pasrom/grabtastic/Electronic_Stuff/Datasheets/Atmel_Layout/Readme.txt

Filelist:
CAD_Source\* :Altium source files for the kit
Gerber\SAMD20_Xplained_Pro_release_rev6.GTL : Gerber file for Top Layer
Gerber\SAMD20_Xplained_Pro_release_rev6.GTO : Gerber file for Top Overlay (silkscreen)
Gerber\SAMD20_Xplained_Pro_release_rev6.GTP : Gerber file for Top Paste-mask
Gerber\SAMD20_Xplained_Pro_release_rev6.GTS : Gerber file for Top Solder-mask
Gerber\SAMD20_Xplained_Pro_release_rev6.GP1 : Gerber file for Internal Plane 1 (GND)
Gerber\SAMD20_Xplained_Pro_release_rev6.GP2 : Gerber file for Internal Plane 2 (PWR)
Gerber\SAMD20_Xplained_Pro_release_rev6.GBL : Gerber file for Bottom Layer
Gerber\SAMD20_Xplained_Pro_release_rev6.GBO : Gerber file for Bottom Overlay (silkscreen)
Gerber\SAMD20_Xplained_Pro_release_rev6.GBP : Gerber file for Bottom Paste-mask
Gerber\SAMD20_Xplained_Pro_release_rev6.GBS : Gerber file for Bottom Solder-mask
Gerber\SAMD20_Xplained_Pro_release_rev6.GM1 : Gerber file for Mechanical 1 layer (board outline)
SAMD20_Xplained_Pro_design_documentation_release_rev6.PDF : Schematic, PCB Prints, PCB 3D Prints, Assembly Drawings, BOM 
ExportSTEP\SAMD20_Xplained_Pro_release_rev6.STEP : 3D model of PCBA
