pasrom/grabtastic/Documenation/group_4_grabtastic/_invalid/group_4_grabtastic.tex

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

% XML

\usepackage{color}
\definecolor{gray}{rgb}{0.4,0.4,0.4}
\definecolor{darkblue}{rgb}{0.0,0.0,0.6}
\definecolor{cyan}{rgb}{0.0,0.6,0.6}
\lstdefinelanguage{XML}
{
  morestring=[b]",
  morestring=[s]{>}{<},
  morecomment=[s]{<?}{?>},
  stringstyle=\color{black},
  identifierstyle=\color{darkblue},
  keywordstyle=\color{cyan},
  morekeywords={xmlns,version,type}% list your attributes here
}

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

\renewcommand*{\chapterheadstartvskip}{\vspace*{-2\baselineskip}}% Abstand einstellen

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

\newcommand{\uC}{$\mu C$ }

\begin{document}

\pagenumbering{gobble} % seitenzahlnummerierung unterdrücken

% evtl. Sperrvermerkseite
%Falls erforderlich (nur in begründeten Fällen): Sperrvermerk

% Titelblatt:
\newpage
\begin{titlepage}
 %   \includegraphics[width=0.4\textwidth]{pictures/grabtastic.pdf}
  \mbox{}
  \vspace{5mm}
  \begin{center}
    \huge{\textbf{\sffamily Technical Documentation}} \\
    \huge{\textbf{\sffamily Group 4: Grabtastic}}\\
  \end{center}
  \vspace{40mm}
  \begin{flushright}
%  Bachelorarbeit [1 bzw. 2 anführen]\\
%  zur Erlangung des akademischen Grades\\
%  Bachelor of Science in Engineering (BSc)

  \vspace{20mm}
  Fachhochschule Vorarlberg\\
  Mechatronics

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

  \vspace{20mm}
  Dornbirn, December, 2015
  \end{flushright}
\end{titlepage}

%% evtl. Widmung:
%\chapter*{[Evtl. Widmung]}
%
%
%% Abstract:
%\newpage
\chapter*{Abstract}

The Grabtastic is built to grab a circular disc and then moved from one position to one other target position. These positions are predefined and can be two targets: home or \acs{Repository} position. Also the machine has to go to the reference position, but this cannot be done with the disc attached. Controlling the Grabtastic will be done with the \acs{PLC} and with the \acs{uC}. The \acs{PLC} will control the X and Y axis while the \acs{uC} will handle the movement of the Z axis. 

\pagenumbering{Roman} 

% Kurzreferat:
%\newpage
%\chapter*{Kurzreferat}
%[Deutschen Titel anführen]
%
%Formatvorlage für den Fließtext.

% evtl. Vorwort:
%\newpage
%\chapter*{[Evtl. Vorwort]}
%
\tableofcontents

\clearpage
\phantomsection
\addcontentsline{toc}{chapter}{List of Figures}
\listoffigures

\clearpage
\phantomsection
\addcontentsline{toc}{chapter}{List of Tables}
\listoftables
\addcontentsline{toc}{chapter}{Listings}
\lstlistoflistings

% evtl. Abkürzungsverzeichnis:
\newpage
\chapter*{List of Abbreviations}

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

\chapter{Introduction}
\pagenumbering{arabic} % seitenzahlnummerierung ab hier beginnen

This project started on the seventh of September 2015 and will end on the fifteenth of December. In this fifth semester of our studies, there is an exchange semester. This allows us to have a multi-cultural experience with different students from different backgrounds. It was our goal to combine our background experience to finish this project and also to learn how to work in an international project group.\\
The project was arranged by the FH Vorarlberg and lead by R. Amann. It consisted of building a manipulator that can pick up and drop a disc, it had to be controlled with a PLC. During the project the project group also participated in courses that supported the build of the project, for example: how to write a requirements document or how to program a PLC. Within this project there were certain boundaries for example the components that had to be used, but this also gave us more time to come up with creative solution for the remaining components. The system had to be built according to the system design that was given in the beginning of the project (\autoref{fig:system overview}).\\
To maintain the progress in this project we used a schedule that was given to us by the professors. This schedule contained deadlines for different results and general guidelines. Our first assignment in September was the requirements document, which consisted of the customer needs, requirements and our vision about the end result. In October we started designing all the components, this with the help of the courses there were earlier mentioned. After this we began manufacturing the parts that were designed until the end of November. Finally in December the testing of the build components and the assembly of these started. In the end of the project we are presenting our creation to the professors, students and other stakeholders. Therefore the manipulator had to be fully functional on the fifteenth of December. 

\section{Purpose}

This documentation is written for customers of project group \enquote{Grabtastic} to get  information of the manipulator we developed. The manipulator is used to pick up and place an aluminium disc, also move it in third dimention - X, Y, and Z axis. Every steps are made automatically.

\section{Scope}

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

\section{Overview}

The project group is named \enquote{Grabtastic}. The manipulator does one cycle at one time. Those are actions that the manipulator does for one cycle.

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

\section{References}

All drawings, charts, code listings and datasheets are indicated in the appendix.

\section{Division of the Tasks}

There are responsible people for each part (\autoref{tab:system overview with develop}).

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

\chapter{System Description}

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

\section{Product Overview}

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

For this product the project group decided that the Grabtastic should be able to function autonomously while the user only gives the command to move. Therefore it has to sense if the disc is grabbed or he has to get the disc from the \acs{Repository}, this is done with the strain gauge. The signal from the strain gauge will be amplified by the amplifier circuit and the send to the \acs{ADC} in the \acs{uC}. Then the \acs{RS232} communication will send this via a telegram to the \acs{PLC}, this is done via the \acs{SPI} protocol. The disc will be placed in the \acs{Repository} that is designed so the disc can be easily removed by the snap connection. When the Grabtastic moved to its target position the Z axis has to be moved in order to grab or release the disc, this is done via the designed Z axis and via the motor controller. The user is able to control and monitor the machine with the user interface that is made in the \acs{PLC}. All the components are installed on the brackets, which are placed on the base of the system above the Z-axis and the snap connection.

\section{System Overview}

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

\chapter{Mechanical Components}

\section{\acs{Repository}}\label{sec:repository}

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

\section{Z-Axis}

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

\subsection{Motorholder}
This part has several tasks to fulfil. The main function is to fix the stepper motor. In addition to this the holding elements for the \acs{uC} are attached to this part. \autoref{fig:motor frame side view} shows the holes which are used to fix the motor. 

  \begin{figure} [H]
        \centering
        \begin{subfigure}[b]{0.45\textwidth}
                \centering
                
                \caption{side view}\label{fig:motor frame side view}
        \end{subfigure}%
        ~ % An dieser Stelle kann ein zusätzlicher Zwischenraum eingebunden werden: ~, \quad, \qquad, \hfill usw.
          % Eine leere Zeile erzwingt, dass die zweite Grafik darunter erscheint.
        \begin{subfigure}[b]{0.45\textwidth}
                \centering
                
                \caption{front view}\label{fig:motor frame front view}
        \end{subfigure}
        \caption[Motor holder]{Motor holder\\
        Source: Group 4}\label{fig:motor frame}
  \end{figure}

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

\subsubsection{Calculation of the Force for Grab Cycle}

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

Now all values which are necessary for the calculation of the shear force are known. 

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

\subsubsection{Calculation for the Drop Cycle}

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

The calculation for the section modulus is exactly the same than in the point above.

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

\begin{eqnarray}
F_{ges} &=& 4 * F\\
F_{ges} &=& 4 * 2.097N = 8.389 N
\end{eqnarray}

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

\subsection{\acs{FEA}}

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

\chapter{Electronic Components}

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

\section{Schematic}

In the left top corner in \autoref{fig:scematic_power_rs232_strain.pdf} the linear voltage regulator can be found. There are two capacitors (C13, C14) are for bypassing\footnote{the values are chosen from the \enquote{LM1086} data sheet page 18}

\section{Calculation}

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

With  \autoref{eq: gain generally}  the necessary gain is calculated.

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

The \autoref{eq: gain calculation} is from the IN128UA1 Datasheet.

\begin{eqnarray}
G=1+ \frac{50k \Omega}{R_{g}}\label{eq: gain calculation}
\end{eqnarray}

With \autoref{eq: gain calculation} the $R_{g}$ is calculated.

\begin{eqnarray}
R_{g} =  \frac{50k \Omega}{G-1}\label{eq: Rg calculation}
\end{eqnarray}

With \autoref{eq: Rg calculation} the necessary $R_{g}$ is calculated as $75,8 \Omega$

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

As we can see, the telegram is transmitted correctly.

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

\subsection{Calculation}\label{sec:calculation_drv8711}

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

AS can be seen, the values are like we expected it.

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

As can bee seen, the \acs{SPI} works good.

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

\subsection{Measurement}

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

\subsection{Schematic}
In \autoref{fig:emergency and limit switch} is the schematic shown from the emergency relay and the limit switch. There was no need to do a PCB layout, because we soldered it just together.
\begin{figure}[H]
  \centering
   
   \caption[Emergency and limit switch schematic]{Emergency and limit switch schematic\\
	Source: Group 4  
  }
   \label{fig:emergency and limit switch}
\end{figure}

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

\chapter{\acs{PLC}-Program}

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

\begin{figure}[H]
  \centering
   
   \caption[Welcome screen]{Welcome screen\\
	Source: Group 4}
   \label{fig:start view}
\end{figure} 

\begin{figure}[H]
  \centering
   
   \caption[Automatic mode]{Automatic mode\\
	Source: Group 4}
   \label{fig:automatic mode}
\end{figure} 

\chapter{Communication \acs{PLC} - \acs{uC}}

\section{Configuration of \acs{RS232}}\label{sec: config of rs232}

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

\section{Telegram from \ac{uC} to \ac{PLC}}
The telegram looks like the following:\\
<respond>/<$\#$ force value>/<z-axis position>/<error>\textbackslash r \textbackslash n
\begin{itemize}
\item The delimiter / is used to separate each value.
\item \textbackslash r \textbackslash n are used as suffix.
\item $\#$ to mark the value as force
\end{itemize}

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

\section{Heartbeat}

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

\chapter{\acs{uC} Program}

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

Used parts of the \acs{ASF}:

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

\begin{table}[H]
\centering
\begin{tabular}{|p{2.5cm}|p{2.8cm}|p{5.8cm}|p{3.5cm}|}
\hline
Pin on EXT2 & SAM D20 pin & Function                & Used for                 \\ \hline
5           & PA20        & GPIO                    & DRV8711 Sleep            \\ \hline
6           & PA21        & GPIO                    & DRV8711 reset            \\ \hline
7           & PA22        & TC4/WO[0]               & DRV8711 \acs{TC}         \\ \hline
9           & PB14        & EXTINT[14]              & DRV8711 change direction \\ \hline
15          & PA17        & SERCOM1 PAD[1] SPI SS   & DRV8711 SPI              \\ \hline
16          & PA18        & SERCOM1 PAD[2] SPI MOSI & DRV8711 SPI              \\ \hline
17          & PA16        & SERCOM1 PAD[0] SPI MISO & DRV8711 SPI              \\ \hline
18          & PA19        & SERCOM1 PAD[3] SPI SCK  & DRV8711 SPI              \\ \hline
19          & -           & GND                     &                          \\ \hline
20          & -           & VCC                     &                         \\ \hline
\end{tabular}
\caption{EXT2 used pins}
\label{fig:EXT2 used pins}
\end{table}

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

\section{Calculations}

\subsection{Sampling Rate of the \acs{ADC}}

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

With the reciprocal value the sampling rate is calculated.

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

$0,125ms$ are fast enough to measure the force.

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

\section{Main Loop}

In \autoref{fig:Mainprogramm.pdf} the loop of the main program is shown according to the \acs{UML} standards.
\begin{figure}[H]
  \centering
   
   \caption[UML Diagram \acs{uC}]{UML Diagram \acs{uC}\\
	Source: Group 4  
   }
   \label{fig:Mainprogramm.pdf}
\end{figure} 
\section{Programmed Functions}

\autoref{fig:h dateien} shows the included header files.

\begin{figure}[H]
  \centering
   
   \caption[included header files]{Included header files\\
	Source: Group 4  
   }
   \label{fig:h dateien}
\end{figure} 
The config$\_$focus$\_$fhv.t is developed by us. The callgraph of the main loop is shown in \autoref{fig:main call graph program}.\\
\begin{enumerate}
\item all configuration is loaded
\item main loop starts
\item start a request to read the receive buffer of \acs{RS232}
\item execute the received order
\item repositioning if we are in the limit switch in case of referencing
\item finish the order
\item start repositioning when down
\item send the telegram
\begin{enumerate}
\item error handling
\item prepare the telegram for sending
\item start a request to send the write buffer of \acs{RS232}
\end{enumerate}
\end{enumerate}

\begin{figure}[H]
  \centering
   
   \caption[Called functions \acs{uC}]{Called functions \acs{uC}\\
	Source: Group 4  
   }
   \label{fig:main call graph program}
\end{figure} 

\section{DRV8711 Register Settings}\label{DRV8711 register settings}

In \autoref{fig:DRV8711 registers} the adjusted values for the DRV8711 are shown.

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

\subsection{Speed Calculation}

\begin{eqnarray}
f_{steps} \, \mu steps /s &=& \frac{v*360^{\circ}*n_{m}}{60s/min*\phi \, ^{\circ}/step}\\
\rightarrow v &=& \frac{60 s / min*\phi \, ^{\circ}/step * f_{steps} \, \mu steps /s}{360^{\circ}*n_{m}}
\end{eqnarray}
$v ... rotations/min$\\
With following values the speed is calculated\footnote{found in the motor data sheet and \autoref{eq:frequency1}, \autoref{eq:frequency2}}\\
$\phi =1,8^{\circ}/step$\\
$n_{m}=1$\\
$f_{steps \, 1} = 421Hz$\\
$f_{steps \, 2} = 526Hz$
\begin{eqnarray}
v_{1} &=& \frac{60 s / min * 1,8 \, ^{\circ}/step * 421 \, \mu steps /s}{360^{\circ}*1}=126,3 \, rot/min\\
v_{2} &=& \frac{60 s / min * 1,8 \, ^{\circ}/step * 421 \, \mu steps /s}{360^{\circ}*1}=157,9 \, rot/min
\end{eqnarray}
\subsection{Conclusion DRV8711}
The discerning reader will also have noticed that the register settings did not match the calculations. The reason therefore is, that the motor is not turning smooth with the calculated values. We had to change them to our needs.

\chapter{Results}

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

%\section{Problems with mechanical construction}

%\section{Problems with \acs{PLC}}

%\section{Problems with \acs{uC}}

\section{Test runs}
The system runs as described in the requirements document.

\section{Mechanic}
In \autoref{fig:mechanic assembly} the finished Z-axis is shown.
  \begin{figure} [H]
        \centering
        \begin{subfigure}[b]{0.45\textwidth}
                \centering
                
              %  \caption{mechanic assembly}\label{fig:Seitl_1}
        \end{subfigure}%
        ~ % An dieser Stelle kann ein zusätzlicher Zwischenraum eingebunden werden: ~, \quad, \qquad, \hfill usw.
          % Eine leere Zeile erzwingt, dass die zweite Grafik darunter erscheint.
        \begin{subfigure}[b]{0.45\textwidth}
                \centering
                
               % \caption{register 4-7}\label{fig:Seitl_2}
        \end{subfigure}
        \caption[Mechanic assembly]{Mechanic assembly\\
         Source: Group 4}\label{fig:mechanic assembly}
  \end{figure}
  \newpage
   In \autoref{fig:rep_side_view} and \autoref{fig:rep_top_view} is the finished \acs{Repository} shown.
  \begin{figure}[H]
  \centering
   
   \caption[Finished \acs{Repository} top view]{Finished \acs{Repository} top view\\
	Source: Group 4  
   }
   \label{fig:rep_top_view}
\end{figure} 

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

\newpage

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

\chapter{Discussion}

In this chapter there will be given some problems that were faced during this project and how they were approached and solved.\\
For the mechanical part of this projects two problems occurred that affected the progress of the project. The first problem that was faced was the purchase of the linear axis which had to be bought with a shipment time of two weeks. This halted the progress for about two weeks and gave some time to focus more on the different aspects of the project like the \acs{Repository} and the manufacturing of the parts. And next there was a problem with the snap connection which was designed for the correct forces that were applied on it. The arms of the snapper are bended a little bit to the middle. Therefore the outer diameter of the snapper was just a little bit bigger than the hole in the disc. So the snapper was not able to hold the disc. The solution for this problem was a little aluminium rod with a diameter of $12mm$ which we set into the snap connector. This small rod bends the arms of the snapper to his original position and so the snapper was able to hold the disc.\\
Despite the problems that were faced for the mechanical part, the electronical part also suffered from some problems. The Atmel board and a DRV8711 broke shortly after the PCB was designed and a new board had to be used, this was caused by an overvoltage on the board. Also multiple parts were fried during the testing of the board, this was caused by a faulty connection or a short circuit. This never broke the board down completely and did not give major setbacks. The biggest problem was, that a view “vias” on the PCB did not conduct correctly. Therefore the charge pump of the DRV8711 did not work at the beginning when the board was recently manufactured. Moreover the pick and place machine did not solder two capacitors and the \enquote{MAX232}, therefore the board did not work correctly. This was caused by the charge pump because that did not work properly at the time.\\
As for the programming of the \acs{uC} and the \acs{PLC}the biggest problem was that we did not know how to use the \acs{ASF} library. But this was solved by using and studying the example programs that were provided by the Atmel studio.
Finally, we had some problems with the requirement document. It was not completely clear to us what we had to put in the document. This followed in editing the document several times which took some time. In the end the document was finished and we were all pleased with the result. In the end we changed some aspect of this document mostly because some names were changed during the project or that an extra safety principle was added in the use cases. Also we added some requirements about tolerances, this was done so this is also clear to the customer.

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

%\chapter*{[Evtl. Anhang]}
%\addcontentsline{toc}{chapter}{[Evtl. Anhang]}
%Formatvorlage für den Fließtext.

%\chapter*{Eidesstattliche Erklärung}
%\addcontentsline{toc}{chapter}{Eidesstattliche Erklärung}
%Ich erkläre hiermit an Eides statt, dass ich die vorliegende Bachelorarbeit selbstständig und ohne Benutzung anderer als der angegebenen Hilfsmittel angefertigt habe. Die aus fremden Quellen direkt oder indirekt übernommenen Stellen sind als solche kenntlich gemacht. Die Arbeit wurde bisher weder in gleicher noch in ähnlicher Form einer anderen Prüfungsbehörde vorgelegt und auch noch nicht veröffentlicht.
%
%\vspace{30mm}
%\noindent
%Verfasser/in\hfill                                       Unterschrift Verfasser/in
%
%\vspace{3mm}
%\noindent
%Dornbirn, am [Tag. Monat Jahr anführen]\hfill            Vor- und Nachname Verfasser/in
\appendix
\chapter{mechanics}
\section{drawings}
\begin{landscape}
\includepdf[pages={1-}]{datasheets/mechanical/psi5321_asseblyAxisGes.pdf}
\includepdf[pages={1-}]{datasheets/mechanical/psi5321_disk.pdf}
\includepdf[pages={1-}]{datasheets/mechanical/psi5321_frame1.pdf}

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

\section{\acs{ASF} library}

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

\section{Register settings Atmel}

\href{http://www.atmel.com/images/atmel-42129-sam-d20_datasheet.pdf}{Atmel SAM D20 Register Settings}

\chapter{\acs{PLC}}

\section{Program}
\include{listings/PLC_listings}

\section{Datasheets}

\includepdf[pages={1-}]{datasheets/PLC/Product_Overview_NOE2-2.pdf}
\includepdf[pages={1-}]{datasheets/PLC/ST5918M3008-A.pdf}

\end{document}
