pasrom/grabtastic/Documenation/UML/Electronic_overview.pdf

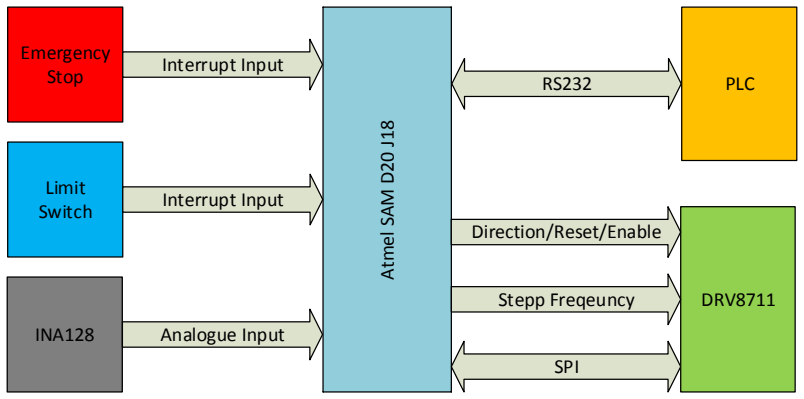
[picture p39: figure]
Atmel SAM D20 J18; SPI; DRV8711; PLC; Emergency; Stop; Interrupt Input; Direction; /Reset; /Enable; Stepp Freqeuncy; Limit; Switch; INA128; Analogue Input
