pasrom/grabtastic/Documenation/UML/Interrupt.pdf

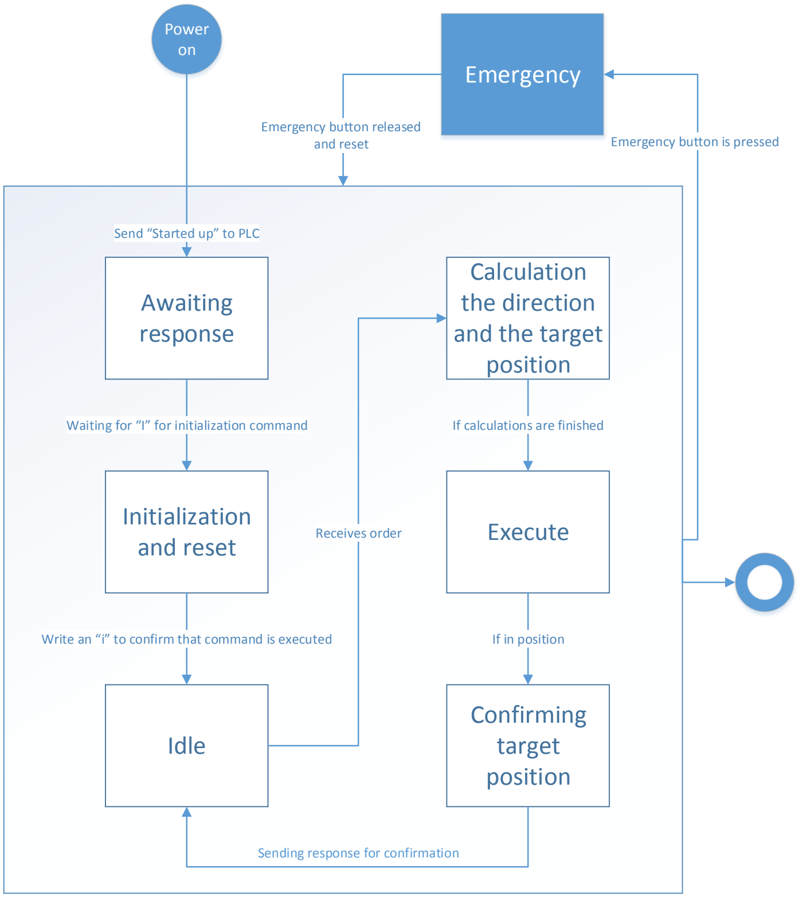
[picture p40: figure]
Execute; Power on; Calculation the direction and the target position; Initialization and reset; Idle; Awaiting response; Send “Started up” to PLC; Receives order; If calculations are finished; Confirming target position; If in position; Sending response for confirmation; Emergency; Emergency button released and reset Emergency button is pressed

Waiting for “I” for initialization command

Write an “i” to confirm that command is executed
