pasrom/grabtastic/Electronic_Stuff/calc_strain_gauge.xlsx

 | Grün (V) | Weiß (V) | Differenz (V) | Differenz (mV) | Eingang mV | Ausgang V
Normal | 2.088 | 2.063 | 0.025 | 25 | 25.4873 | 3.919 | 153.7628544
Zug | 2.084 | 2.066 | 0.018 | 18 | 22 | 3.891 | 176.8636364
Druck | 2.094 | 2.055 | 0.039 | 39 | 29 | 3.941 | 135.8965517
 |  |  |  |  |  |  | mV | Auflösung pro digit | Mittelpunkt V | min | max
 |  |  |  |  |  |  | 5 | 0.5 | 2.5 | 2.4975 | 2.5025
 |  |  |  |  |  |  |  | Gain |  | 0.0025 | 0.0025 | Range | Rang from uC
 |  |  |  |  |  |  |  | 660 |  | 1.65 | 1.65 | 0V-3,3V | 0V-3,3V
 |  |  |  |  |  |  |  | Rg
 |  |  |  |  |  |  |  | 75.87253414 | 20000 | N | 9990.224829
 |  |  |  |  |  |  | Scalingfactor | 0 | 1023 | digits | 511
 |  |  |  |  |  |  |  |  |  | 1024
 |  |  |  |  |  |  |  |  | 19.55034213
