pasrom/grabtastic/Documenation/group_4_grabtastic/pictures/grabtastic.pdf

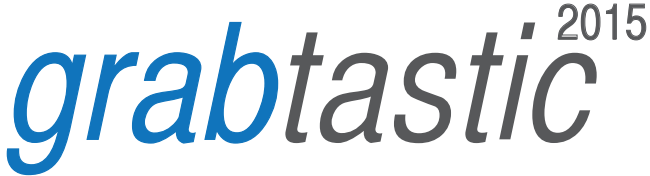
[picture p41: figure]
grabtastic²⁰¹⁵
