pasrom/grabtastic/Documenation/group_4_grabtastic/pictures/hDateien.pdf

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

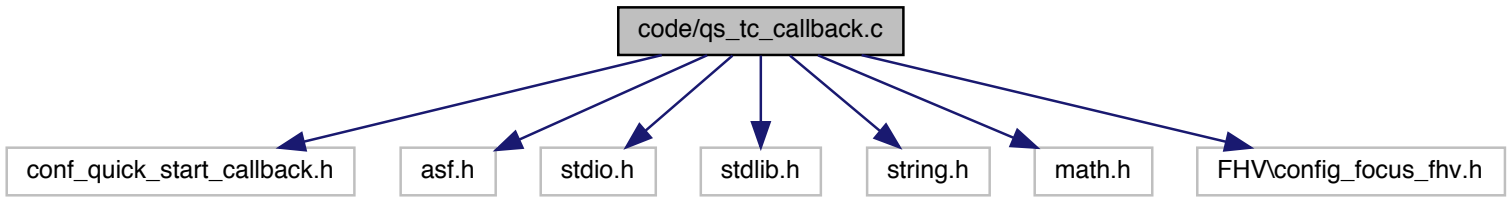
[picture p42: figure]
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
