pasrom/grabtastic/Documenation/group_4_grabtastic/pictures/Mainprogramm.png

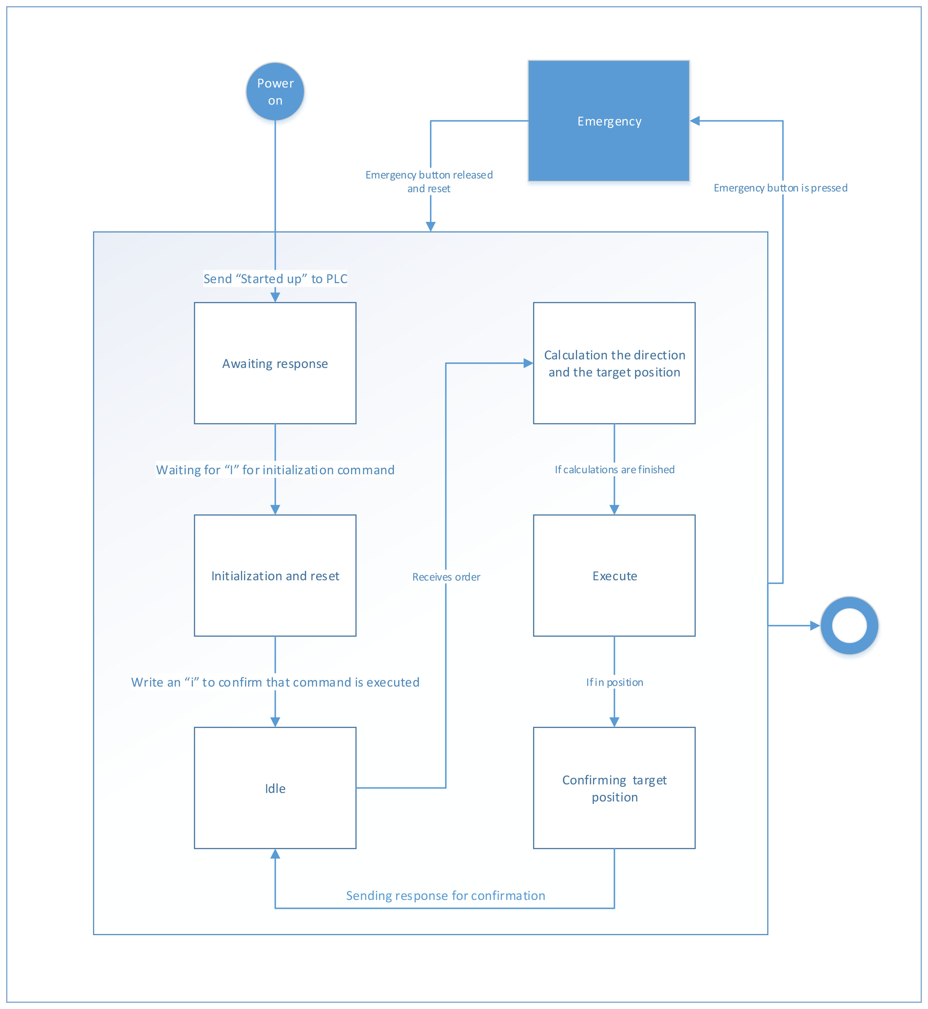
Documenation/group_4_grabtastic/pictures/Mainprogramm.png
