pasrom/grabtastic/Documenation/group_4_grabtastic/pictures/pcb_mounting_2.png

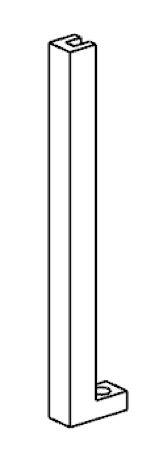
Documenation/group_4_grabtastic/pictures/pcb_mounting_2.png
