pasrom/grabtastic/Documenation/group_4_grabtastic/pictures/scematic_drv8711.png

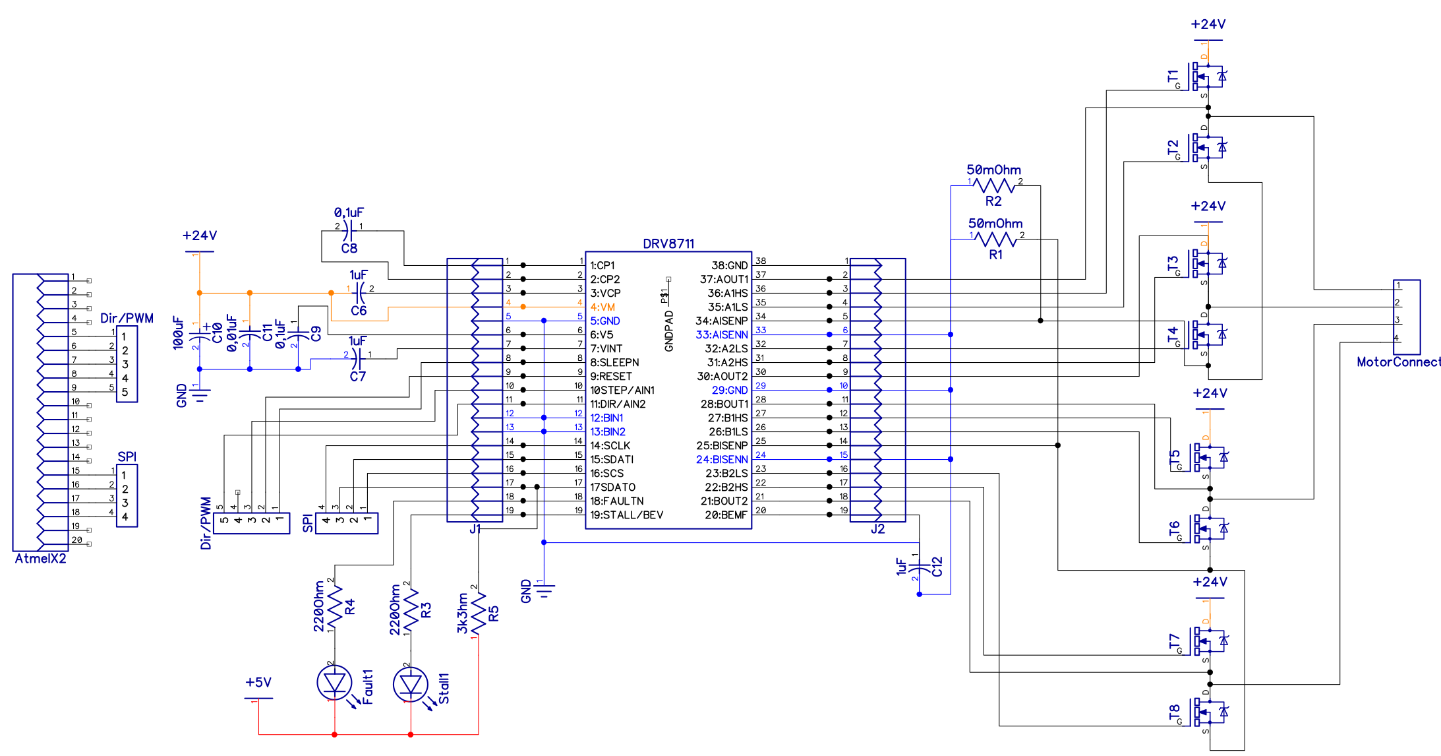
Documenation/group_4_grabtastic/pictures/scematic_drv8711.png
