pasrom/grabtastic/Documenation/group_4_grabtastic/pictures/spi_v0_0_1.png

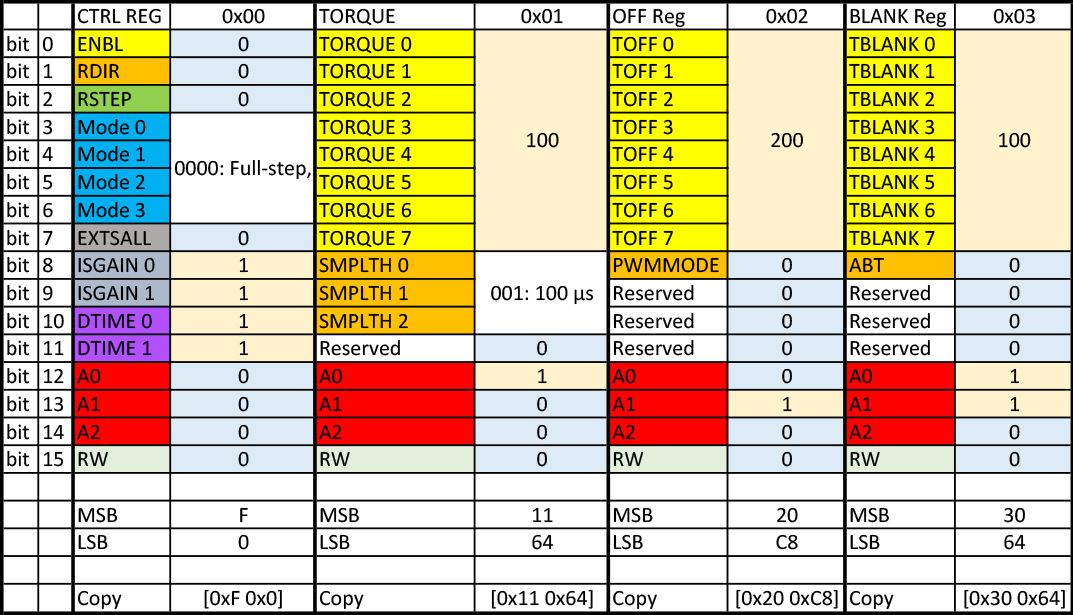
Documenation/group_4_grabtastic/pictures/spi_v0_0_1.png
