pasrom/grabtastic/Electronic_Stuff/PCB_Layout/Screenshot 2015-10-02 13.58.50.png

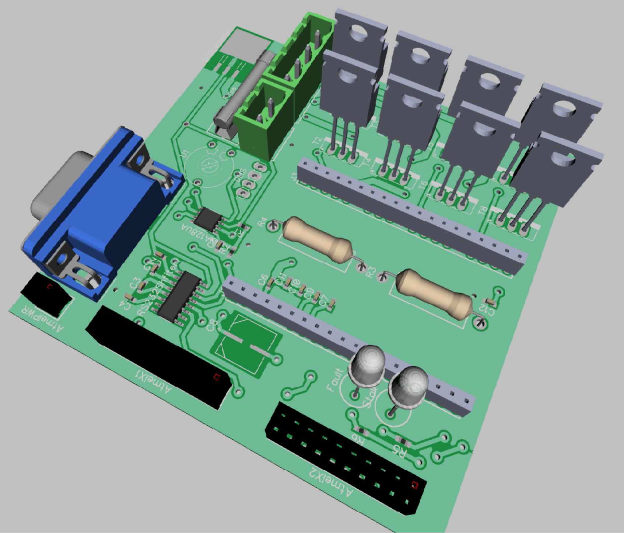
Electronic_Stuff/PCB_Layout/Screenshot 2015-10-02 13.58.50.png
