pasrom/grabtastic/Mechanical_Stuff/repositoryDesign/Drafting_Modified/BoltandNut/Bolt in lower part.jpg

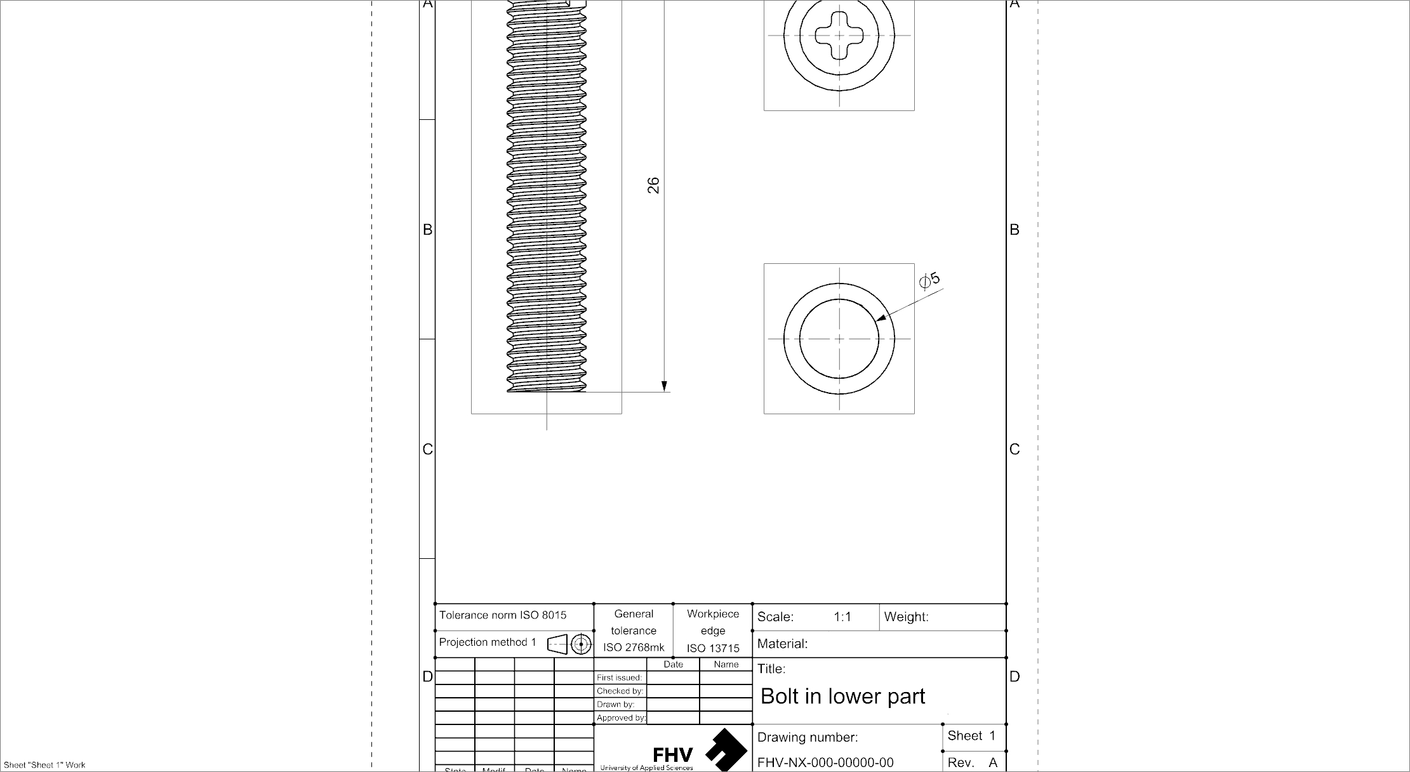
Mechanical_Stuff/repositoryDesign/Drafting_Modified/BoltandNut/Bolt in lower part.jpg
