pasrom/grabtastic/Mechanical_Stuff/repositoryDesign/Drafting_Modified/BoltandNut/Bolt in upper part.jpg

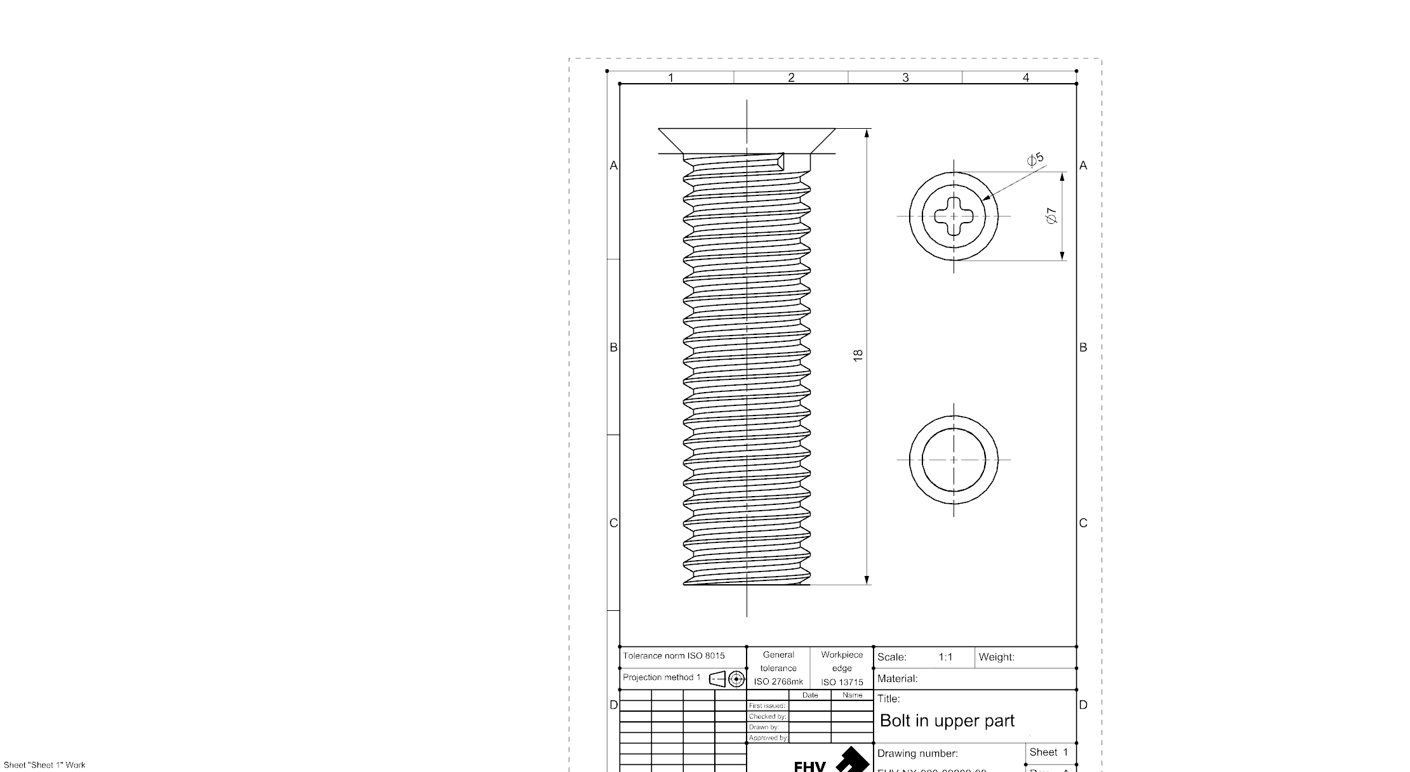
Mechanical_Stuff/repositoryDesign/Drafting_Modified/BoltandNut/Bolt in upper part.jpg
