pasrom/grabtastic/Mechanical_Stuff/repositoryDesign/Drafting_Modified/BoltandNut/Nut_between_plates.jpg

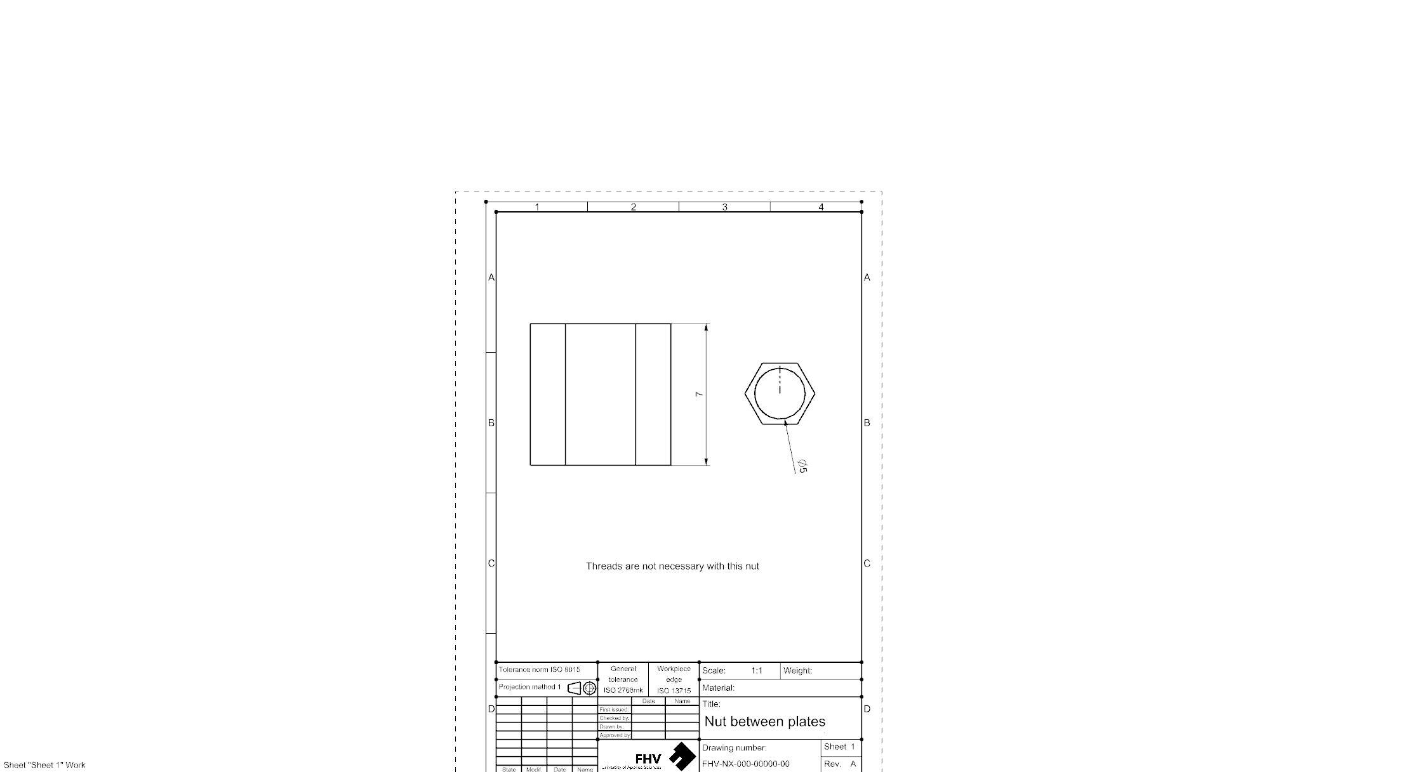
Mechanical_Stuff/repositoryDesign/Drafting_Modified/BoltandNut/Nut_between_plates.jpg
