pasrom/grabtastic/Mechanical_Stuff/repositoryDesign/Drafting_Modified/BoltandNut/Nut_in_lower_part.jpg

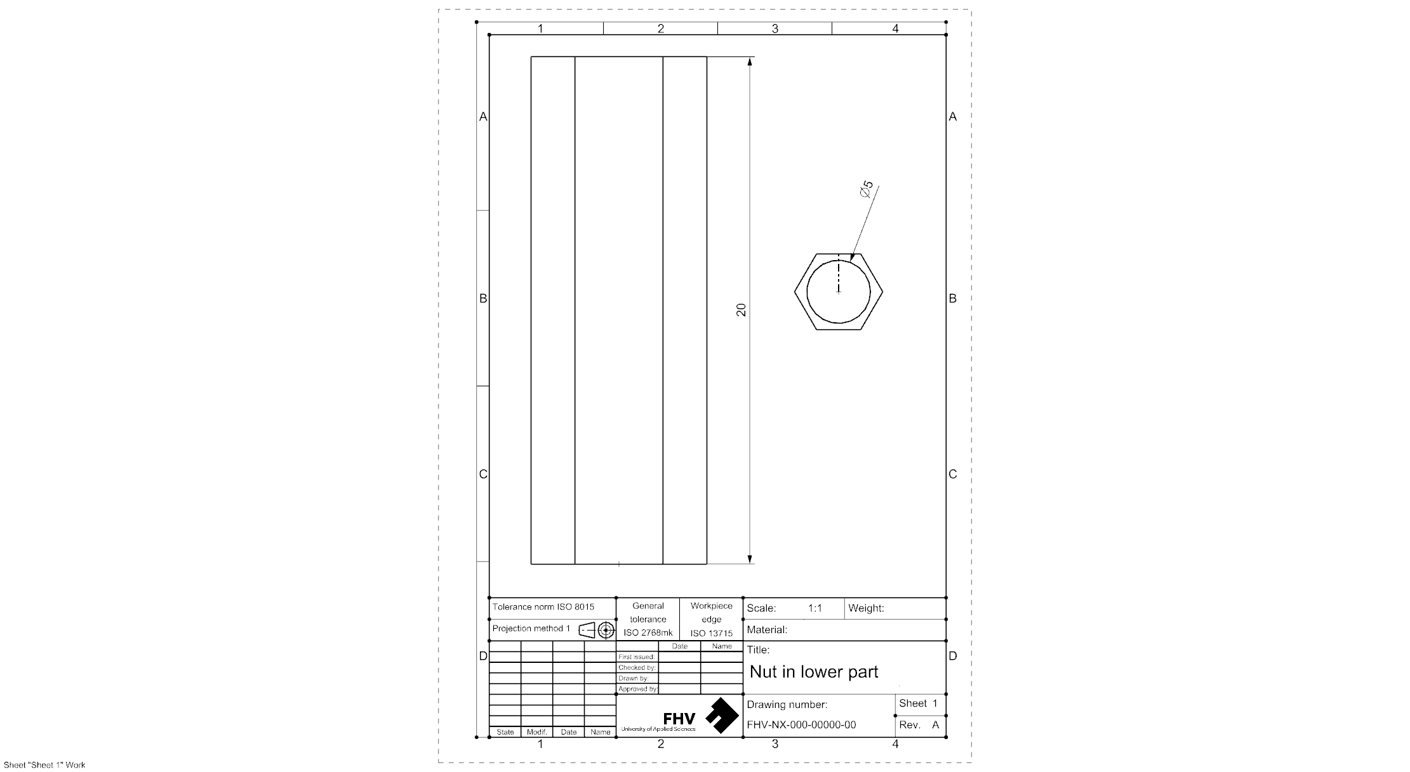
Mechanical_Stuff/repositoryDesign/Drafting_Modified/BoltandNut/Nut_in_lower_part.jpg
