pasrom/grabtastic/Mechanical_Stuff/repositoryDesign/Drafting_Modified/BoltandNut/shortnut.jpg

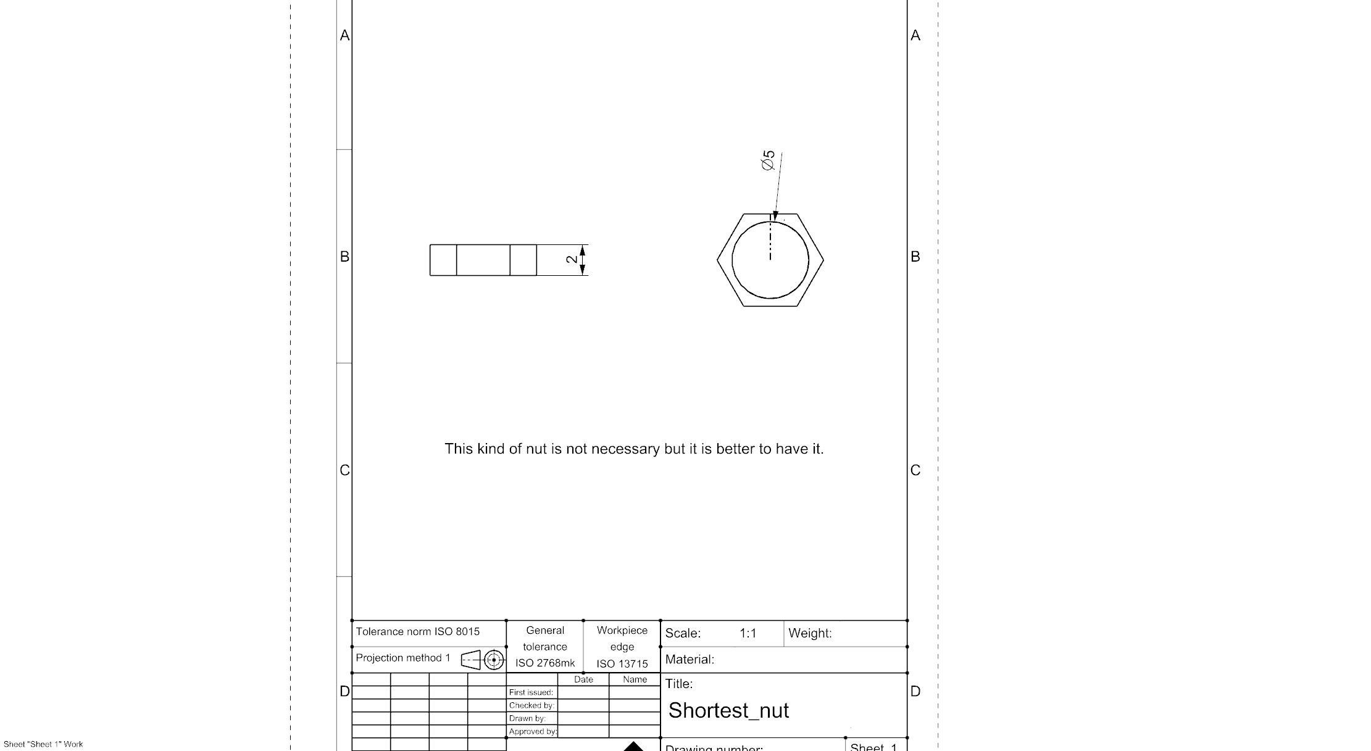
Mechanical_Stuff/repositoryDesign/Drafting_Modified/BoltandNut/shortnut.jpg
