pasrom/grabtastic/PLC/Motr_Drivers/Welcome1080.png

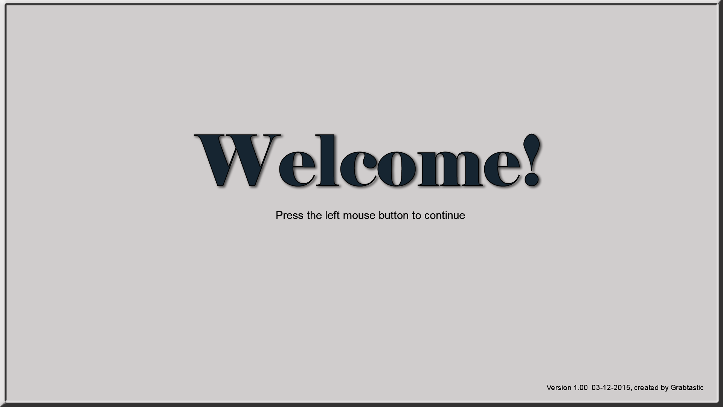
PLC/Motr_Drivers/Welcome1080.png
