pasrom/grabtastic/Microcontroller/spi_v0_0.xlsx

Sheet: Telegram
 |  |  |  |  |  |  |  | 48 |  | 128 |  | 16 |  | 64
 |  |  | CTRL REG | 0x00 | TORQUE | 0x01 | OFF Reg | 0x02 | BLANK Reg | 0x03 | DECAY Reg | 0x04 | Stall Reg | 0x05 | Drive | 0x06 | Status | 0x07
 | bit | 0 | ENBL | 0 | TORQUE 0 | 100 | TOFF 0 | 200 | TBLANK 0 | 100 | TDECAY 0 | 50 | SDTHR 0 | 64 | OCPTH 0 | 0 | OTS | 0
 | bit | 1 | RDIR | 0 | TORQUE 1 |  | TOFF 1 |  | TBLANK 1 |  | TDECAY 1 |  | SDTHR 1 |  | OCPTH 1 | 0 | AOCP | 0
 | bit | 2 | RSTEP | 0 | TORQUE 2 |  | TOFF 2 |  | TBLANK 2 |  | TDECAY 2 |  | SDTHR 2 |  | OCPDEG 0 | 1 | BOCP | 0
TOFF | bit | 3 | Mode 0 | 0000: Full-step, 71% current | TORQUE 3 |  | TOFF 3 |  | TBLANK 3 |  | TDECAY 3 |  | SDTHR 3 |  | OCPDEG 1 | 0 | APDF | 0 | Decmode
100.5us | bit | 4 | Mode 1 |  | TORQUE 4 |  | TOFF 4 |  | TBLANK 4 |  | TDECAY 4 |  | SDTHR 4 |  | TDRIVEN 0 | 0 | BPDF | 0 | 000: Force slow decay at all times
TBLANK | bit | 5 | Mode 2 |  | TORQUE 5 |  | TOFF 5 |  | TBLANK 5 |  | TDECAY 5 |  | SDTHR 5 |  | TDRIVEN 1 | 1 | UVLO | 0 | 001: Slow decay for increasing current, mixed decay for decreasing current (indexer mode only)
2.02us | bit | 6 | Mode 3 |  | TORQUE 6 |  | TOFF 6 |  | TBLANK 6 |  | TDECAY 6 |  | SDTHR 6 |  | TDRIVEP 0 | 0 | STD | 0 | 010: Force fast decay at all times
TDECAY | bit | 7 | EXTSALL | 0 | TORQUE 7 |  | TOFF 7 |  | TBLANK 7 |  | TDECAY 7 |  | SDTHR 7 |  | TDRIVEP 1 | 1 | STDLAT | 0 | 011: Use mixed decay at all times
25.5us | bit | 8 | ISGAIN 0 | 1 | SMPLTH 0 | 001: 100 μs | PWMMODE | 0 | ABT | 0 | DECMOD 0 | 000: Force slow decay at all times | SDCNT 0 | 0 | IDRIVEN 0 | 1 | Reserved | 0 | 100: Slow decay for increasing current, auto mixed decay for decreasing current (indexer mode only)
 | bit | 9 | ISGAIN 1 | 1 | SMPLTH 1 |  | Reserved | 0 | Reserved | 0 | DECMOD 1 |  | SDCNT 1 | 0 | IDRIVEN 1 | 0 | Reserved | 0 | 101: Use auto mixed decay at all times
 | bit | 10 | DTIME 0 | 1 | SMPLTH 2 |  | Reserved | 0 | Reserved | 0 | DECMOD 2 |  | VDIV 0 | 0 | IDRIVEP 0 | 1 | Reserved | 0
 | bit | 11 | DTIME 1 | 1 | Reserved | 0 | Reserved | 0 | Reserved | 0 | Reserved | 0 | VDIV 1 | 0 | IDRIVEP 1 | 0 | Reserved | 0
 | bit | 12 | A0 | 0 | A0 | 1 | A0 | 0 | A0 | 1 | A0 | 0 | A0 | 1 | A0 | 0 | A0 | 1 | Back EMF sample threshold
 | bit | 13 | A1 | 0 | A1 | 0 | A1 | 1 | A1 | 1 | A1 | 0 | A1 | 0 | A1 | 1 | A1 | 1 | 000: 50 μs
 | bit | 14 | A2 | 0 | A2 | 0 | A2 | 0 | A2 | 0 | A2 | 1 | A2 | 1 | A2 | 1 | A2 | 1 | 001: 100 μs
 | bit | 15 | RW | 0 | RW | 0 | RW | 0 | RW | 0 | RW | 0 | RW | 0 | RW | 0 | RW | 0 | 010: 200 μs
 |  |  |  |  |  |  |  |  |  |  |  |  |  |  |  |  |  |  | 011: 300 μs
 |  |  | MSB | F | MSB | 11 | MSB | 20 | MSB | 30 | MSB | 40 | MSB | 50 | MSB | 65 | MSB | 70 | 100: 400 μs
 |  |  | LSB | 0 | LSB | 64 | LSB | C8 | LSB | 64 | LSB | 32 | LSB | 40 | LSB | A4 | LSB | 0 | 101: 600 μs
 |  |  |  |  |  |  |  |  |  |  |  |  |  |  |  |  |  |  | 110: 800 μs
 |  |  | Copy | [0xF 0x0] | Copy | [0x11 0x64] | Copy | [0x20 0xC8] | Copy | [0x30 0x64] | Copy | [0x40 0x32] | Copy | [0x50 0x40] | Copy | [0x65 0xA4] | Copy | [0x70 0x0] | 111: 1000 μs
 |  |  | Mit ENBL | [0xF 0x1]
 |  |  | MSB | 10000000 | MSB | 10010000 | MSB | 10100000 | MSB | 10110000 | MSB | 11000000 | MSB | 11010000 | MSB | 11100000 | MSB | 11110000 | MODE
 |  |  | Copy | {0x80 0x00] | Copy | {0x90 0x00] | Copy | {0xA0 0x00] | Copy | {0xB0 0x00] | Copy | {0xC0 0x00] | Copy | {0xD0 0x00] | Copy | {0xE0 0x00] | Copy | {0xF0 0x00] | 0000: Full-step, 71% current
 |  |  |  | , |  |  |  |  |  |  |  |  |  |  |  |  |  |  | 0001: Half step
 |  |  | uC write | 0xF, 0x0 |  | 0x11, 0x64 |  | 0x20, 0xC8 |  | 0x30, 0x64 |  | 0x40, 0x32 |  | 0x50, 0x40 |  | 0x65, 0xA4 |  | 0x70, 0x0 | 0010: 1/4 step
 |  |  | uC read | 0x80, 0x00 |  | 0x90, 0x00 |  | 0xA0, 0x00 |  | 0xB0, 0x00 |  | 0xC0, 0x00 |  | 0xD0, 0x00 |  | 0xE0, 0x00 |  | 0xF0, 0x00 | 0011: 1/8 step
 |  |  |  |  |  |  |  |  |  |  |  |  |  |  |  |  |  |  | 0101: 1/32 step
 |  |  |  |  | SEND REG: | [0xF 0x0][0x11 0x64][0x20 0xC8][0x30 0x64][0x40 0x32][0x50 0x40][0x65 0xA4][0x70 0x0][0xF 0x1] |  |  |  |  |  |  |  |  |  |  |  |  | 0110: 1/64 step
 |  |  |  |  | RECEIVE STATUS: | {0x80 0x00]{0x90 0x00]{0xA0 0x00]{0xB0 0x00]{0xC0 0x00]{0xD0 0x00]{0xE0 0x00]{0xF0 0x00] |  |  |  |  |  |  |  |  |  |  |  |  | 0111: 1/128 step
 |  |  |  |  |  |  |  |  |  |  |  |  |  |  |  |  |  |  | 1000: 1/256 step
 |  |  |  |  |  |  |  |  |  |  |  |  | für uC |  |  | [0x65 0xA4][0x70 0x0]
 |  |  |  |  |  | [0xF 0x0][0x11 0x64][0x70 0x0][0xF 0x1] |  |  |  |  |  |  | volatile static uint8_t wr_drv8711Defaults[] = {0xF, 0x0, 0x11, 0x64, 0x20, 0xC8, 0x30, 0x64, 0x40, 0x32, 0x50, 0x40, 0x65, 0xA4, 0x70, 0x0};
 |  |  |  |  |  |  |  |  |  | C0 | 11000000 |  | uint8_t wr_drv8711Read[] = {0x80, 0x00, 0x90, 0x00, 0xA0, 0x00, 0xB0, 0x00, 0xC0, 0x00, 0xD0, 0x00, 0xE0, 0x00, 0x70, 0x0};
 |  |  |  |  | Funktioniert: | [0xC 0x10][0x10 0x3][0x70 0x0][0xC 0x11] |  |  |  |  |  |  |  |  |  |  |  |  | Dead time set
 |  |  |  |  | PWM 2 kHz |  |  |  |  |  |  |  |  |  |  |  |  |  | 00: 400 ns dead time
 |  |  |  |  |  |  |  |  |  |  |  |  |  |  |  |  |  |  | 01: 450 ns dead time
 |  |  |  |  |  |  |  |  |  |  | 255 | 1500 |  |  |  |  |  |  | 10: 650 ns dead time
 |  |  |  |  |  |  |  |  |  |  | 17 | 100 |  |  |  |  |  |  | 11: 850 ns dead time
 |  |  |  |  | max Frequenz | 2,5kHz
 |  |  |  |  | Bei | #define treshholdAccelerateUp 8300
 |  |  |  |  | Bei | #define treshholdAccelerateDown 7580
 |  |  |  |  |  | volatile static uint8_t wr_drv8711Defaults[] = {0xF, 0x0, 0x11, 0x1E, 0x20, 0x30, 0x30, 0x80, 0x45, 0x4, 0x50, 0x40, 0x65, 0xA4, 0x70, 0x0};
 |  |  |  |  | es läuft stabil...
 |  |  |  |  | eventuell strom noch anpassen

Sheet: Ifs
Torque | 100 |  |  | Torque
ISGAIN | 40 |  |  | 0 | 5
Rsense | 50 | mOhm |  | 1 | 10
Ifs(A) | 0.537109375 | A | 2.1484375 | 2 | 20
 |  |  |  | 3 | 40
Torque | 2
ISGAIN | 5
Rsense | 50 | mOhm
Ifs(A) | 0.0859375 | A
L_L | 5.2 | mH
R_L | 1.4 | Ohm
VM(V) | 24 | V
R_DS_ON | 0.27 | mOhm | 0.00027
R_SENSE | 50 | mOhm | 0.05
 |  |  | 1.45027
I_FS(A) | 16.54556234

Sheet: Drive Reg
rs | 63 | ns
Qg | 30 | nC
Idrive > | 476.1904762 | mA |  | 50 | mA
TDRIVE > | 126 | ns |  | 1000 | ns
 |  |  | Bin | from table
DTIME | 850 | ns
TBLANK | 100 | us
TOFF | 200 | us | 11001000
 | 1508.5 | nC |  |  |  | v | 120 | rot/min | 2 | rot/s
 | 1510 | nC |  |  |  | n_m | 8 | usteps/step
 |  |  |  |  |  | steps | 1.8 | °/step
 |  |  |  |  |  | f_step | 3200 | usteps/s

Sheet: Sheet1
Distanz | 80 | mm
Steigung | 1.5 | mm |  |  |  | 150 | °C
 |  |  |  |  |  | 25 | °C
oneSpin | 400 |  | 80 | x |  | 0.27 | Ohm
 | 21333.33333 |  | 1.5 | 400 |  | 80 | °C/W | 353.15 | K/W
 |  |  |  |  |  | 5.787037037
 |  |  |  |  |  | 2.405626122
 | 400 |  | x | 21000
 | 78.75 |  | 1.5 | 400
 |  |  |  |  |  | 125 | °C
 |  |  |  |  |  | 25 | °C
 |  | 1000 |  | 2150.537634 | IL | 50 | mA
 |  | 465 | 1000 |  | Rtherm | 40.8 | °C/W |  | PD=(Vin-Vout)*IL
 |  |  |  |  | Vin | 24 | V
 |  |  |  |  | Vout | 5 | V
 |  |  |  |  | Ilmax | 0.128998968 | A |  | Rtherm=(Tj-Ta)/PD=(Tj-Ta)/((Vin-Vout)*IL)
 |  |  |  |  |  |  |  |  | >IL=(Tj-Ta)/((Vin-Vout)*Rtherm)

Sheet: bill of materials
definition in circuit | Value | Name | Quantity
AtmelPWR |  | PPTC022LFBN-RC | 1
AtmelX1, AtmelX2, AtmelX3 |  | PPTC102LFBN-RC | 3
C1, C2, C3, C4, C5, C6, C7, C12, C15 | 1uF | CAP_0603 | 9
C8, C9 | 0,1uF | CAP_0603 | 2
C10 | 100uF | EEE--CASE-E | 1
C11 | 0,01uF | CAP_0603 | 1
C13, C14 | 10uF | CAP_1206 | 2
C16, C17 | 100nF | CAP100 | 2
DMSConnector |  | PINHD-1X4 | 1
DRV8711 |  | DRV8711 | 1
EmergencyStop24V, EmergencyStoptouC, LimitSwitch |  | HDR-1x2 | 3
Fault1, Stall1 |  | LED | 2
Fuse1 |  | Fuse | 1
INA128UA1 |  | INA128UA | 1
J1, J2 |  | HDR-1x19 | 2
linearVoltageRegulator |  | LM1086IS-5.0 | 1
MotorConnector |  | MSTB 2-5-5,08x4 | 1
Power24V |  | MSTB 2-5-5,08x2 | 1
R1, R2 | 50mOhm | PowerResistor | 2
R3, R4 | 220Ohm | RES_0603 | 2
R5 | 3k3Ohm | RES_0603 | 1
R6, U1 | 500Ohm | POT | 2
Relais |  | Schrack | 1
RS232Shfiter |  | MAX232 | 1
T1, T2, T3, T4, T5, T6, T7, T8 |  | IRF520 | 8

Sheet: atmel used pins
Pin on EXT1 | SAM D20 pin | Function | Used for
1 | - |  |  | -
2 | - |  |  | -
3 | PB00 | AIN[8] | amplifier \acs{ADC} | AIN[8]
4 | PB01 | AIN[9] |  | AIN[9]
5 | PB06 | GPIO |  | GPIO
6 | PB07 | GPIO |  | GPIO
7 | PB02 | TC6/WO[0] |  | TC6/WO[0]
8 | PB03 | TC6/WO[1] |  | TC6/WO[1]
9 | PB04 | EXTINT[4] | Emergency Stop | EXTINT[4]
10 | PB05 | GPIO |  | GPIO
11 | PA08 | SERCOM2 PAD[0] I²C SDA EXT2, EXT3 and EDBG |  | SERCOM2 | PAD[0] | I²C | SDA | EXT2, | EXT3 | and | EDBG
12 | PA09 | SERCOM2 PAD[1] I²C SCL EXT2, EXT3 and EDBG |  | SERCOM2 | PAD[1] | I²C | SCL | EXT2, | EXT3 | and | EDBG
13 | PB09 | SERCOM4 PAD[1] UART RX1 | \acs{RS232} | SERCOM4 | PAD[1] | UART | RX1
14 | PB08 | SERCOM4 PAD[0] UART TX1 | \acs{RS232} | SERCOM4 | PAD[0] | UART | TX1
15 | PA05 | SERCOM0 PAD[1] SPI SS |  | SERCOM0 | PAD[1] | SPI | SS
16 | PA06 | SERCOM0 PAD[2] SPI MOSI |  | SERCOM0 | PAD[2] | SPI | MOSI
17 | PA04 | SERCOM0 PAD[0] SPI MISO | Referenc for \acs{ADC} | SERCOM0 | PAD[0] | SPI | MISO
18 | PA07 | SERCOM0 PAD[3] SPI SCK |  | SERCOM0 | PAD[3] | SPI | SCK
19 | - | GND |  | GND
20 | - | VCC |  | VCC
Pin on EXT2 | SAM D20 pin | Function | Used for
1 | -
2 | - | GND |  |  | GND
3 | PA10 | AIN[18] |  | AIN[18]
4 | PA11 | AIN[19] |  | AIN[19]
5 | PA20 | GPIO | DRV8711 Sleep | GPIO
6 | PA21 | GPIO | DRV8711 reset | GPIO
7 | PA22 | TC4/WO[0] | DRV8711 \acs{TC} | TC4/WO[0]
8 | PA23 | TC4/WO[1] |  | TC4/WO[1]
9 | PB14 | EXTINT[14] | DRV8711 change direction | EXTINT[14]
10 | PB15 | GPIO |  | GPIO
11 | PA08 | SERCOM2 PAD[0] I²C SDA EXT1, EXT3 and EDBG |  | SERCOM2 | PAD[0] | I²C | SDA | EXT1, | EXT3 | and | EDBG
12 | PA09 | SERCOM2 PAD[1] I²C SCL EXT1, EXT3 and EDBG |  | SERCOM2 | PAD[1] | I²C | SCL | EXT1, | EXT3 | and | EDBG
13 | PB13 | SERCOM4 PAD[1] UART RX1 |  | SERCOM4 | PAD[1] | UART | RX1
14 | PB12 | SERCOM4 PAD[0] UART TX1 |  | SERCOM4 | PAD[0] | UART | TX1
15 | PA17 | SERCOM1 PAD[1] SPI SS | DRV8711 SPI | SERCOM1 | PAD[1] | SPI | SS
16 | PA18 | SERCOM1 PAD[2] SPI MOSI | DRV8711 SPI | SERCOM1 | PAD[2] | SPI | MOSI
17 | PA16 | SERCOM1 PAD[0] SPI MISO | DRV8711 SPI | SERCOM1 | PAD[0] | SPI | MISO
18 | PA19 | SERCOM1 PAD[3] SPI SCK | DRV8711 SPI | SERCOM1 | PAD[3] | SPI | SCK
19 | - | GND |  |  | GND
20 | - | VCC |  |  | VCC
Pin on EXT2 | SAM D20 pin | Function | Used for
1 | - | - |  | -
2 | - | - GND |  | - | GND
3 | PA02 | AIN[0] |  | AIN[0]
4 | PA03 | AIN[1] |  | AIN[1]
5 | PB30 | GPIO |  | GPIO
6 | PA15 | GPIO Onboard SW0 |  | GPIO | Onboard | SW0
7 | PA12 | TC2/WO[0] |  | TC2/WO[0]
8 | PA13 | TC2/WO[1] |  | TC2/WO[1]
9 | PA28 | EXTINT[8] | Limit switch | EXTINT[8]
10 | PA27 | GPIO |  | GPIO
11 | PA08 | SERCOM2 PAD[0] I²C SDA EXT1, EXT2 and EDBG |  | SERCOM2 | PAD[0] | I²C | SDA | EXT1, | EXT2 | and | EDBG
12 | PA09 | SERCOM2 PAD[1] I²C SCL EXT1, EXT2 and EDBG |  | SERCOM2 | PAD[1] | I²C | SCL | EXT1, | EXT2 | and | EDBG
13 | PB11 | SERCOM4 PAD[3] UART RX1 |  | SERCOM4 | PAD[3] | UART | RX1
14 | PB10 | SERCOM4 PAD[2] UART TX1 |  | SERCOM4 | PAD[2] | UART | TX1
15 | PB17 | SERCOM5 PAD[1] SPI SS |  | SERCOM5 | PAD[1] | SPI | SS
16 | PB22 | SERCOM5 PAD[2] SPI MOSI EDBG |  | SERCOM5 | PAD[2] | SPI | MOSI | EDBG
17 | PB16 | SERCOM5 PAD[0] SPI MISO EDBG |  | SERCOM5 | PAD[0] | SPI | MISO | EDBG
18 | PB23 | SERCOM5 PAD[3] SPI SCK EDBG |  | SERCOM5 | PAD[3] | SPI | SCK | EDBG
19 | - | GND |  |  | GND
20 | - | VCC |  |  | VCC
Pin on EXT2 | SAM D20 pin | Function | Used for
5 | PA20 | GPIO | DRV8711 Sleep
6 | PA21 | GPIO | DRV8711 reset
7 | PA22 | TC4/WO[0] | DRV8711 \acs{TC}
9 | PB14 | EXTINT[14] | DRV8711 change direction
15 | PA17 | SERCOM1 PAD[1] SPI SS | DRV8711 SPI
16 | PA18 | SERCOM1 PAD[2] SPI MOSI | DRV8711 SPI
17 | PA16 | SERCOM1 PAD[0] SPI MISO | DRV8711 SPI
18 | PA19 | SERCOM1 PAD[3] SPI SCK | DRV8711 SPI
19 | - | GND
20 | - | VCC
Pin on EXT2 | SAM D20 pin | Function | Used for
9 | PA28 | EXTINT[8] | Limit switch
19 | - | GND
20 | - | VCC

Sheet: Blatt2
 |  |  |  | v | 120 | rot/min | 2 | rot/s
 |  |  |  | n_m | 1 | usteps/step
 |  |  |  | steps | 1.8 | °/step
 | 8 | Mhz | 65536 | f_step | 400 | usteps/s
421.0526316 | 842.1052632 | Hz |  | v | 126.3157895 | rot/min |  | 189.4736842 | mm/min
526.3157895 | 1052.631579 | Hz | 9500 |  | 157.8947368 |  |  | 236.8421053 | mm/min | 80mm/x | mm/min
 |  |  | 7600 | steigung | 1.5
 | 1.159667969 |  |  | weg | 80 | mm |  | 0.4222222222 | min | 25.33333333
 |  |  |  |  | 53.33333333 | rot |  | 0.3377777778 | min | 20.26666667
 |  |  |  |  | 0.4222222222 | min | 25.33333333
 | Baudrate | 115200
 | Bits Übertragen | 10
 |  | 11520 | Bytes/s
 | zu Übertragende Bytes | 25
 |  | 460.8 | Telegrame/s
