pasrom/grabtastic/Mechanical_Stuff/linearAxis80mm/SLT_BB_0412_ER_S0015RG_80_1.stp

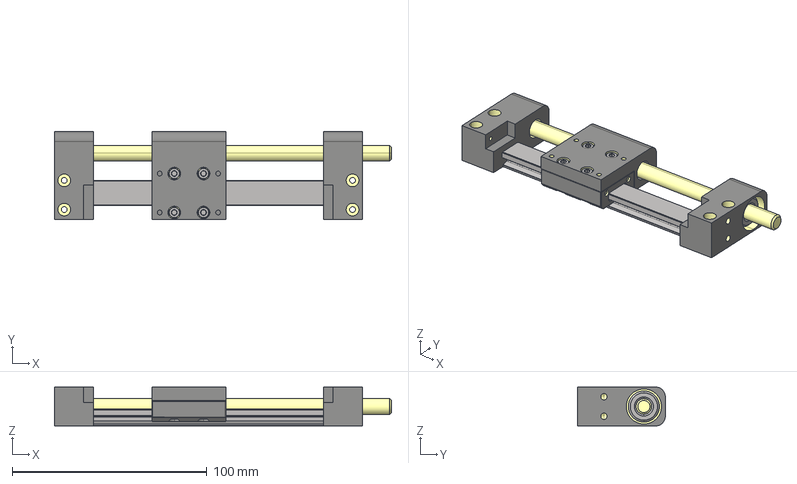
[picture p54: CAD file, 2017-12-31]
Mechanical_Stuff/linearAxis80mm/SLT_BB_0412_ER_S0015RG_80_1.stp
173.0 x 45.0 x 20.0 mm
