pasrom/grabtastic/Mechanical_Stuff/Z-Axis_v1/KD24s_2N-20N_000_K(a).stp

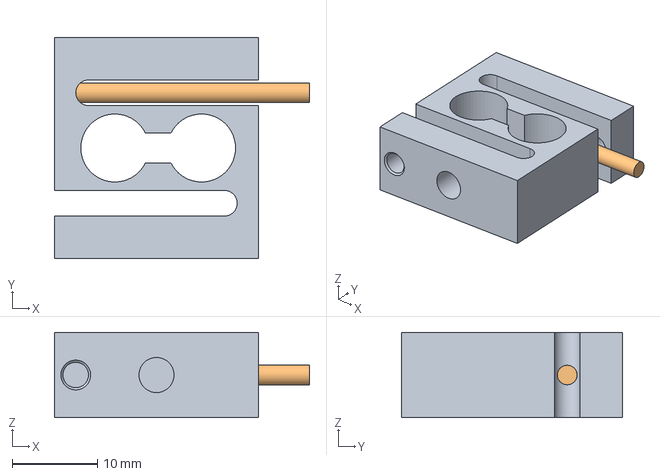
[picture p55: CAD file, 2017-12-31]
Mechanical_Stuff/Z-Axis_v1/KD24s_2N-20N_000_K(a).stp
30.0 x 26.0 x 10.0 mm
