pasrom/grabtastic/Mechanical_Stuff/Z-Axis_v1/ST5918M1008.stp

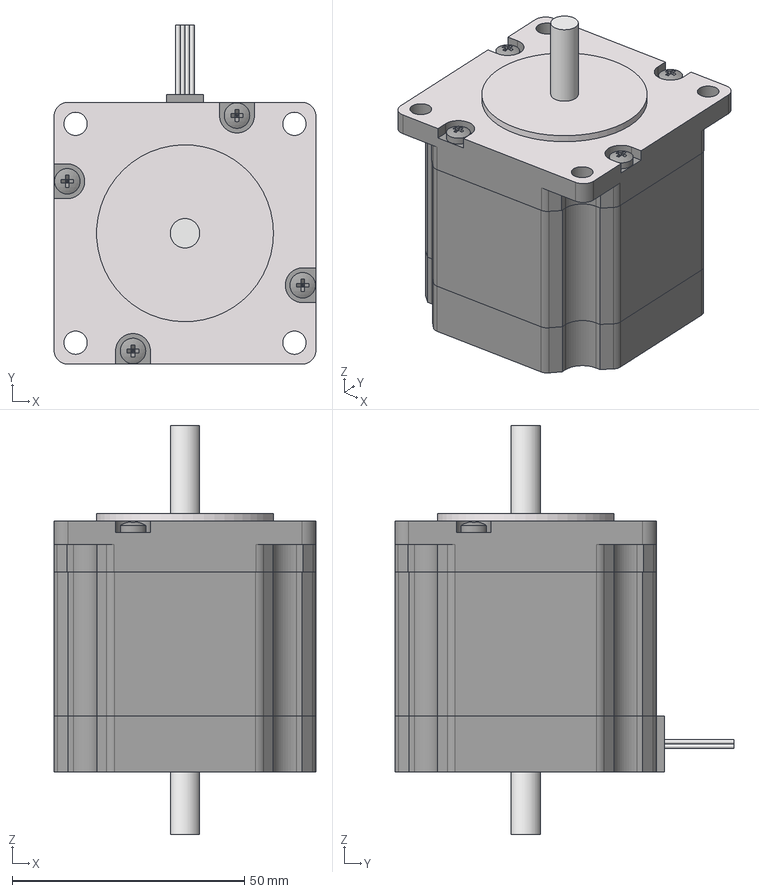
[picture p56: CAD file, 2017-12-31]
Mechanical_Stuff/Z-Axis_v1/ST5918M1008.stp
56.4 x 73.1 x 88.1 mm
Frontcap_ST5918
shaft_forward_5709
Schrauben_ISO_7045_M3 x 4
Stator_5918_M
Endcap_5918
leads_4_ST5918
shaft_rear_6.35x13.5
