pasrom/grabtastic/(list of files, cad)

Other CAD files:
Mechanical_Stuff/Z-Axis_v1/13420.prt
Mechanical_Stuff/Z-Axis_v1/23425.prt
Mechanical_Stuff/Z-Axis_v1/Endcap ST5918_kompl.prt
Mechanical_Stuff/Z-Axis_v1/Endcap_5918.prt
Mechanical_Stuff/Z-Axis_v1/Frontcap_ST5918.prt
Mechanical_Stuff/Z-Axis_v1/ID_1.prt
Mechanical_Stuff/Z-Axis_v1/ID_1398.prt
Mechanical_Stuff/Z-Axis_v1/ID_1399.prt
Mechanical_Stuff/Z-Axis_v1/KD24s_2N-20N_000_K_a__stp.prt
Mechanical_Stuff/Z-Axis_v1/LinearAxis Fitting.prt
Mechanical_Stuff/Z-Axis_v1/Rackbar.prt
Mechanical_Stuff/Z-Axis_v1/SLT_BB_0412_ER_S0015RG_80_1_stp.prt
Mechanical_Stuff/Z-Axis_v1/ST5918M1008_stp.prt
Mechanical_Stuff/Z-Axis_v1/Schrauben_ISO_7045_M3.prt
Mechanical_Stuff/Z-Axis_v1/Stator_5918_M.prt
Mechanical_Stuff/Z-Axis_v1/asseblyAxisGes.prt
Mechanical_Stuff/Z-Axis_v1/frame1.prt
Mechanical_Stuff/Z-Axis_v1/frame2.prt
Mechanical_Stuff/Z-Axis_v1/frame2withdrafting.prt
Mechanical_Stuff/Z-Axis_v1/holokki.prt
Mechanical_Stuff/Z-Axis_v1/leads_4_ST5918.prt
Mechanical_Stuff/Z-Axis_v1/microfix.prt
Mechanical_Stuff/Z-Axis_v1/shaft_forward_5709.prt
Mechanical_Stuff/Z-Axis_v1/shaft_rear_6.35x13.5.prt
Mechanical_Stuff/Z-Axis_v1/snapConnV5.prt
Mechanical_Stuff/disk.prt
Mechanical_Stuff/grabber.prt
Mechanical_Stuff/grabber_version_2.prt
Mechanical_Stuff/grabber_version_3.prt
Mechanical_Stuff/holecube.prt
Mechanical_Stuff/linearAxis80mm/1.prt
Mechanical_Stuff/linearAxis80mm/2.prt
Mechanical_Stuff/linearAxis80mm/SLT_BB_0412_ER_S0015RG_80_1_stp.prt
Mechanical_Stuff/repository.prt
Mechanical_Stuff/repositoryDesign/Drafting_Modified/NXPart/assembly1_targetlowerparts.prt
Mechanical_Stuff/repositoryDesign/Drafting_Modified/NXPart/assembly2_upperparts.prt
Mechanical_Stuff/repositoryDesign/Drafting_Modified/NXPart/assembly_Targetrepository.prt
Mechanical_Stuff/repositoryDesign/Drafting_Modified/NXPart/longnut.prt
Mechanical_Stuff/repositoryDesign/Drafting_Modified/NXPart/middlenut.prt
Mechanical_Stuff/repositoryDesign/Drafting_Modified/NXPart/shortbolt.prt
Mechanical_Stuff/repositoryDesign/Drafting_Modified/NXPart/shortnut.prt
Mechanical_Stuff/repositoryDesign/Drafting_Modified/NXPart/upperplate.prt
Mechanical_Stuff/repositoryDesign/Drafting_Modified/assembly_Targetrepository.prt
Mechanical_Stuff/repositoryDesign/Drafting_Modified/lowerplate_target.prt
Mechanical_Stuff/repositoryDesign/Drafting_Modified/upperplate.prt
Mechanical_Stuff/repositoryDesign/assembly1_targetlowerparts.prt
Mechanical_Stuff/repositoryDesign/assembly2_upperparts.prt
Mechanical_Stuff/repositoryDesign/assembly3_homelowerparts.prt
Mechanical_Stuff/repositoryDesign/assembly_Targetrepository.prt
Mechanical_Stuff/repositoryDesign/assembly_homerepository.prt
Mechanical_Stuff/repositoryDesign/longbolt.prt
Mechanical_Stuff/repositoryDesign/longnut.prt
Mechanical_Stuff/repositoryDesign/lowerplate_Home.prt
Mechanical_Stuff/repositoryDesign/lowerplate_target.prt
Mechanical_Stuff/repositoryDesign/middlenut.prt
Mechanical_Stuff/repositoryDesign/shortbolt.prt
Mechanical_Stuff/repositoryDesign/shortnut.prt
Mechanical_Stuff/repositoryDesign/upperplate.prt
Mechanical_Stuff/zAxis_v2/Rackbar.prt
Mechanical_Stuff/zAxis_v2/disk.prt
Mechanical_Stuff/zAxis_v2/frame1.prt
Mechanical_Stuff/zAxis_v2/frame2.prt
Mechanical_Stuff/zAxis_v2/lowerplate_target.prt
Mechanical_Stuff/zAxis_v2/microfix.prt
Mechanical_Stuff/zAxis_v2/part1.prt
Mechanical_Stuff/zAxis_v2/snapConnV5.prt
Mechanical_Stuff/zAxis_v2/upperplate.prt
