pasrom/grabtastic/Documenation/group_4_grabtastic/pictures/measurements/limitSwitch_without_capacitor_2.png

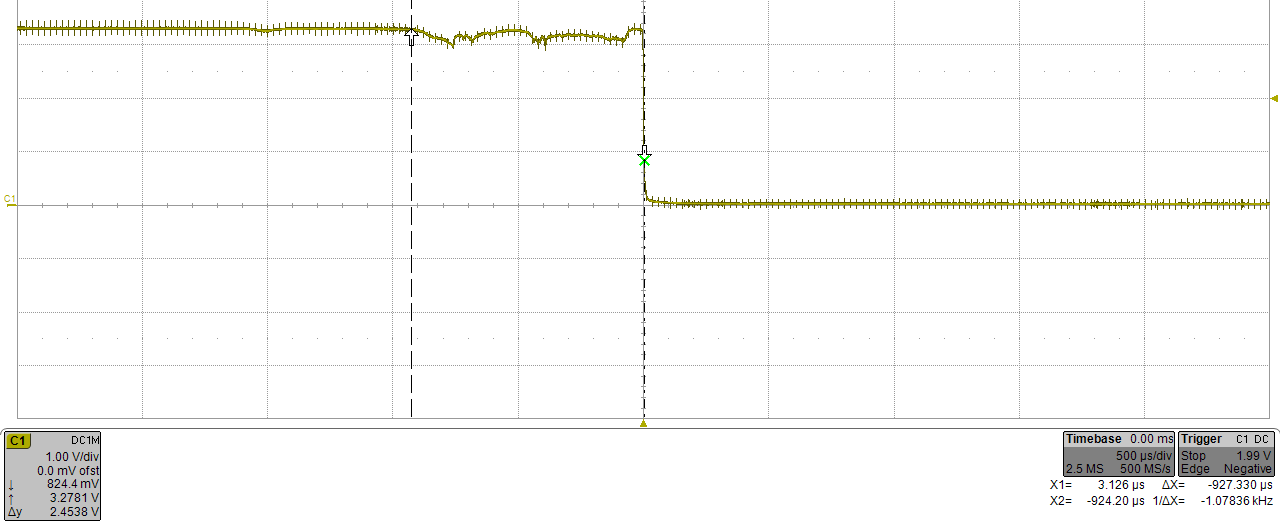
Documenation/group_4_grabtastic/pictures/measurements/limitSwitch_without_capacitor_2.png
