pasrom/grabtastic/Documenation/UML/Visio Dropcycle.pdf

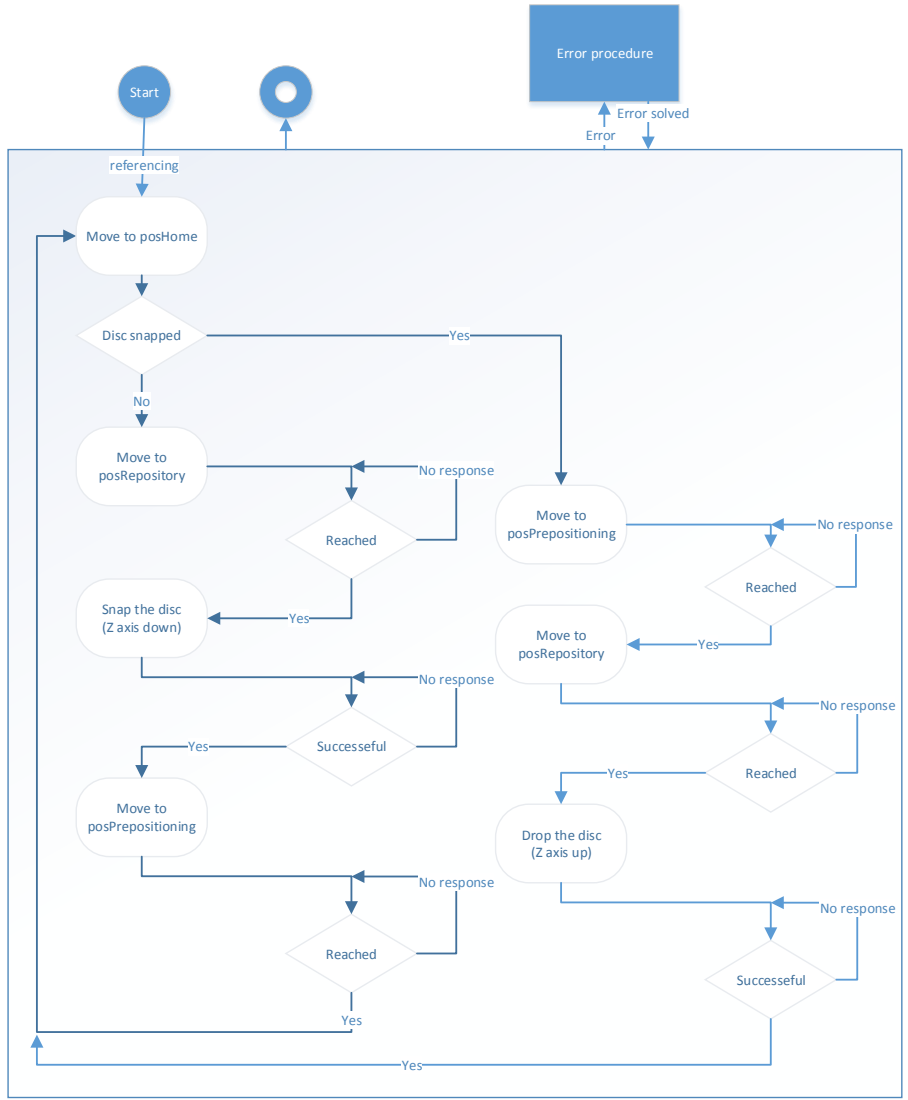
[picture p59: page 1]
Start; Move to posPrepositioning; Reached; Move to posRepository; Yes; No response; Successeful; Disc snapped; Error procedure; referencing

Error solved
Error

Move to posHome

Snap the disc
(Z axis down)

Drop the disc
(Z axis up)
