pasrom/grabtastic/Mechanical_Stuff/Final Draftings/psi5321_asseblyAxisGes.pdf

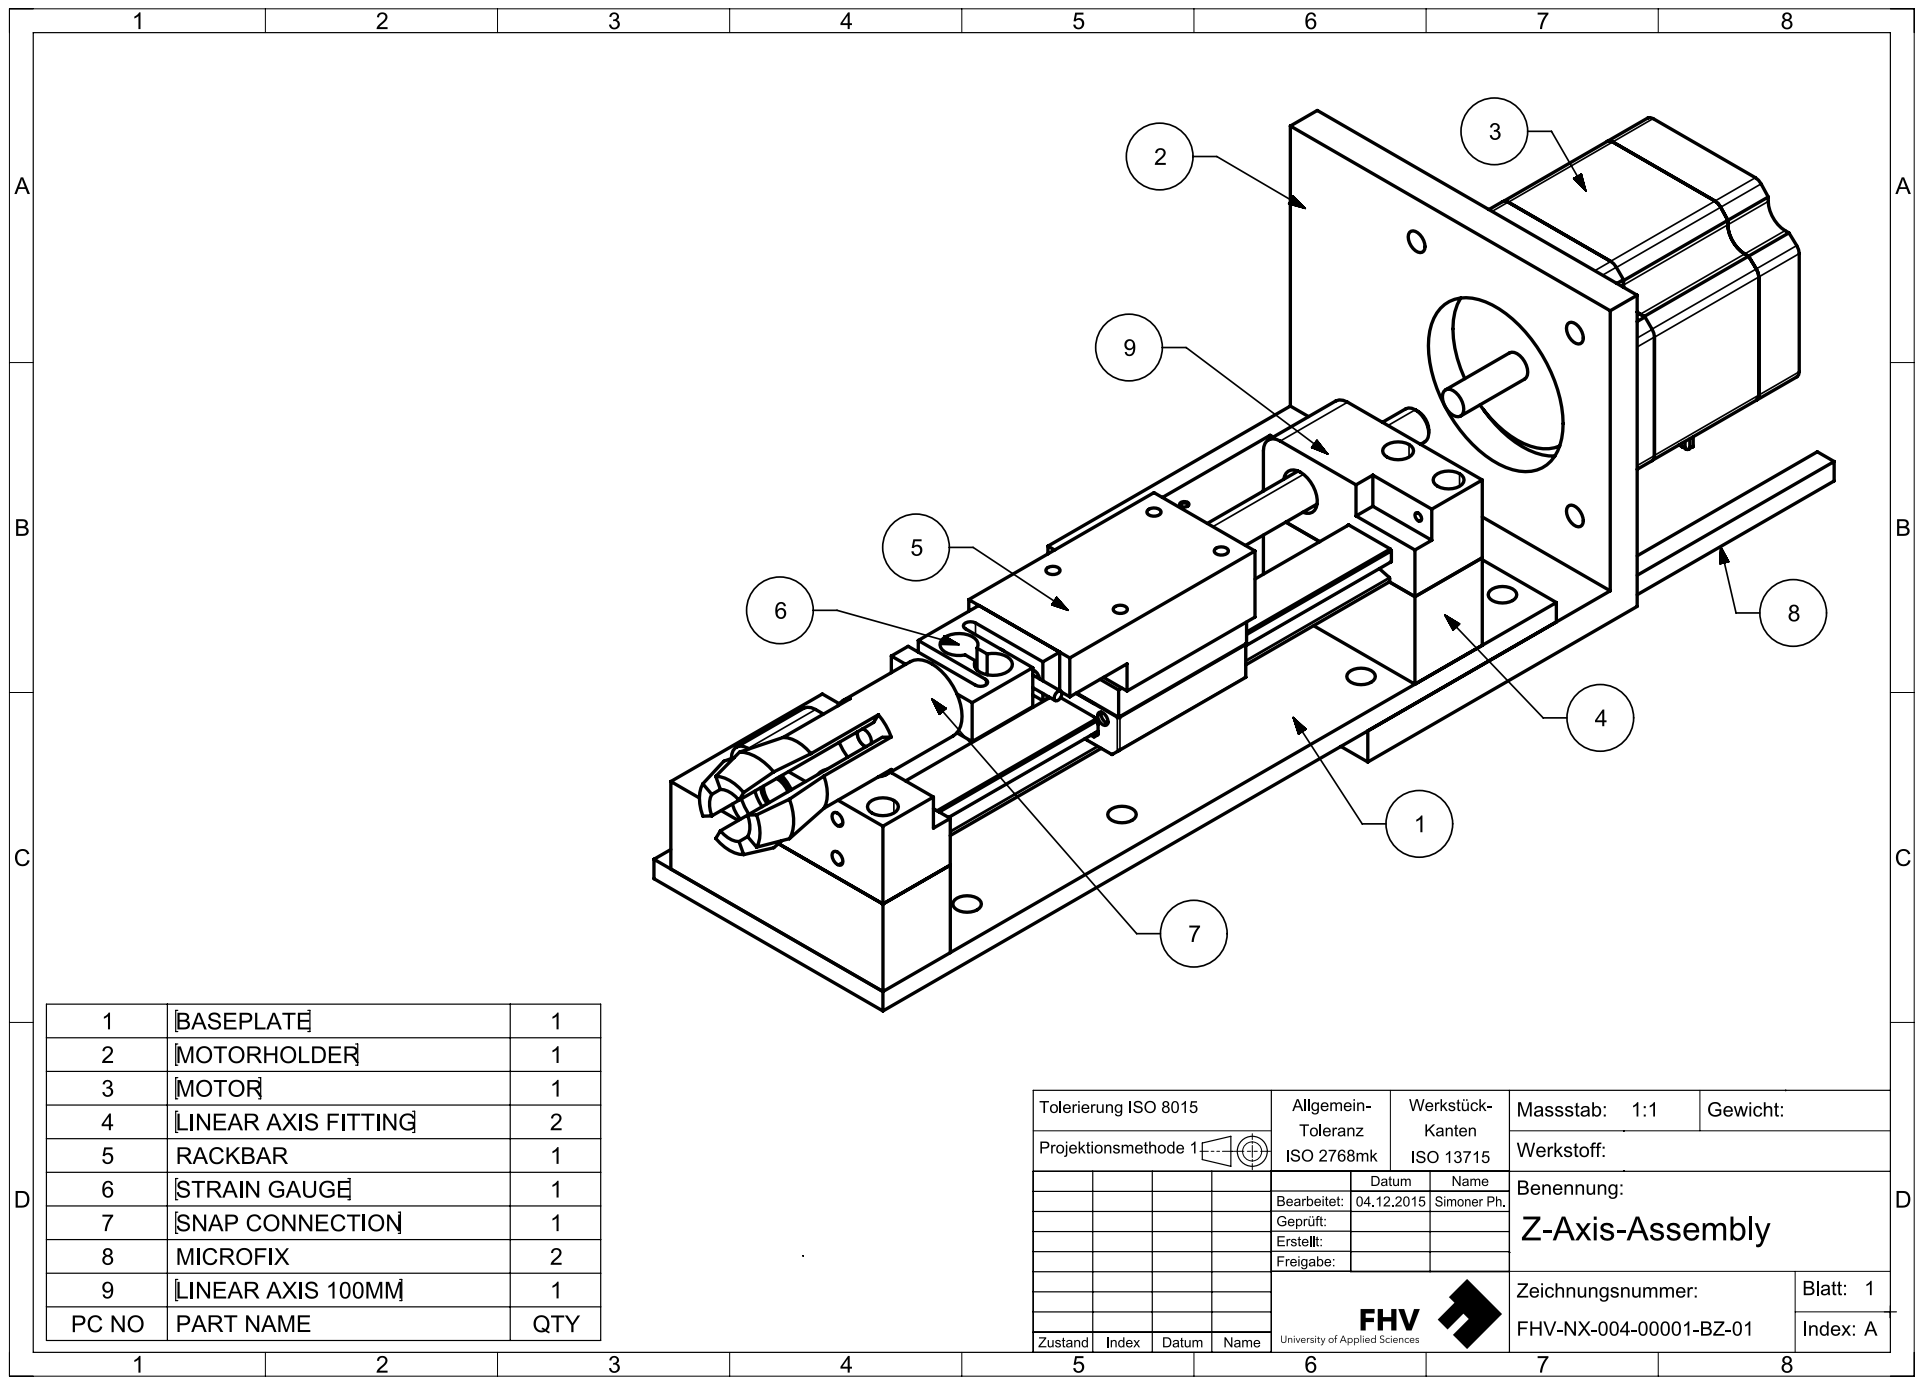
[picture p60: page 1]
