pasrom/grabtastic/Mechanical_Stuff/Final Draftings/psi5321_disk.pdf

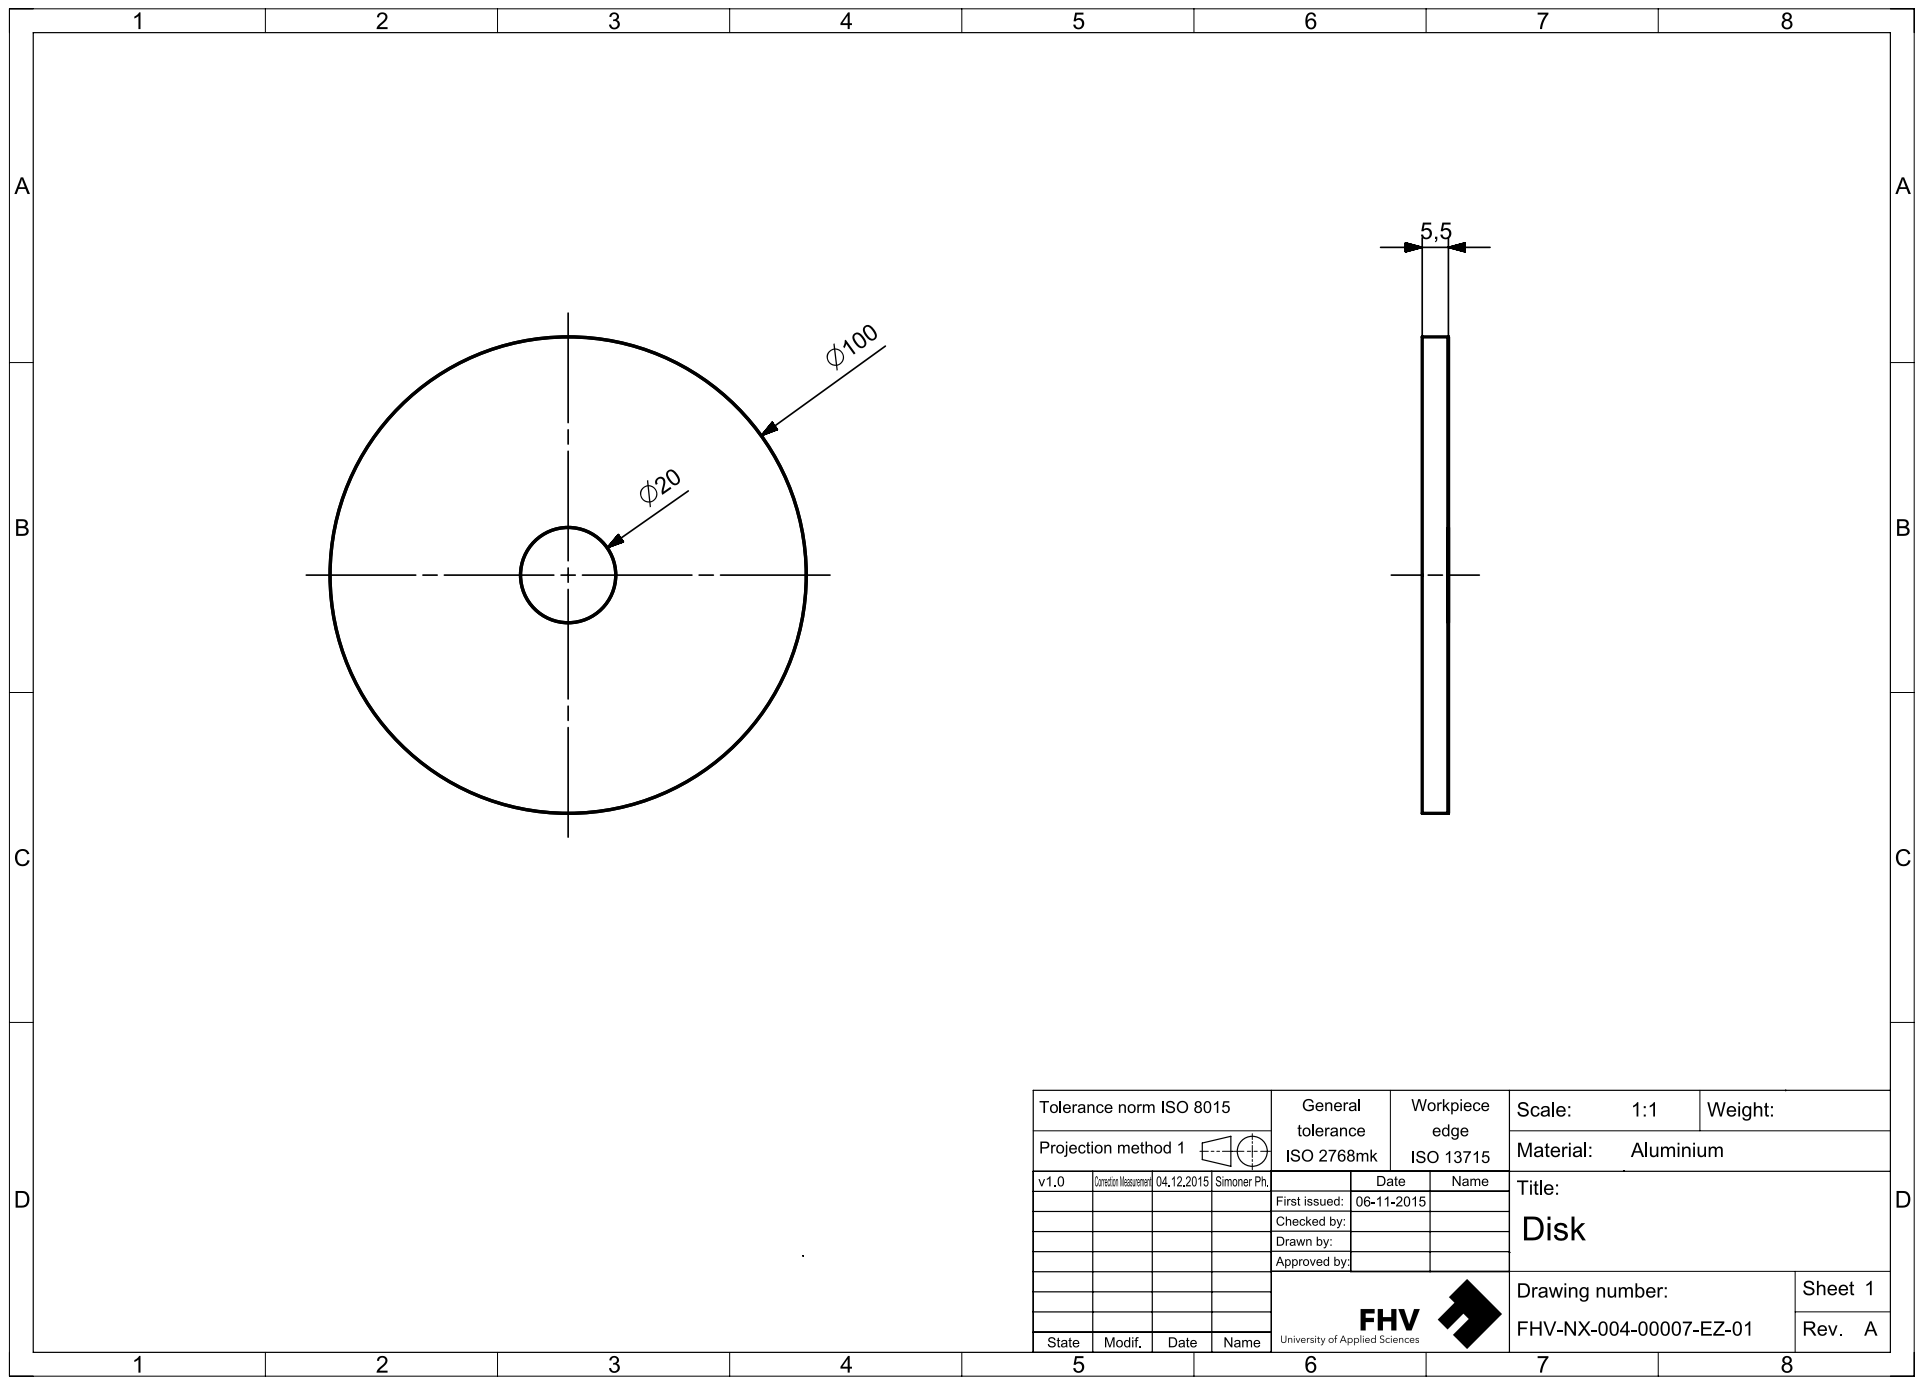
[picture p61: page 1]
