pasrom/grabtastic/Mechanical_Stuff/Final Draftings/psi5321_frame1.pdf

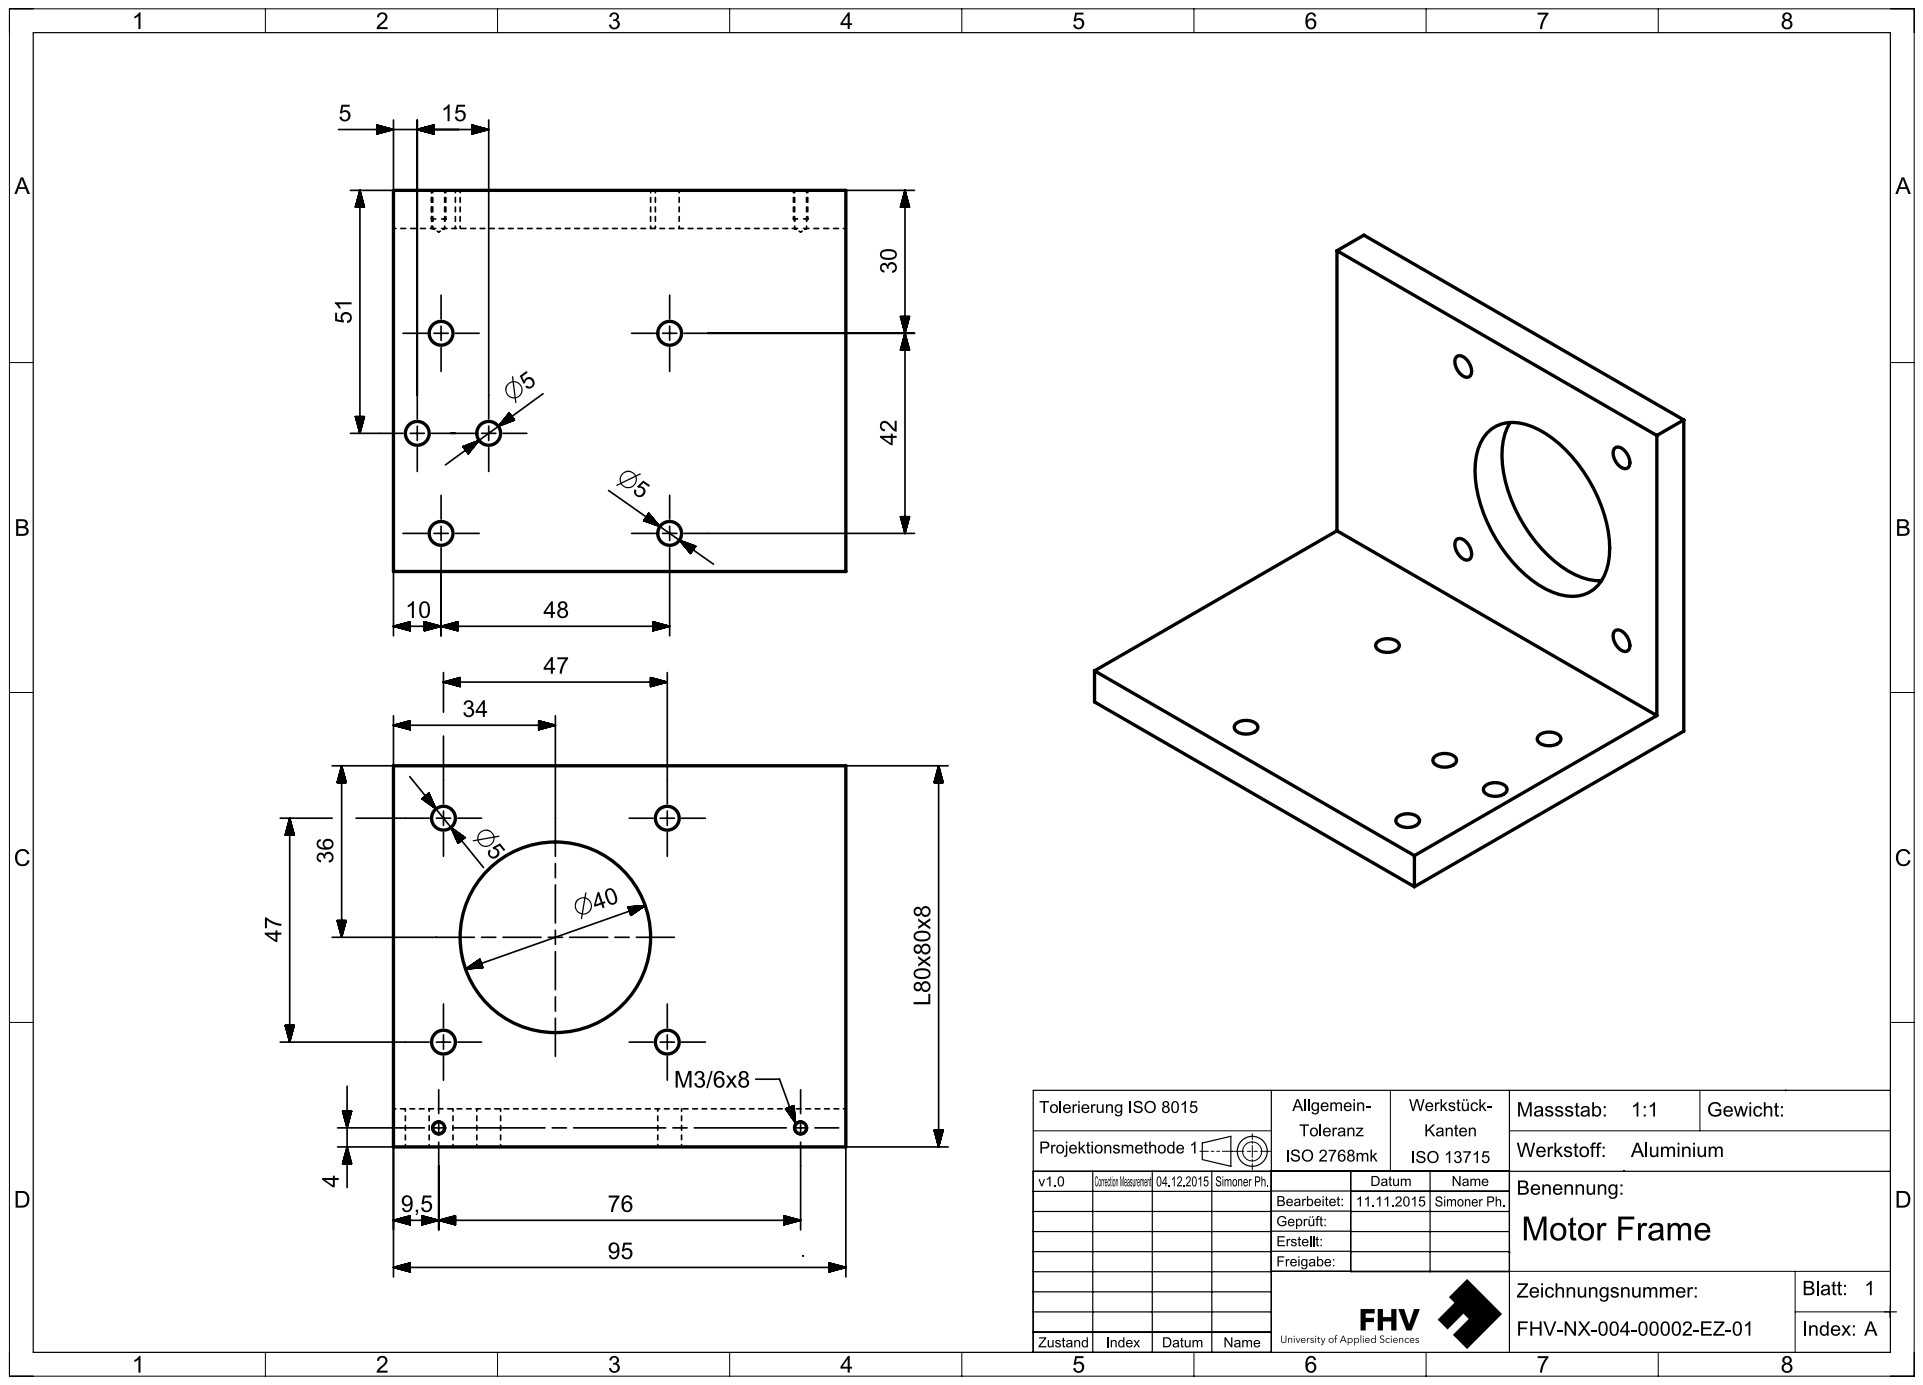
[picture p62: page 1]
