pasrom/grabtastic/Mechanical_Stuff/Final Draftings/psi5321_frame2.pdf

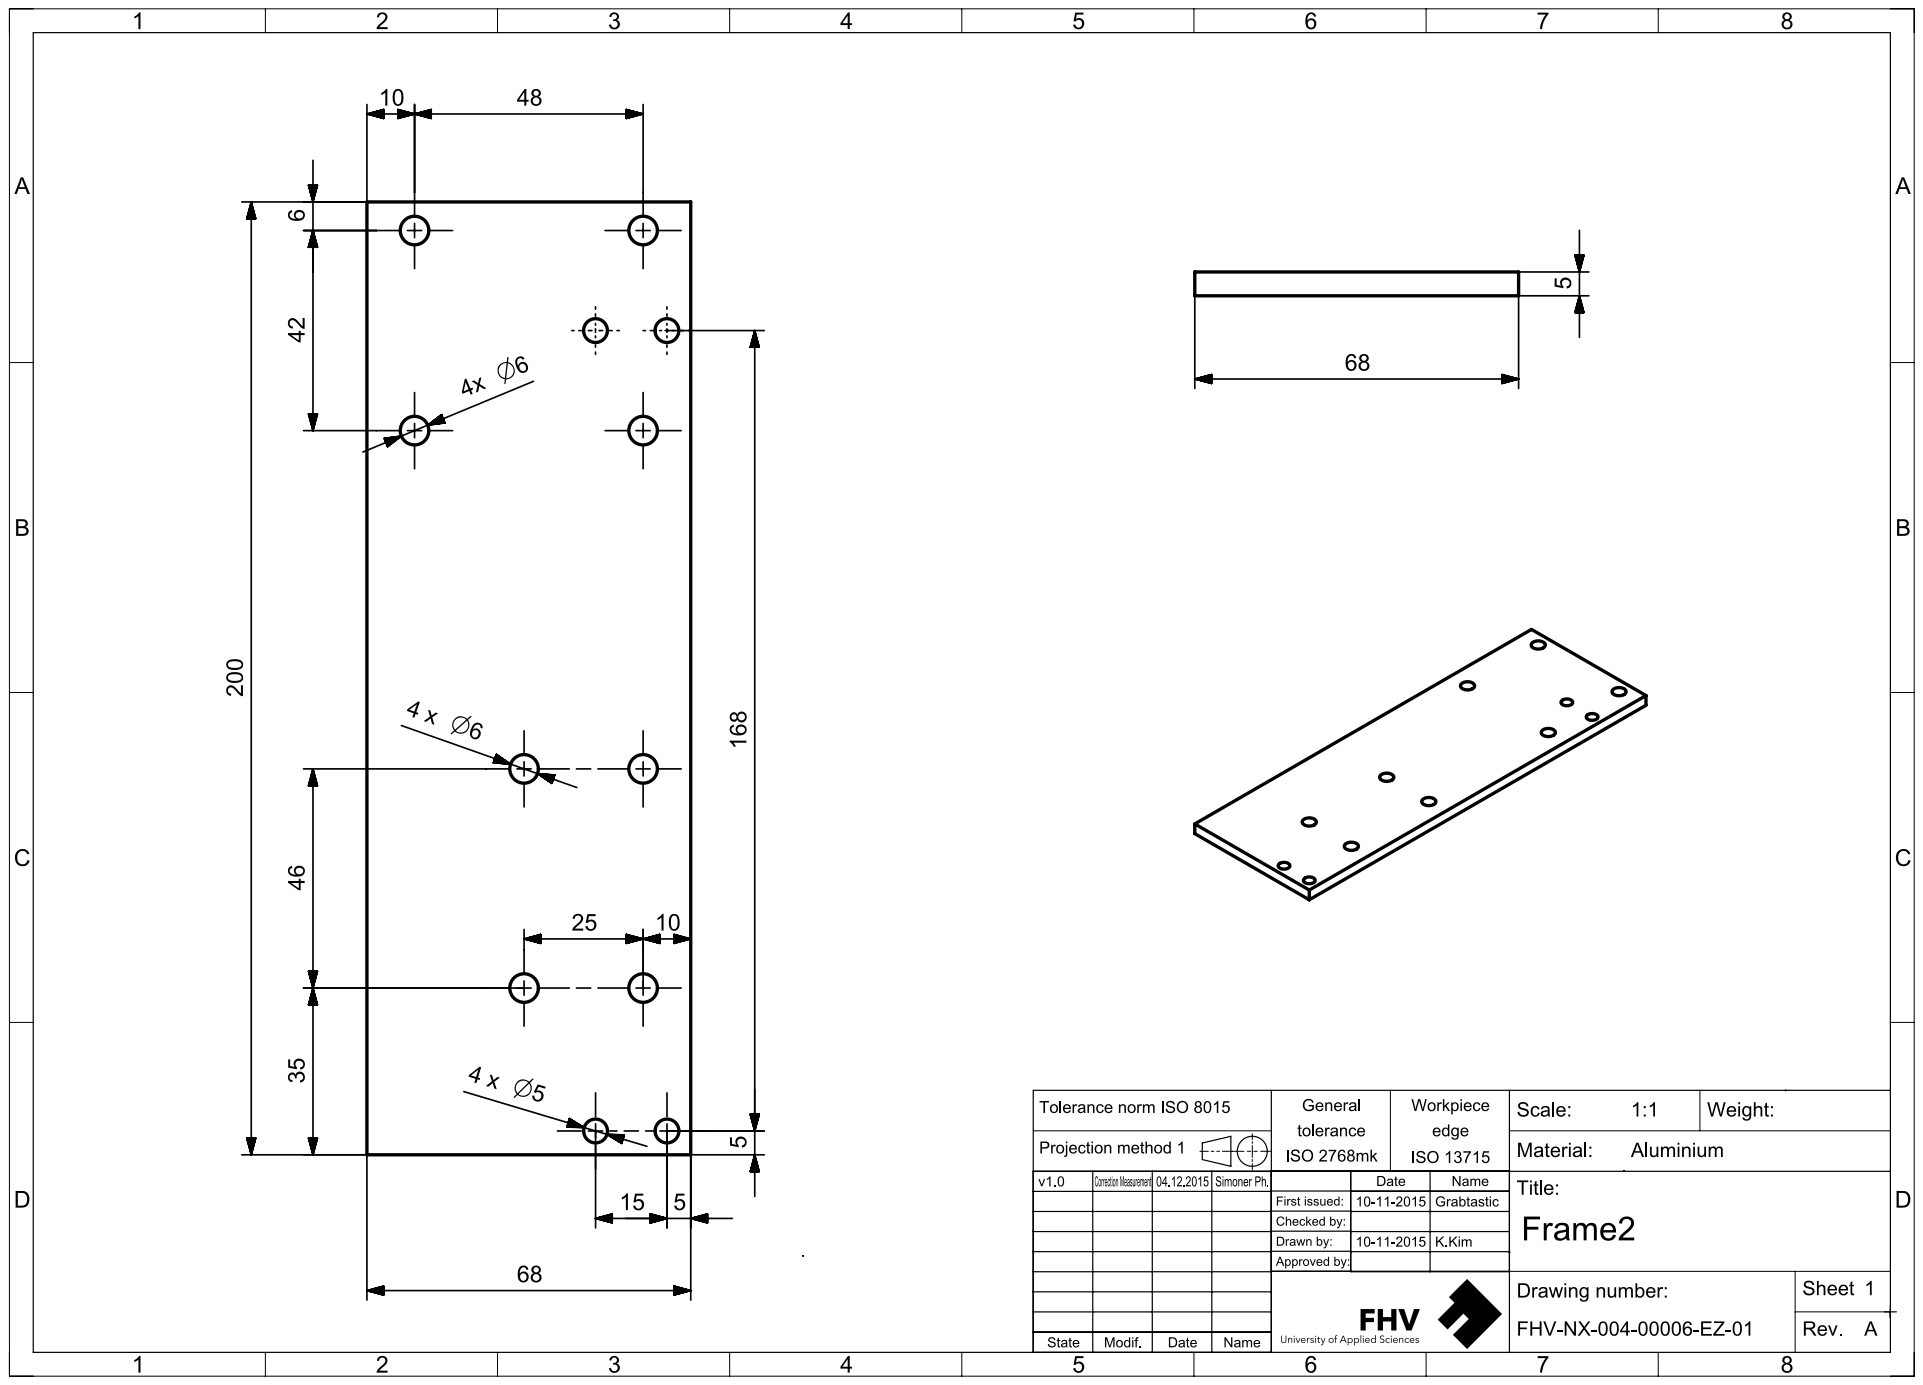
[picture p63: page 1]
