pasrom/grabtastic/Mechanical_Stuff/Final Draftings/psi5321_lowerplate_target.pdf

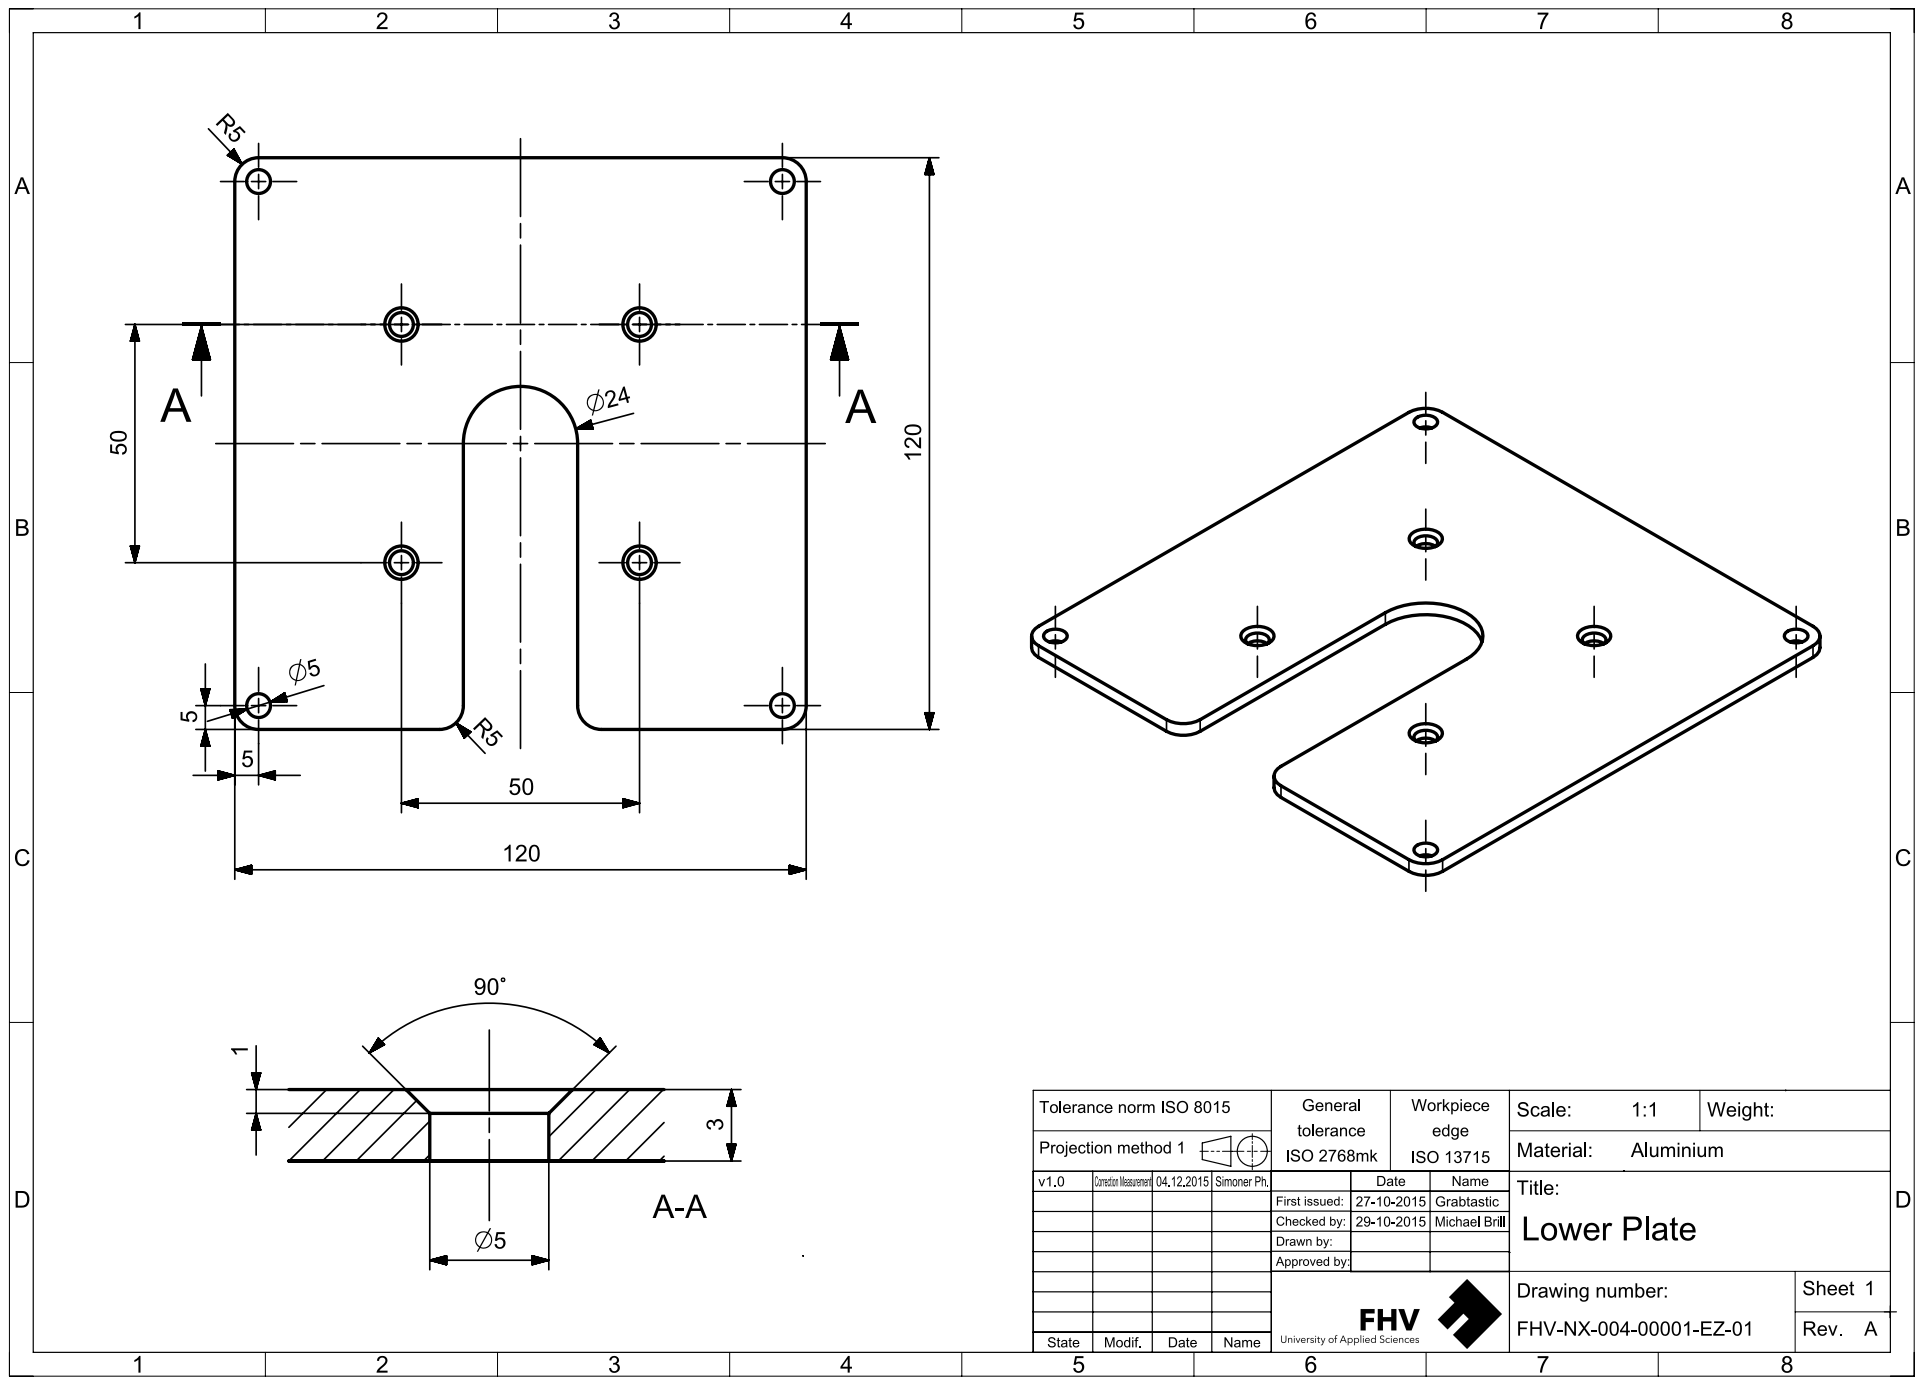
[picture p64: page 1]
