pasrom/grabtastic/Mechanical_Stuff/Final Draftings/psi5321_microfix.pdf

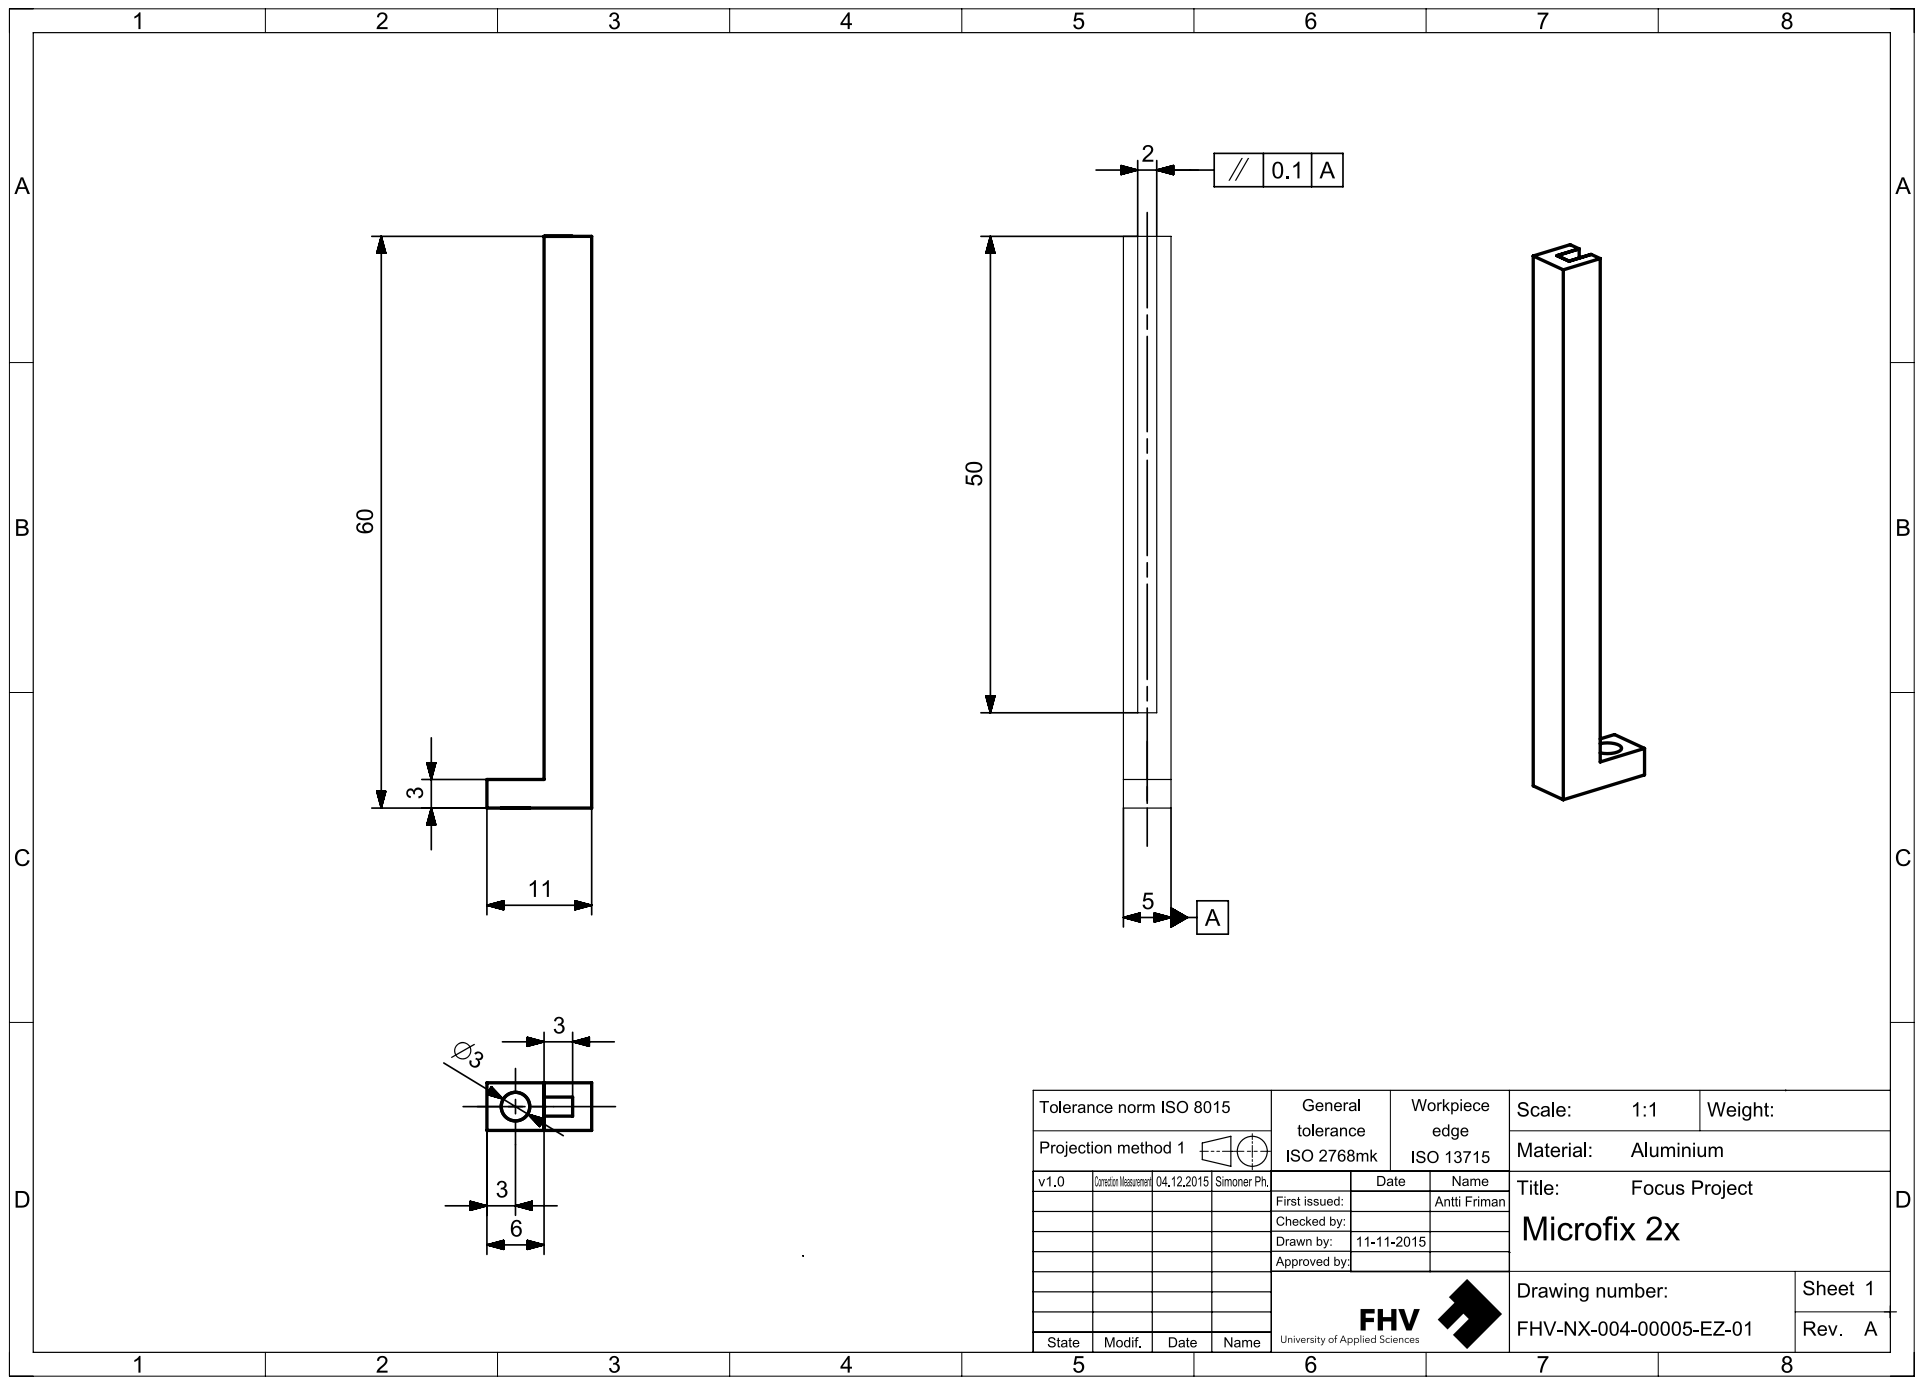
[picture p65: page 1]
