pasrom/grabtastic/Mechanical_Stuff/Final Draftings/psi5321_part1.pdf

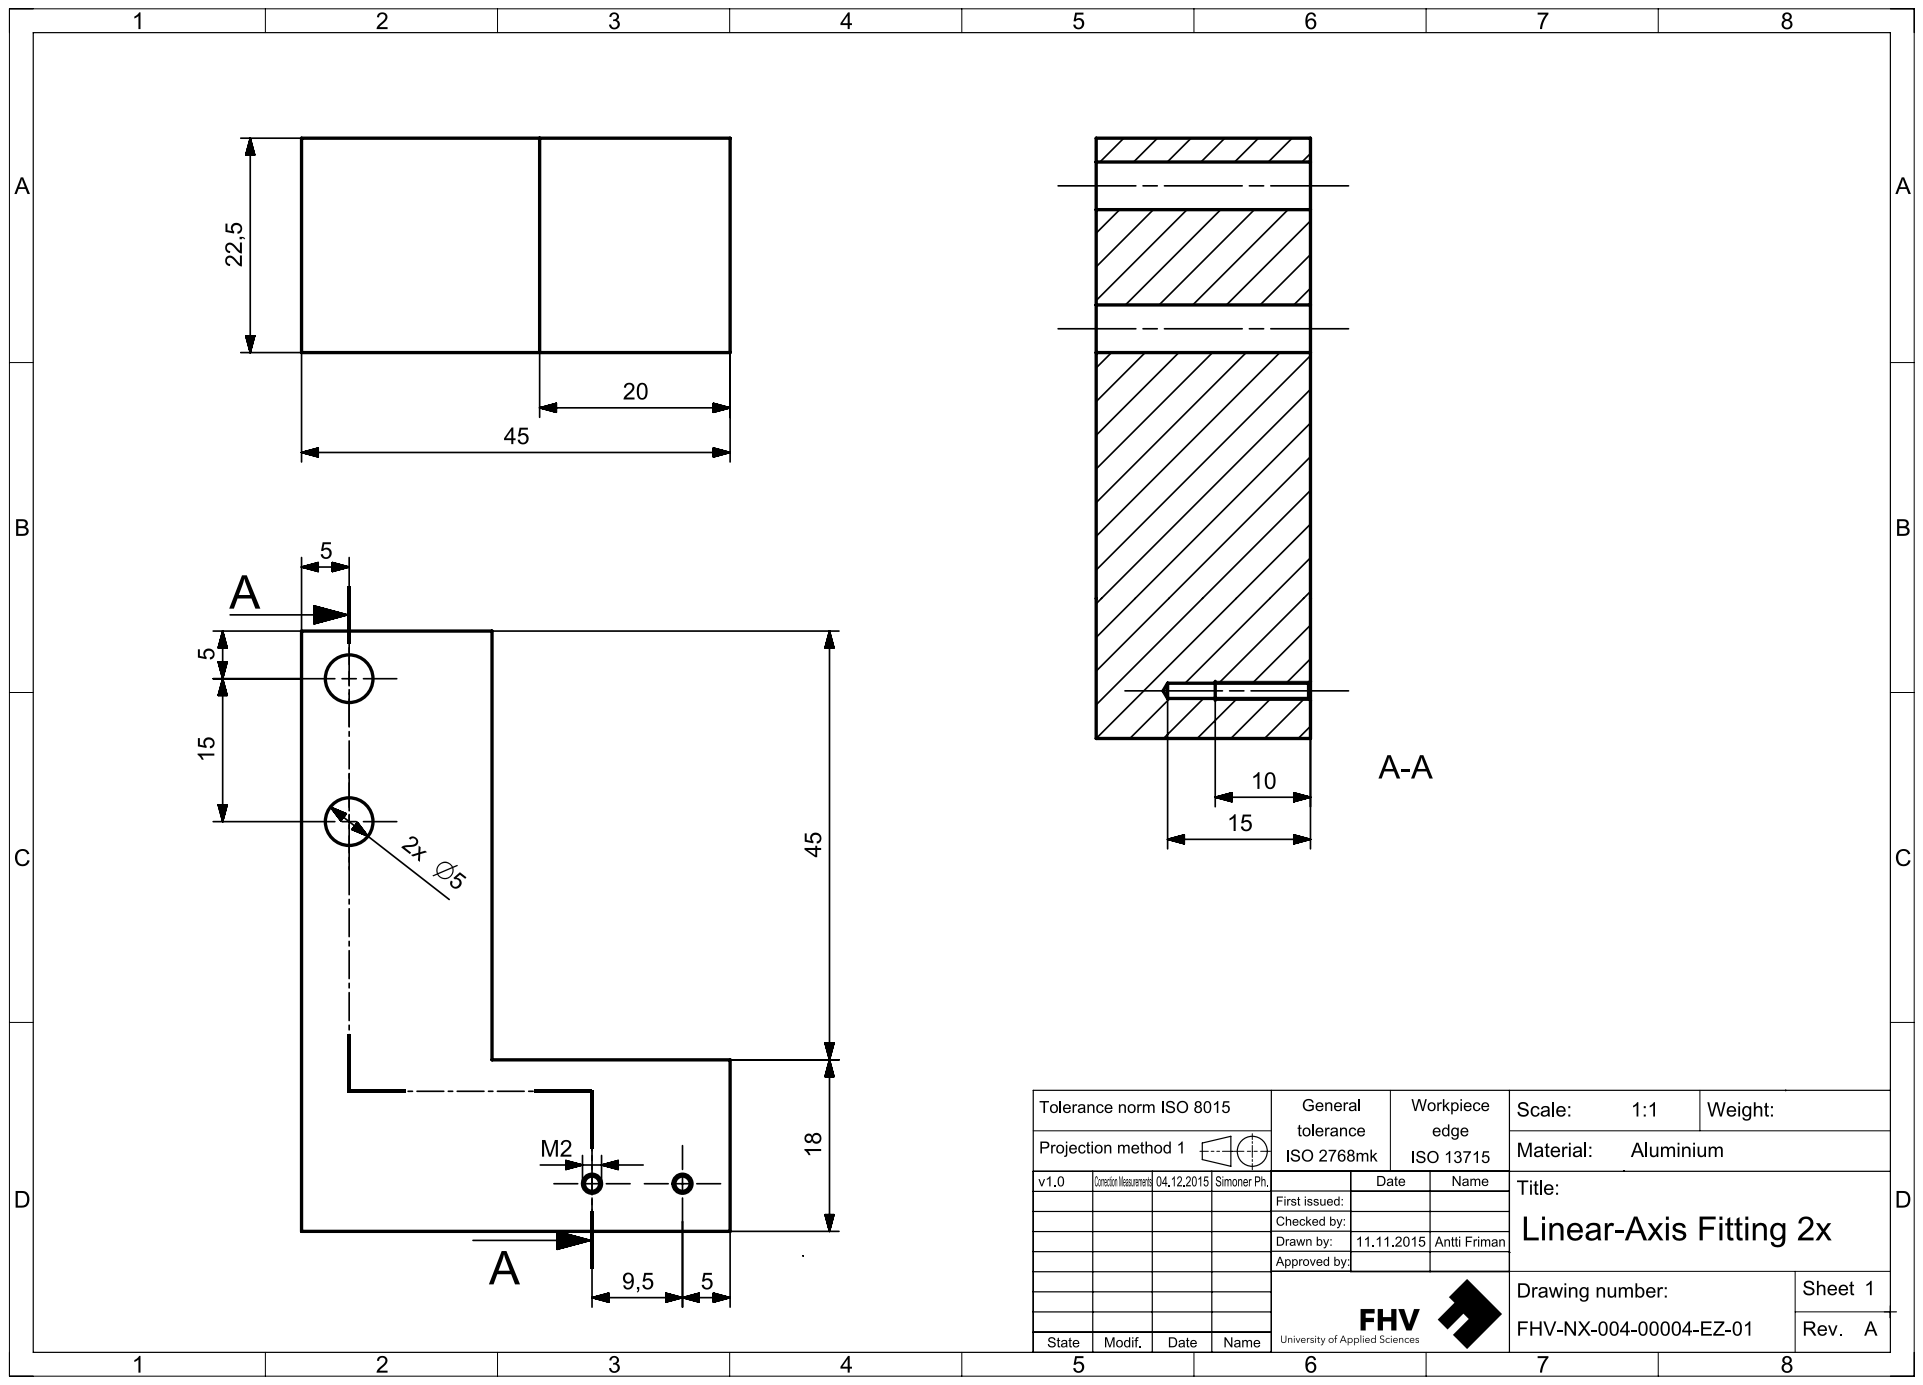
[picture p66: page 1]
