pasrom/grabtastic/Mechanical_Stuff/Final Draftings/psi5321_Rackbar.pdf

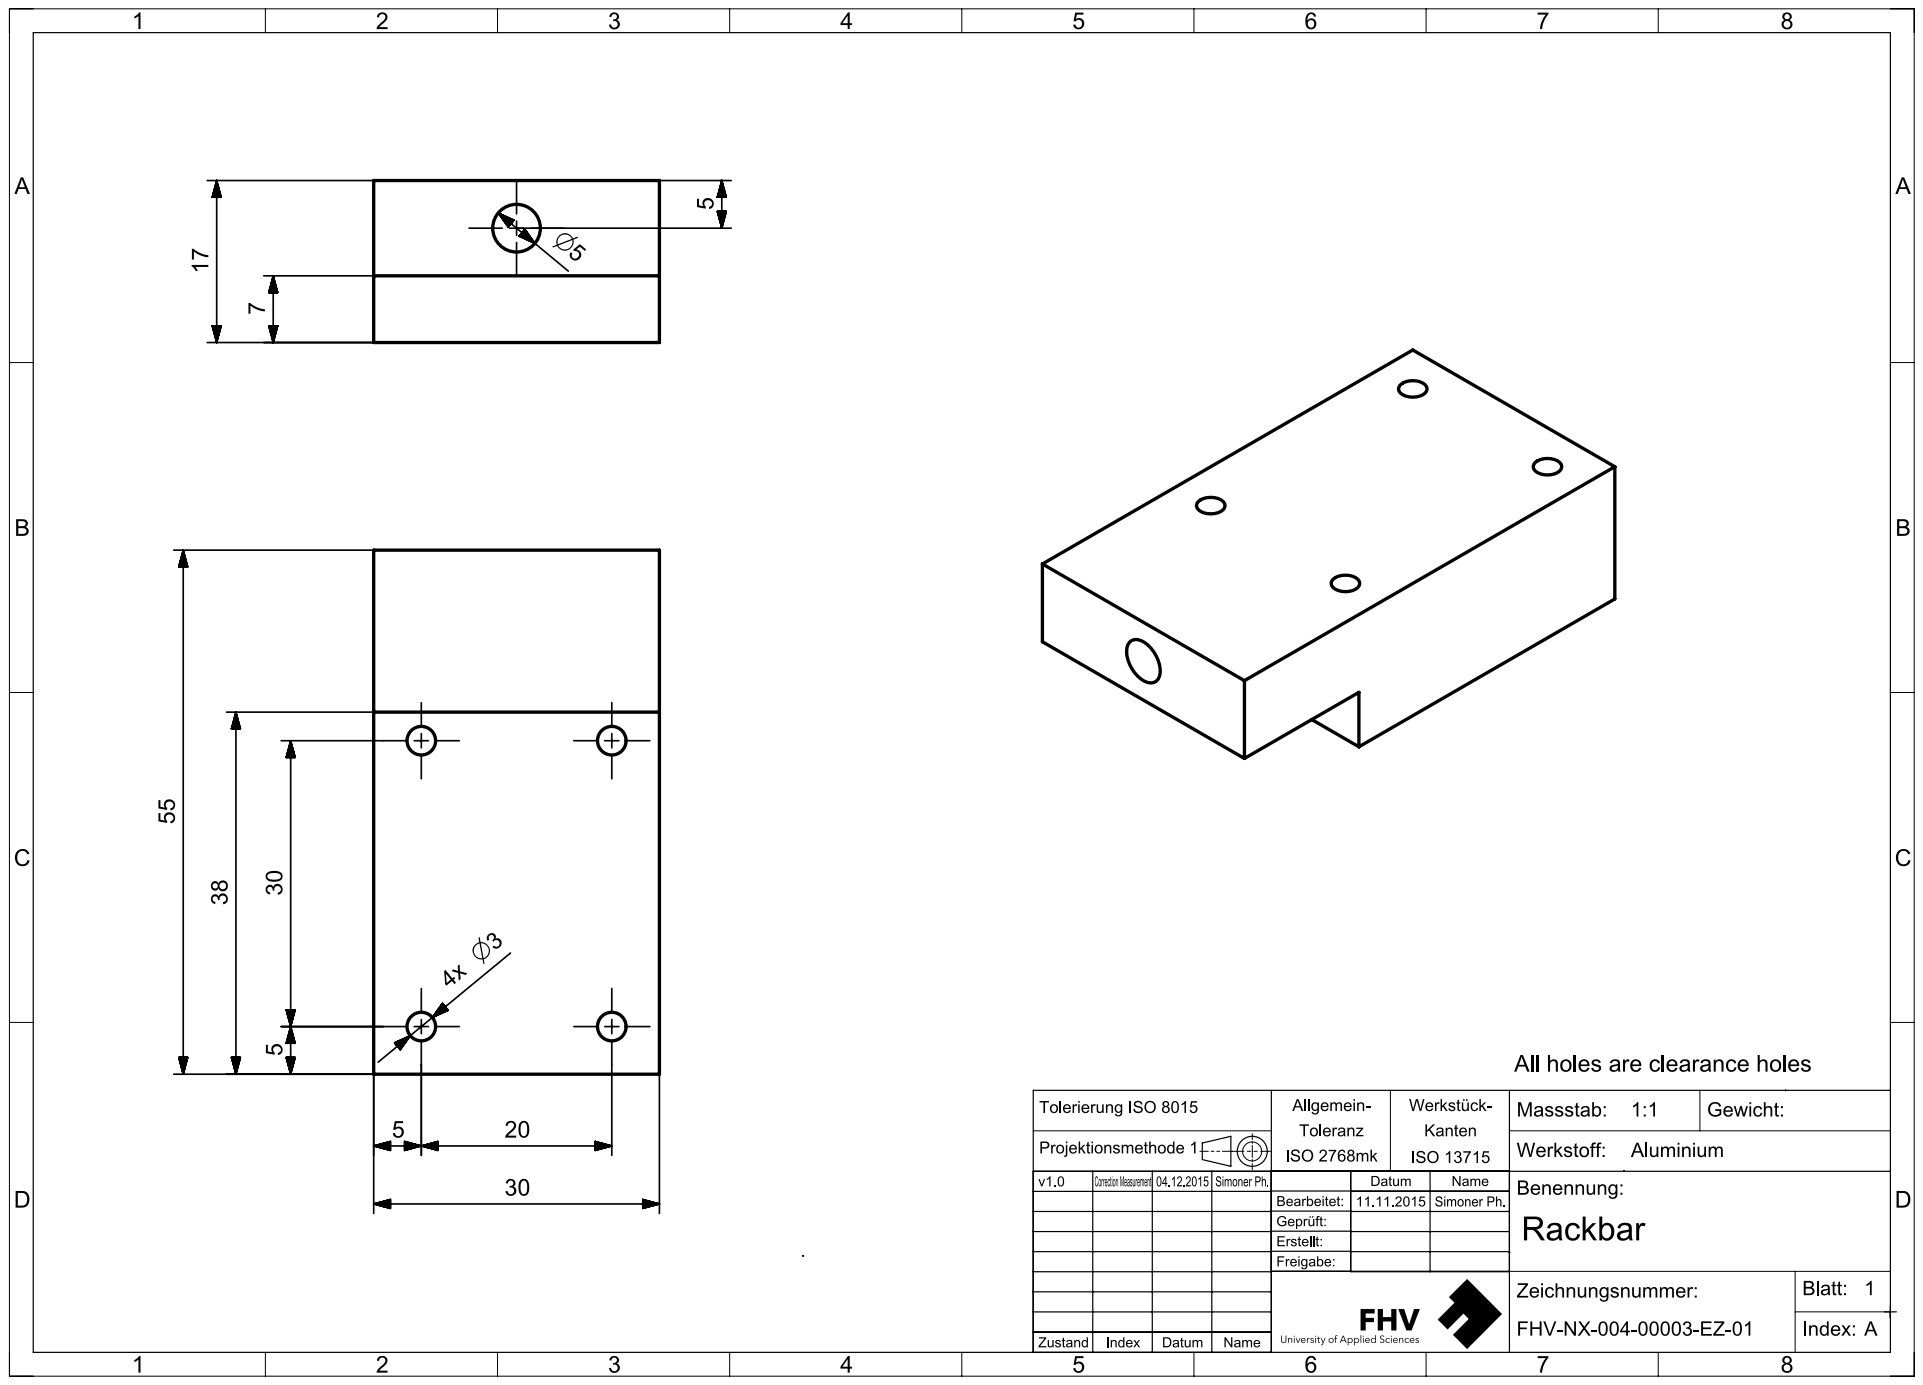
[picture p67: page 1]
