pasrom/grabtastic/Mechanical_Stuff/Final Draftings/psi5321_snapConnV5.pdf

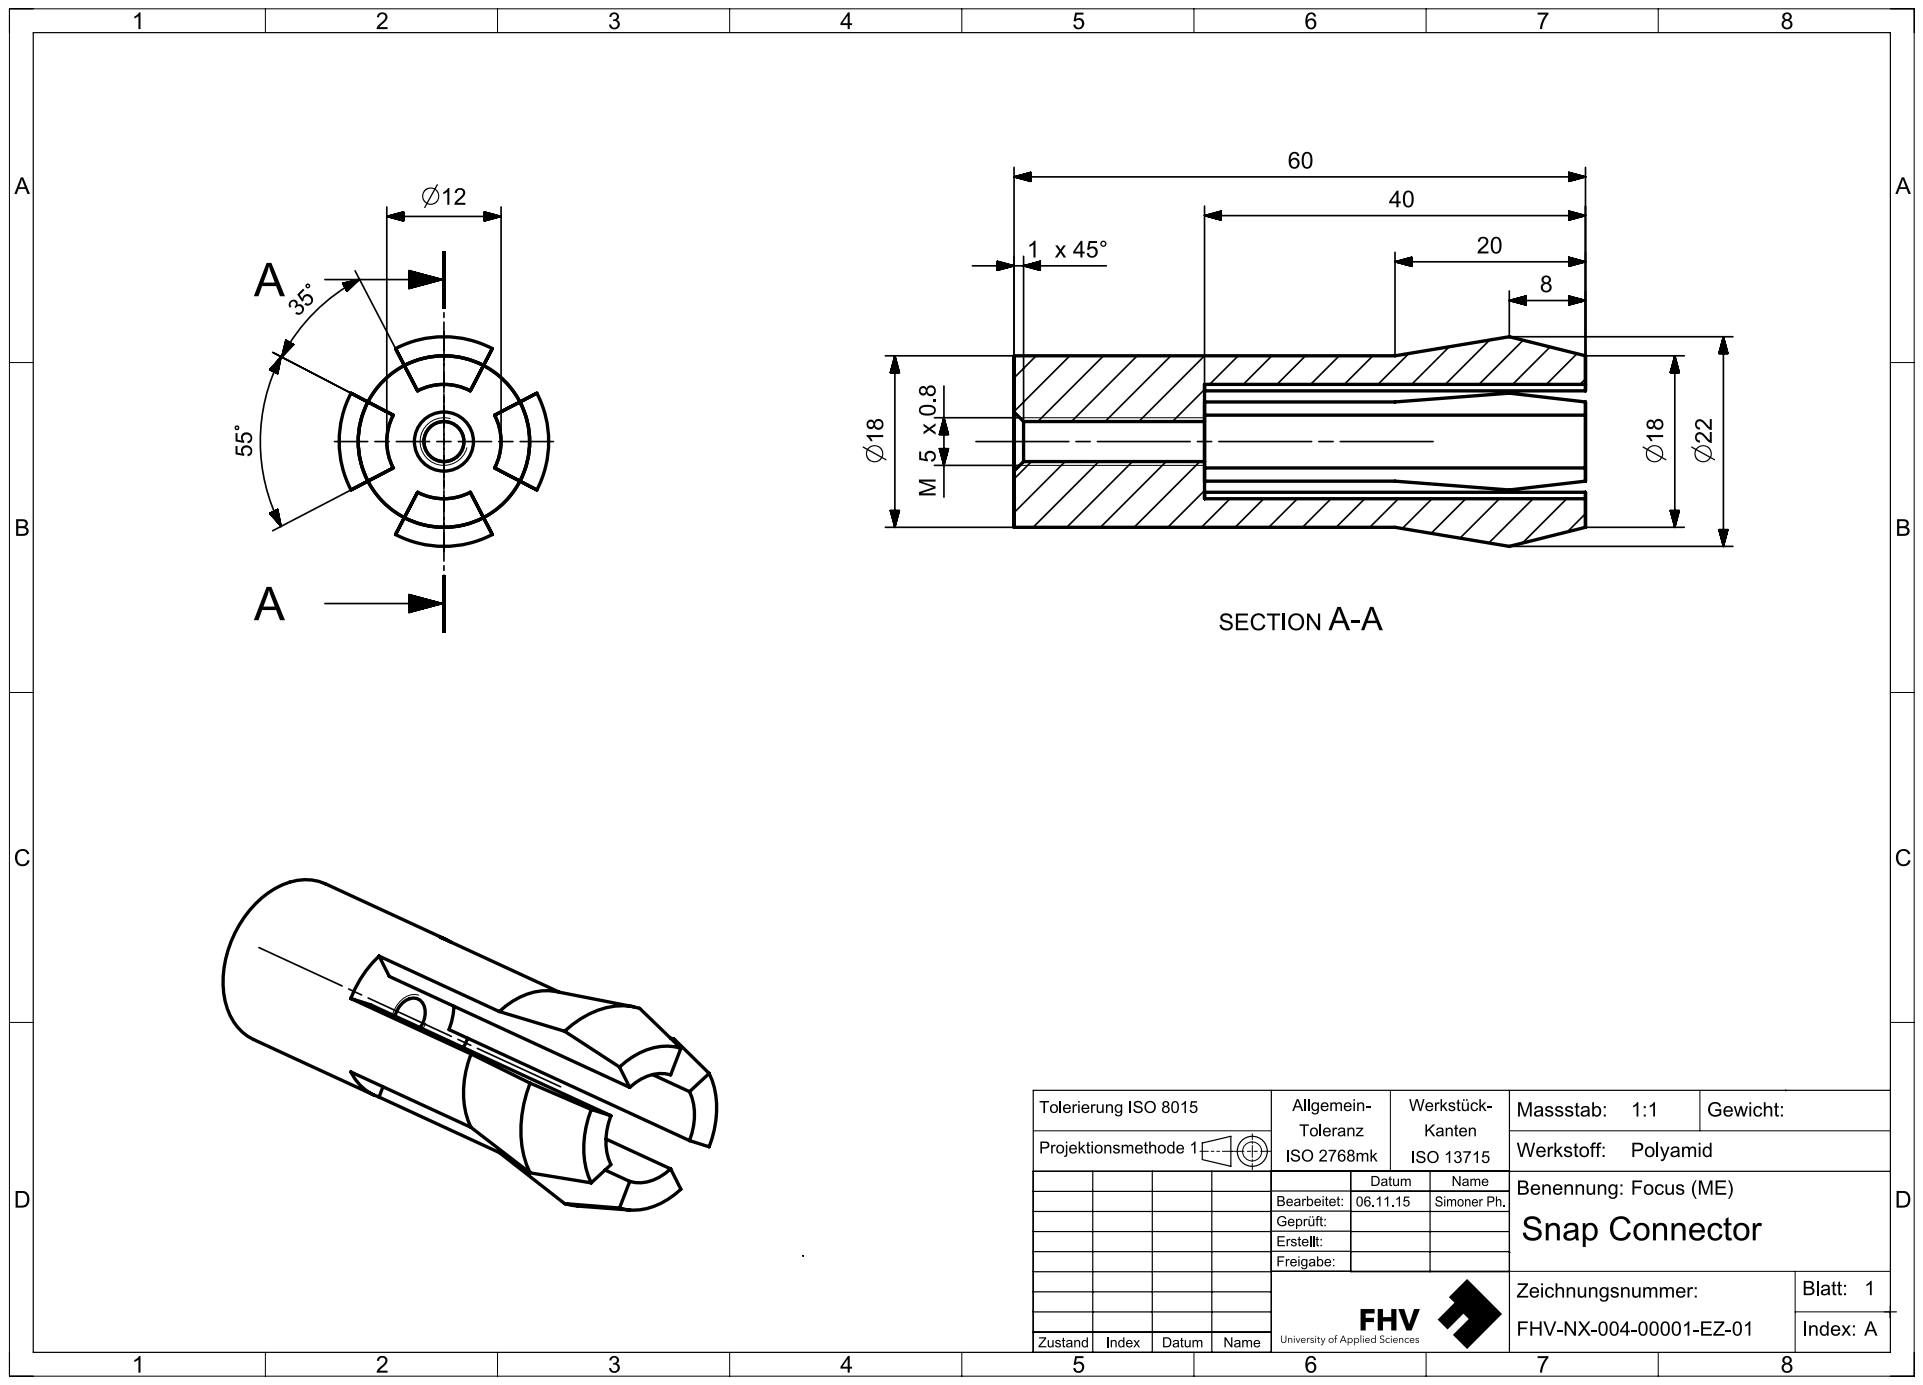
[picture p68: page 1]
