pasrom/grabtastic/Mechanical_Stuff/Final Draftings/psi5321_upperplate.pdf

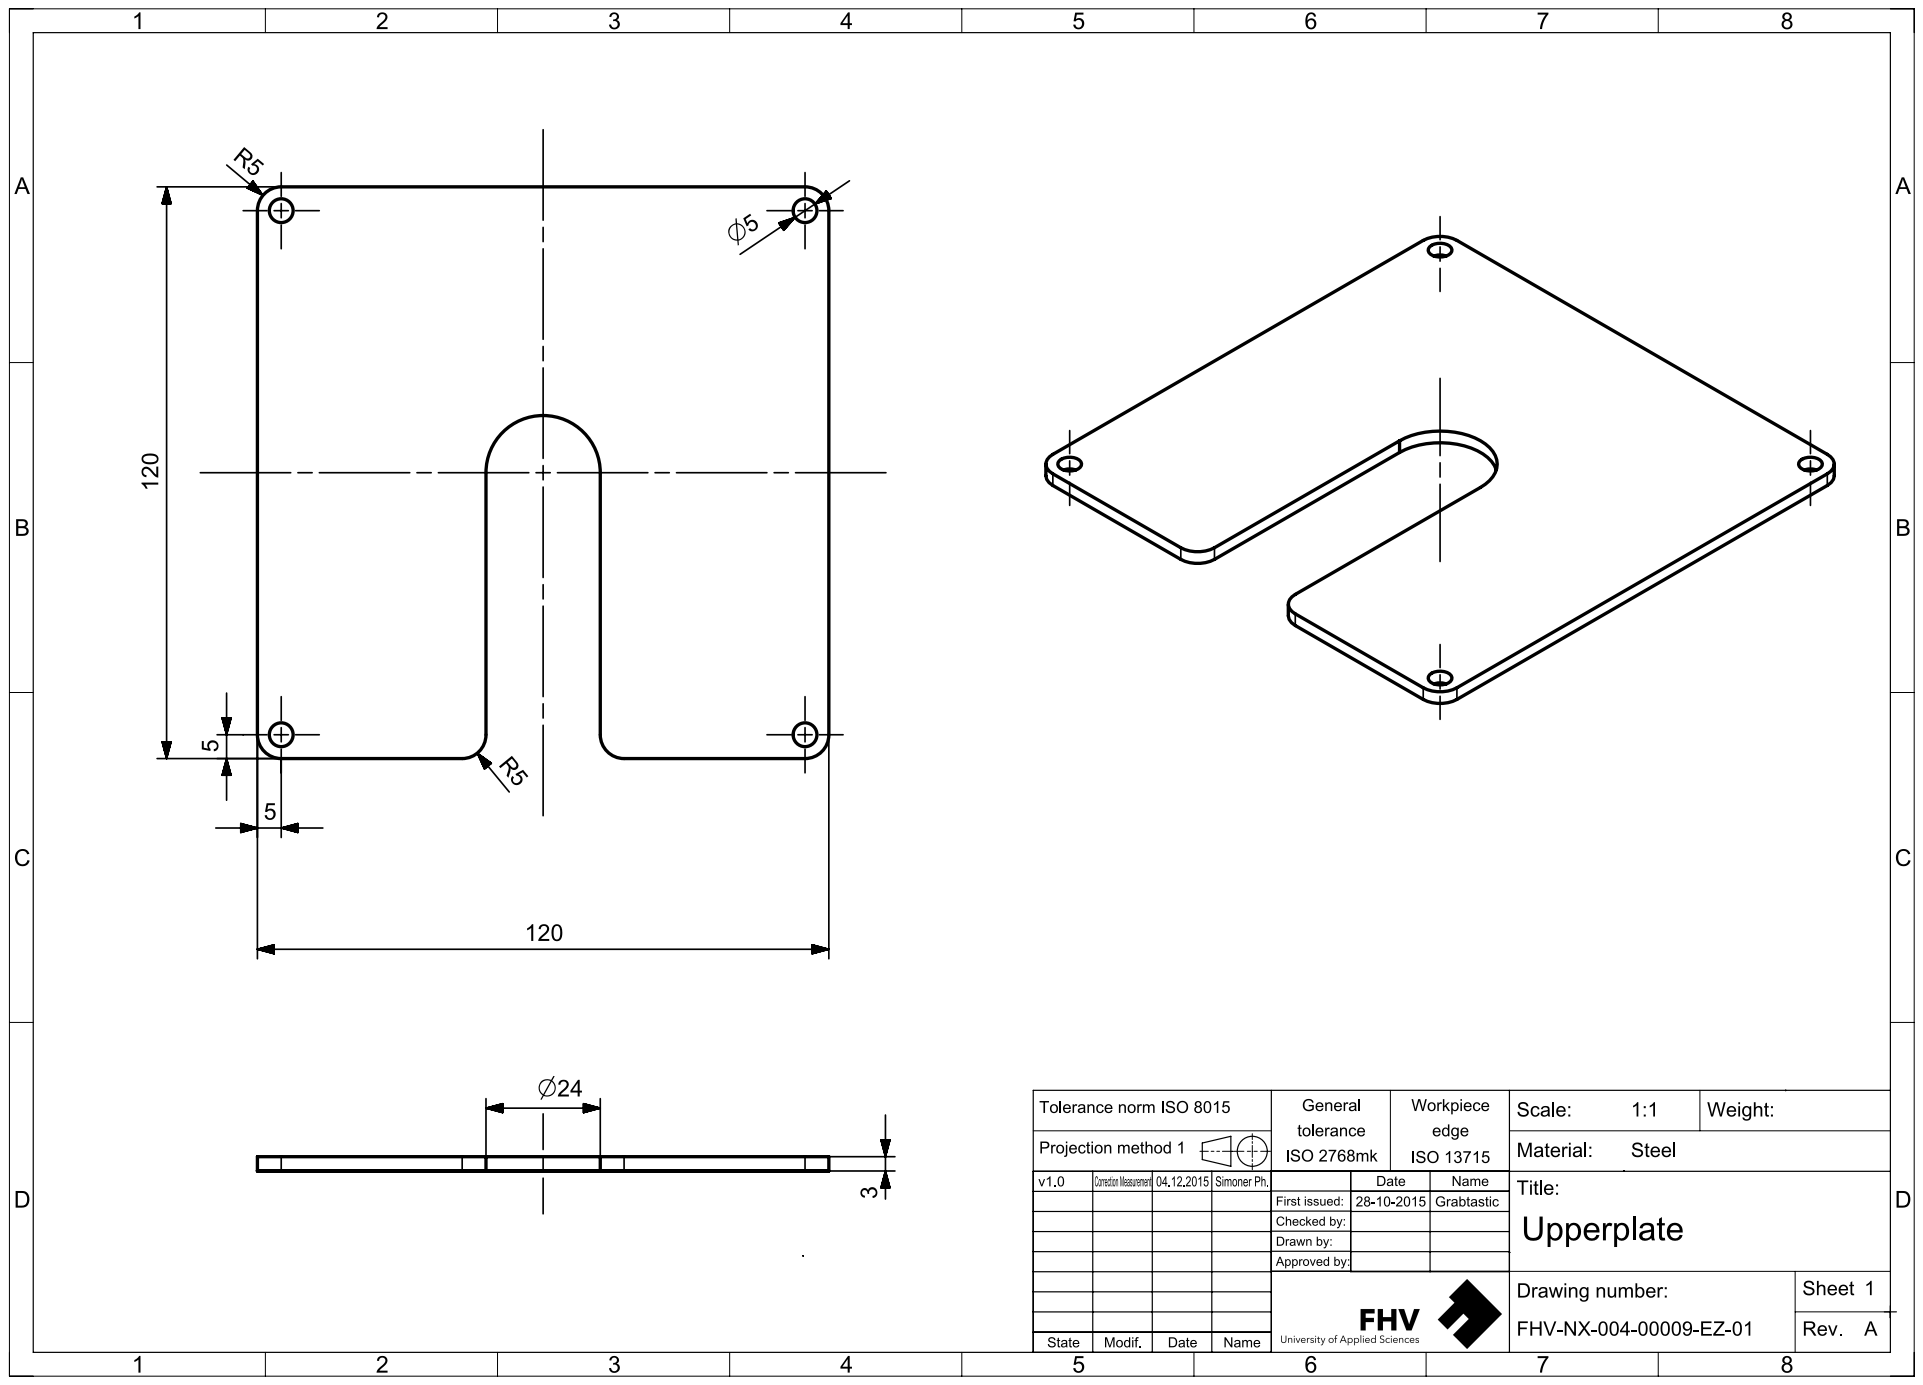
[picture p69: page 1]
