pasrom/grabtastic/Mechanical_Stuff/Z-Axis_v1/kki8361_frame2.pdf

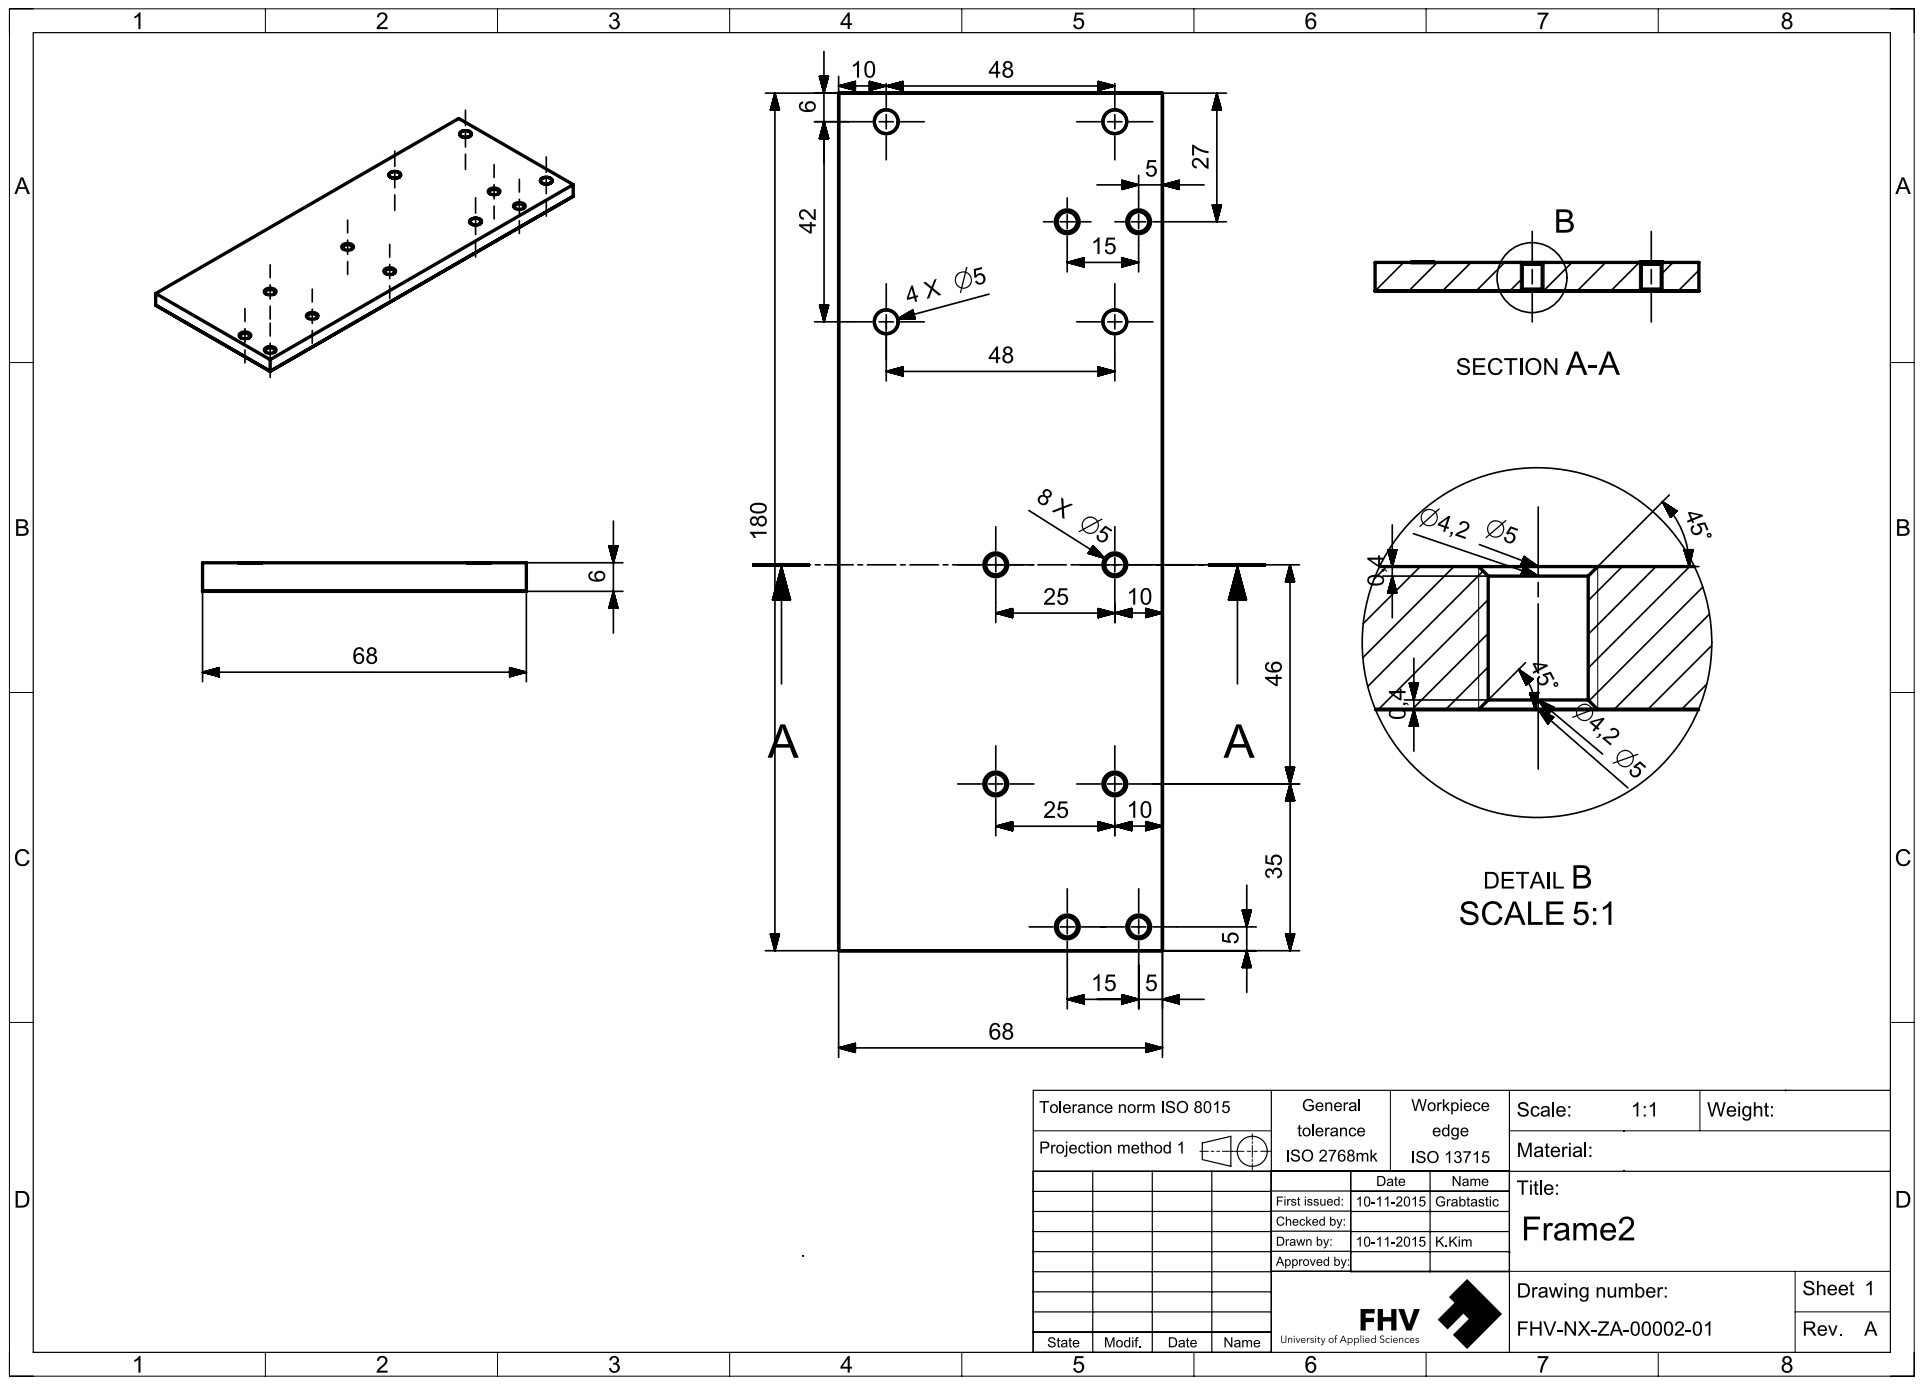
[picture p70: page 1]
