pasrom/grabtastic/Electronic_Stuff/PCB_Layout/Straingauge documentation/PCB_BOTTOM_v_2_0.pdf

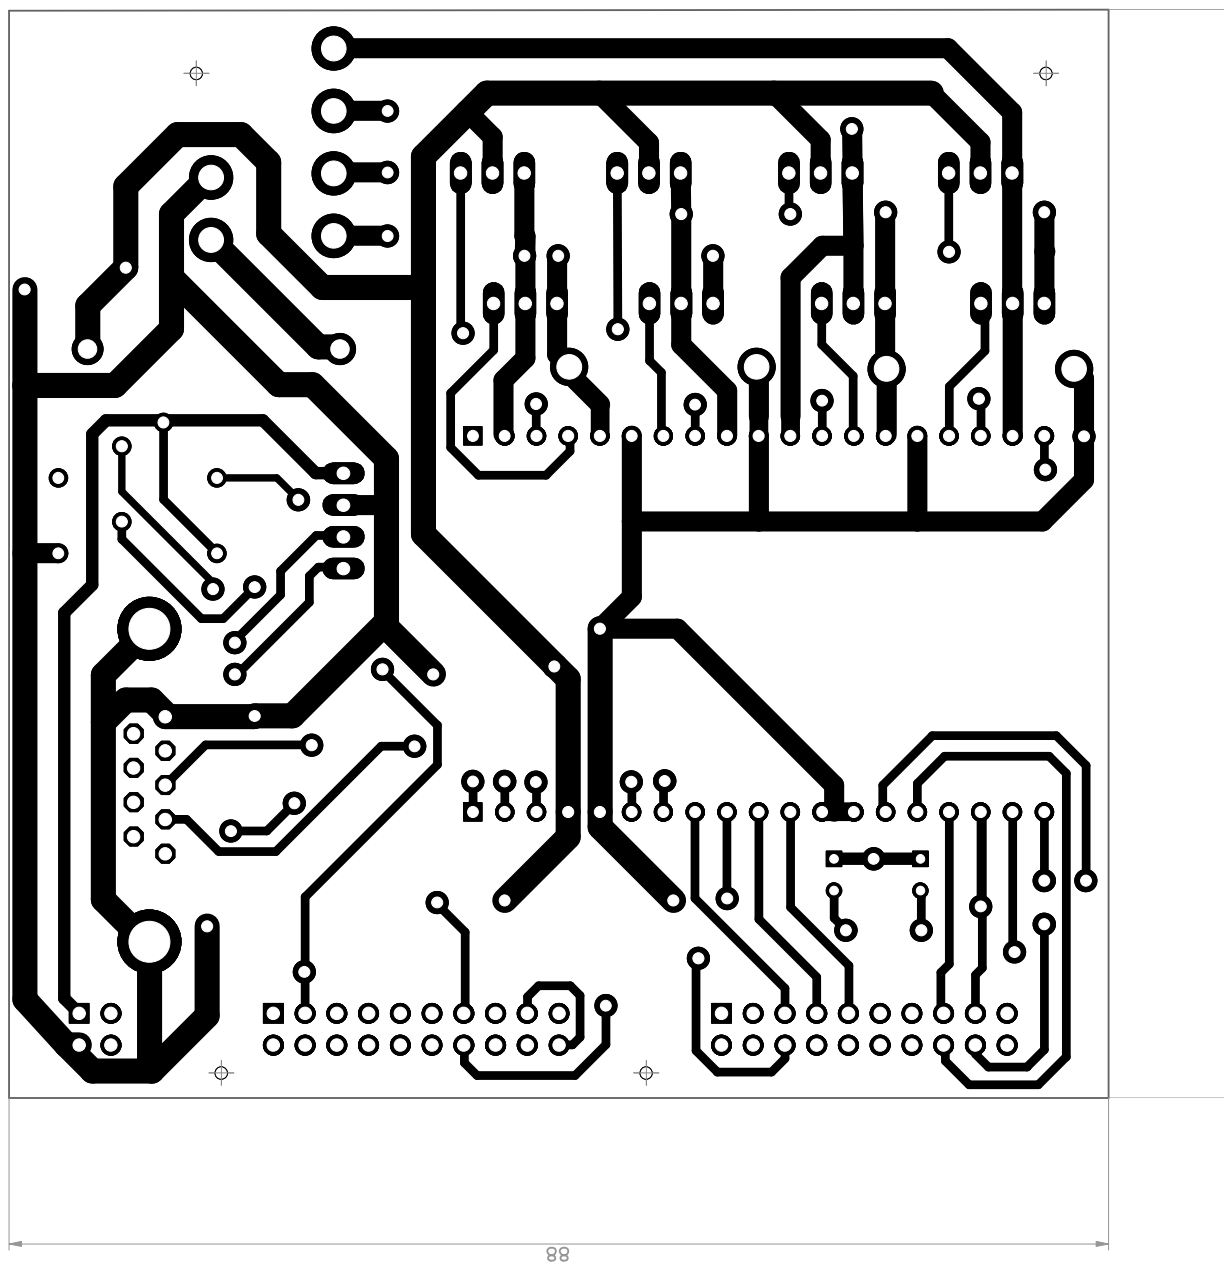
[picture p71: page 1]
