pasrom/grabtastic/Electronic_Stuff/PCB_Layout/Straingauge documentation/PCB_TOP_v_2_0.pdf

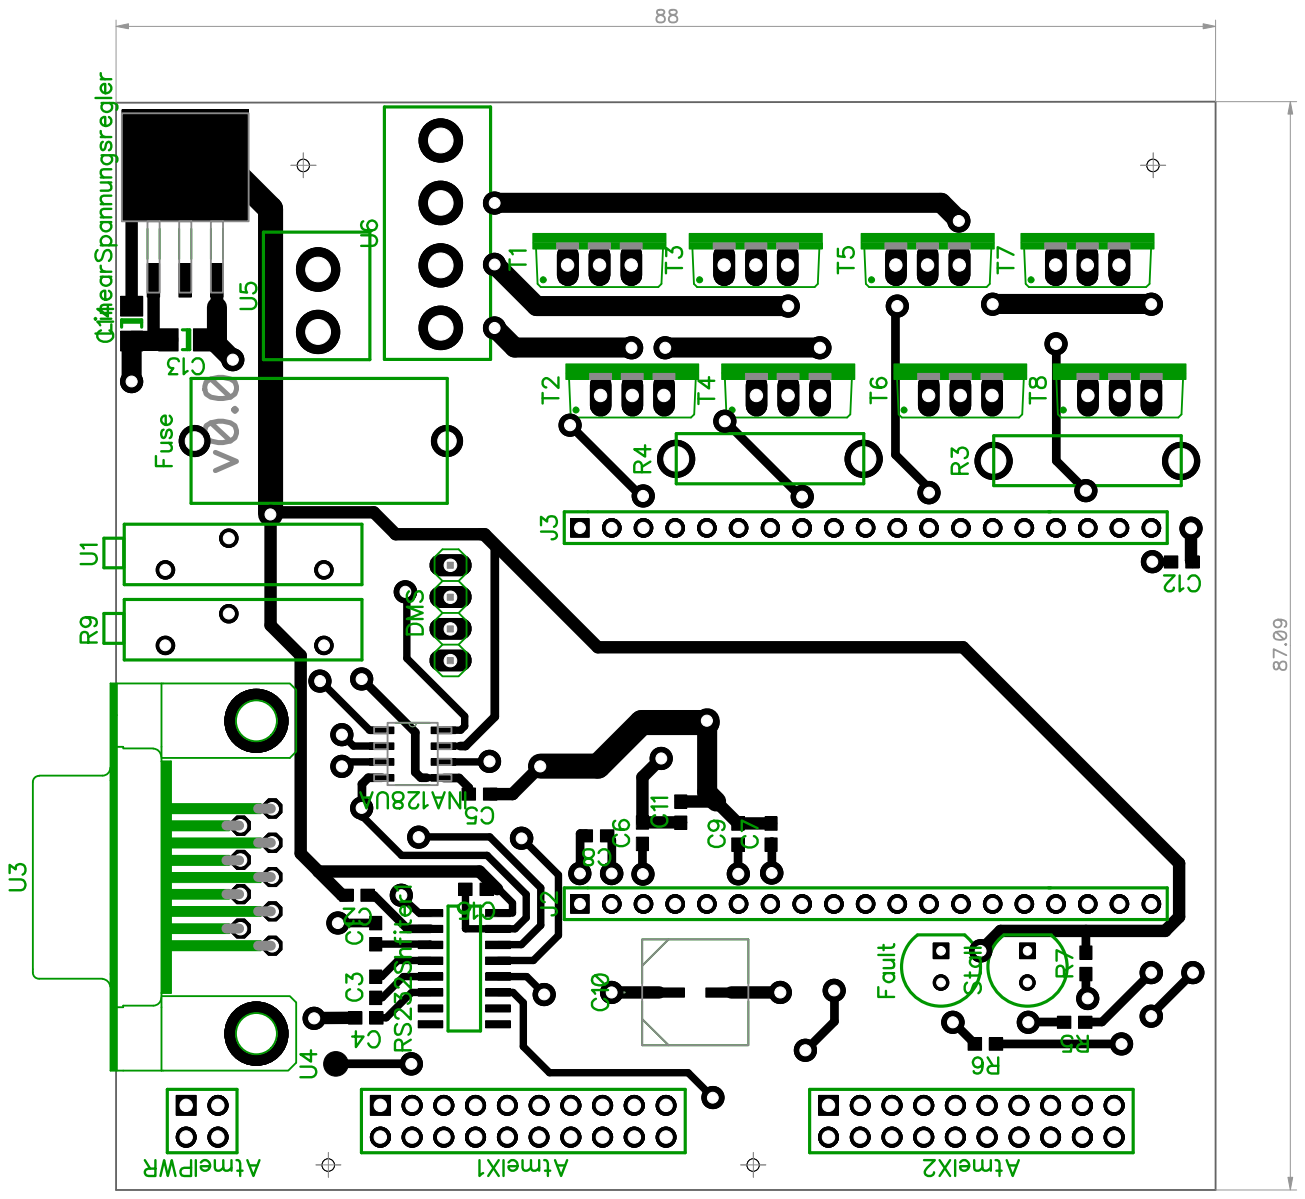
[picture p72: page 1]
