pasrom/grabtastic/Electronic_Stuff/PCB_Layout/Straingauge documentation/scematic_drv8711.pdf

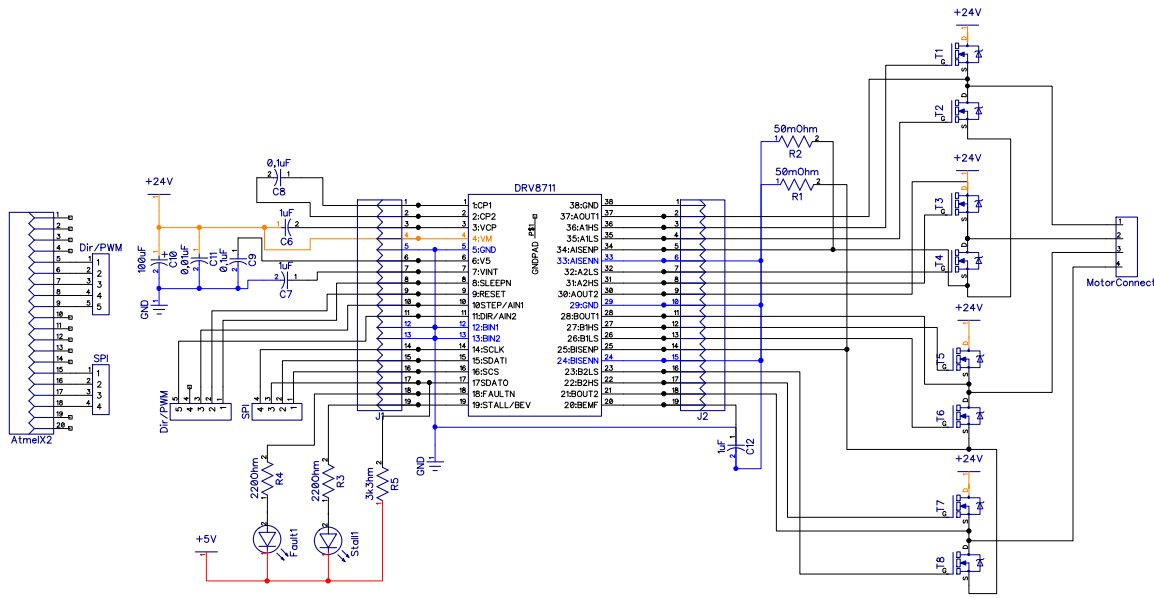
[picture p73: page 1]
