pasrom/grabtastic/Electronic_Stuff/PCB_Layout/Straingauge documentation/scematic_power_rs232_strain.pdf

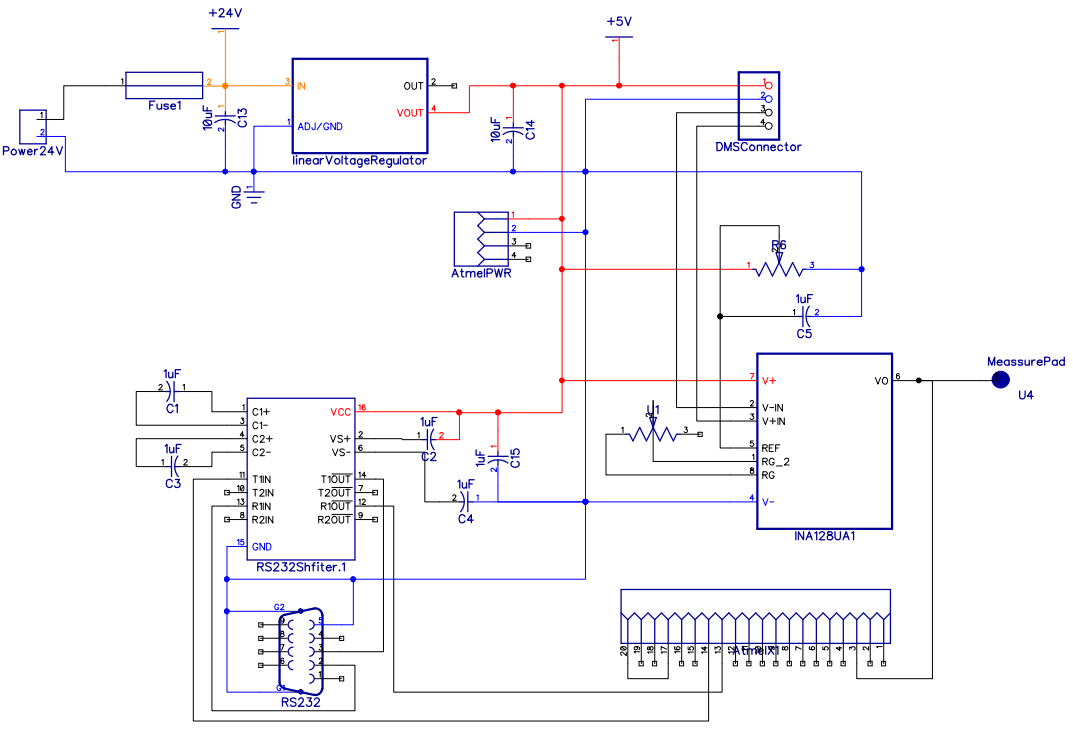
[picture p74: page 1]
