pasrom/grabtastic/Electronic_Stuff/PCB_Layout/Straingauge documentation/scematic_switch_emergency.pdf

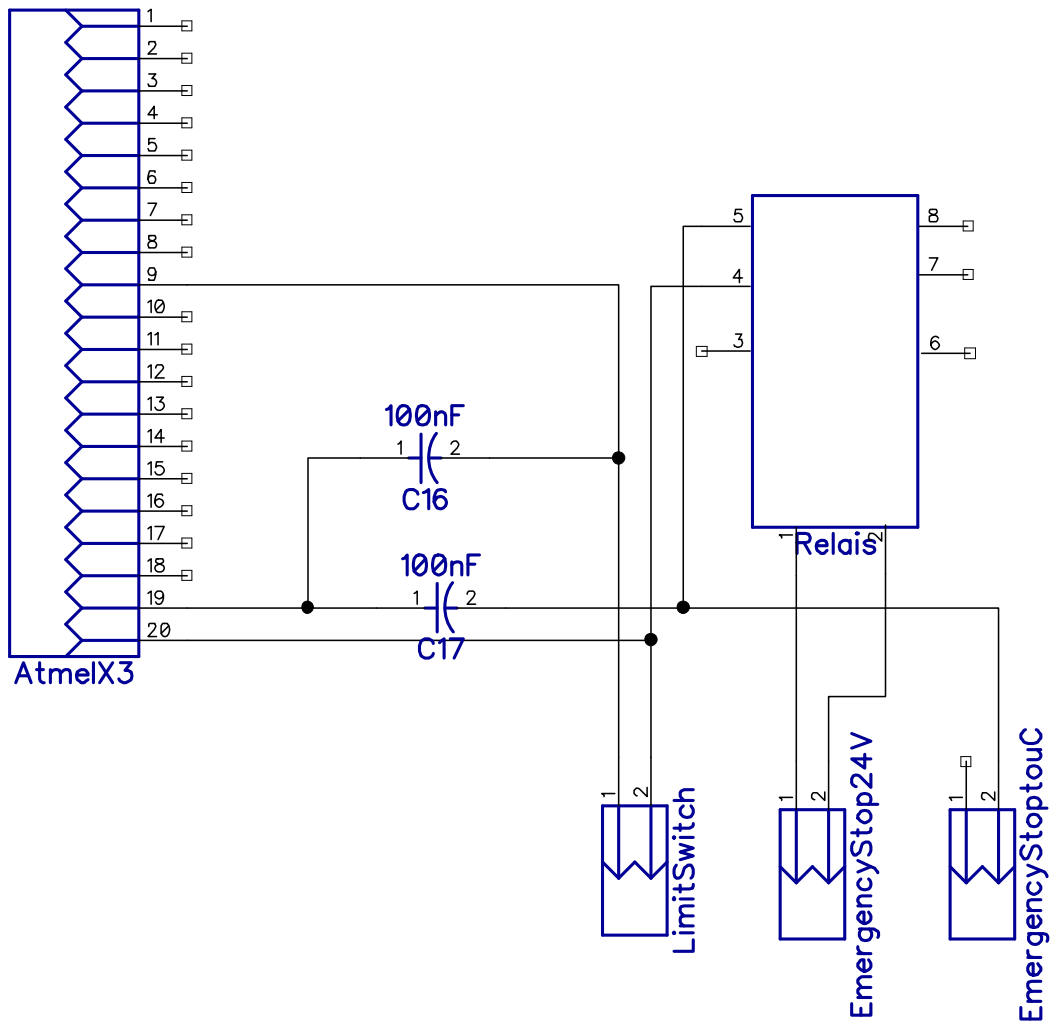
[picture p75: page 1]
