pasrom/grabtastic/Electronic_Stuff/PCB_Layout/Straingauge documentation/scematic_v_1_0.pdf

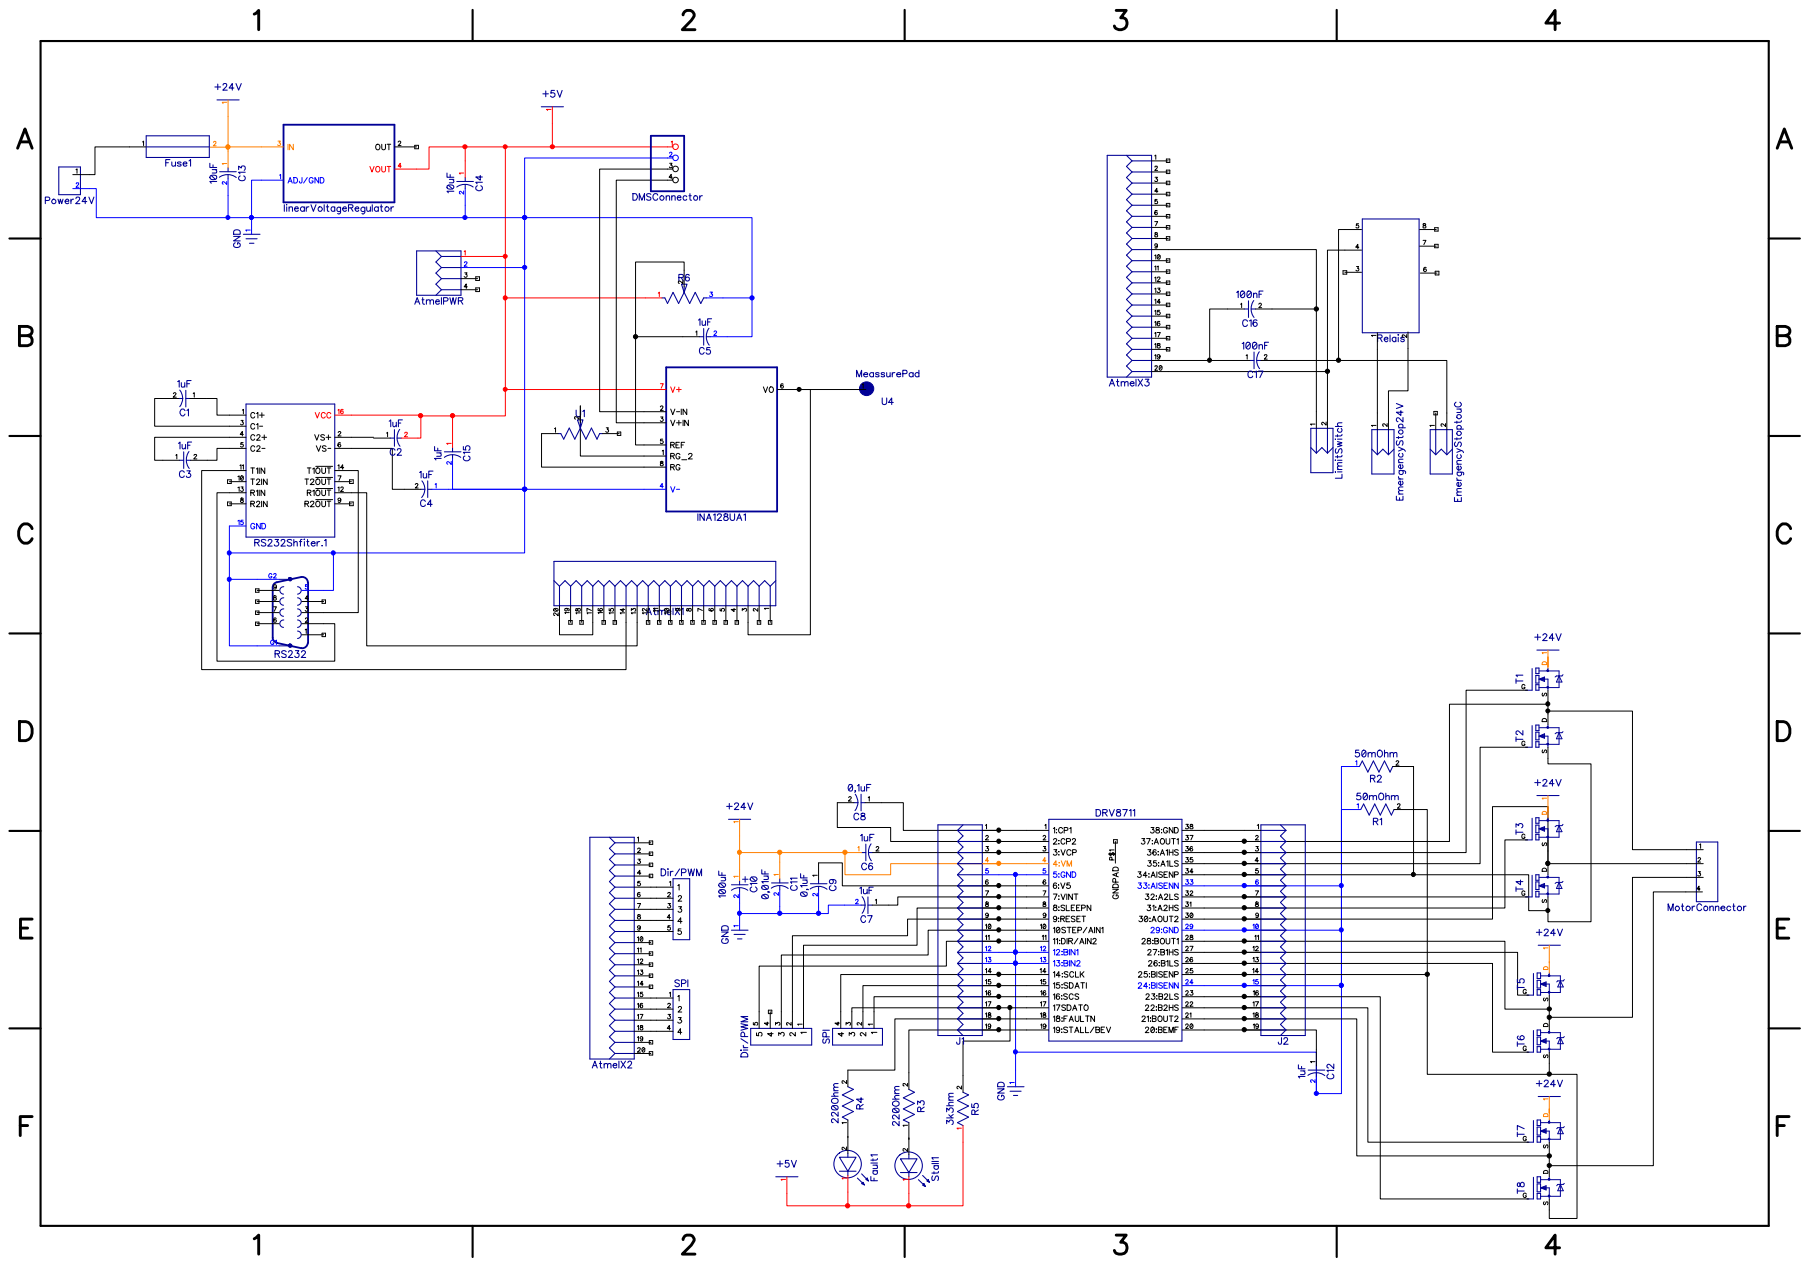
[picture p76: page 1]
