pasrom/grabtastic/Mechanical_Stuff/repositoryDesign/Drafting_Modified/kki8361_assembly_Targetrepository.pdf

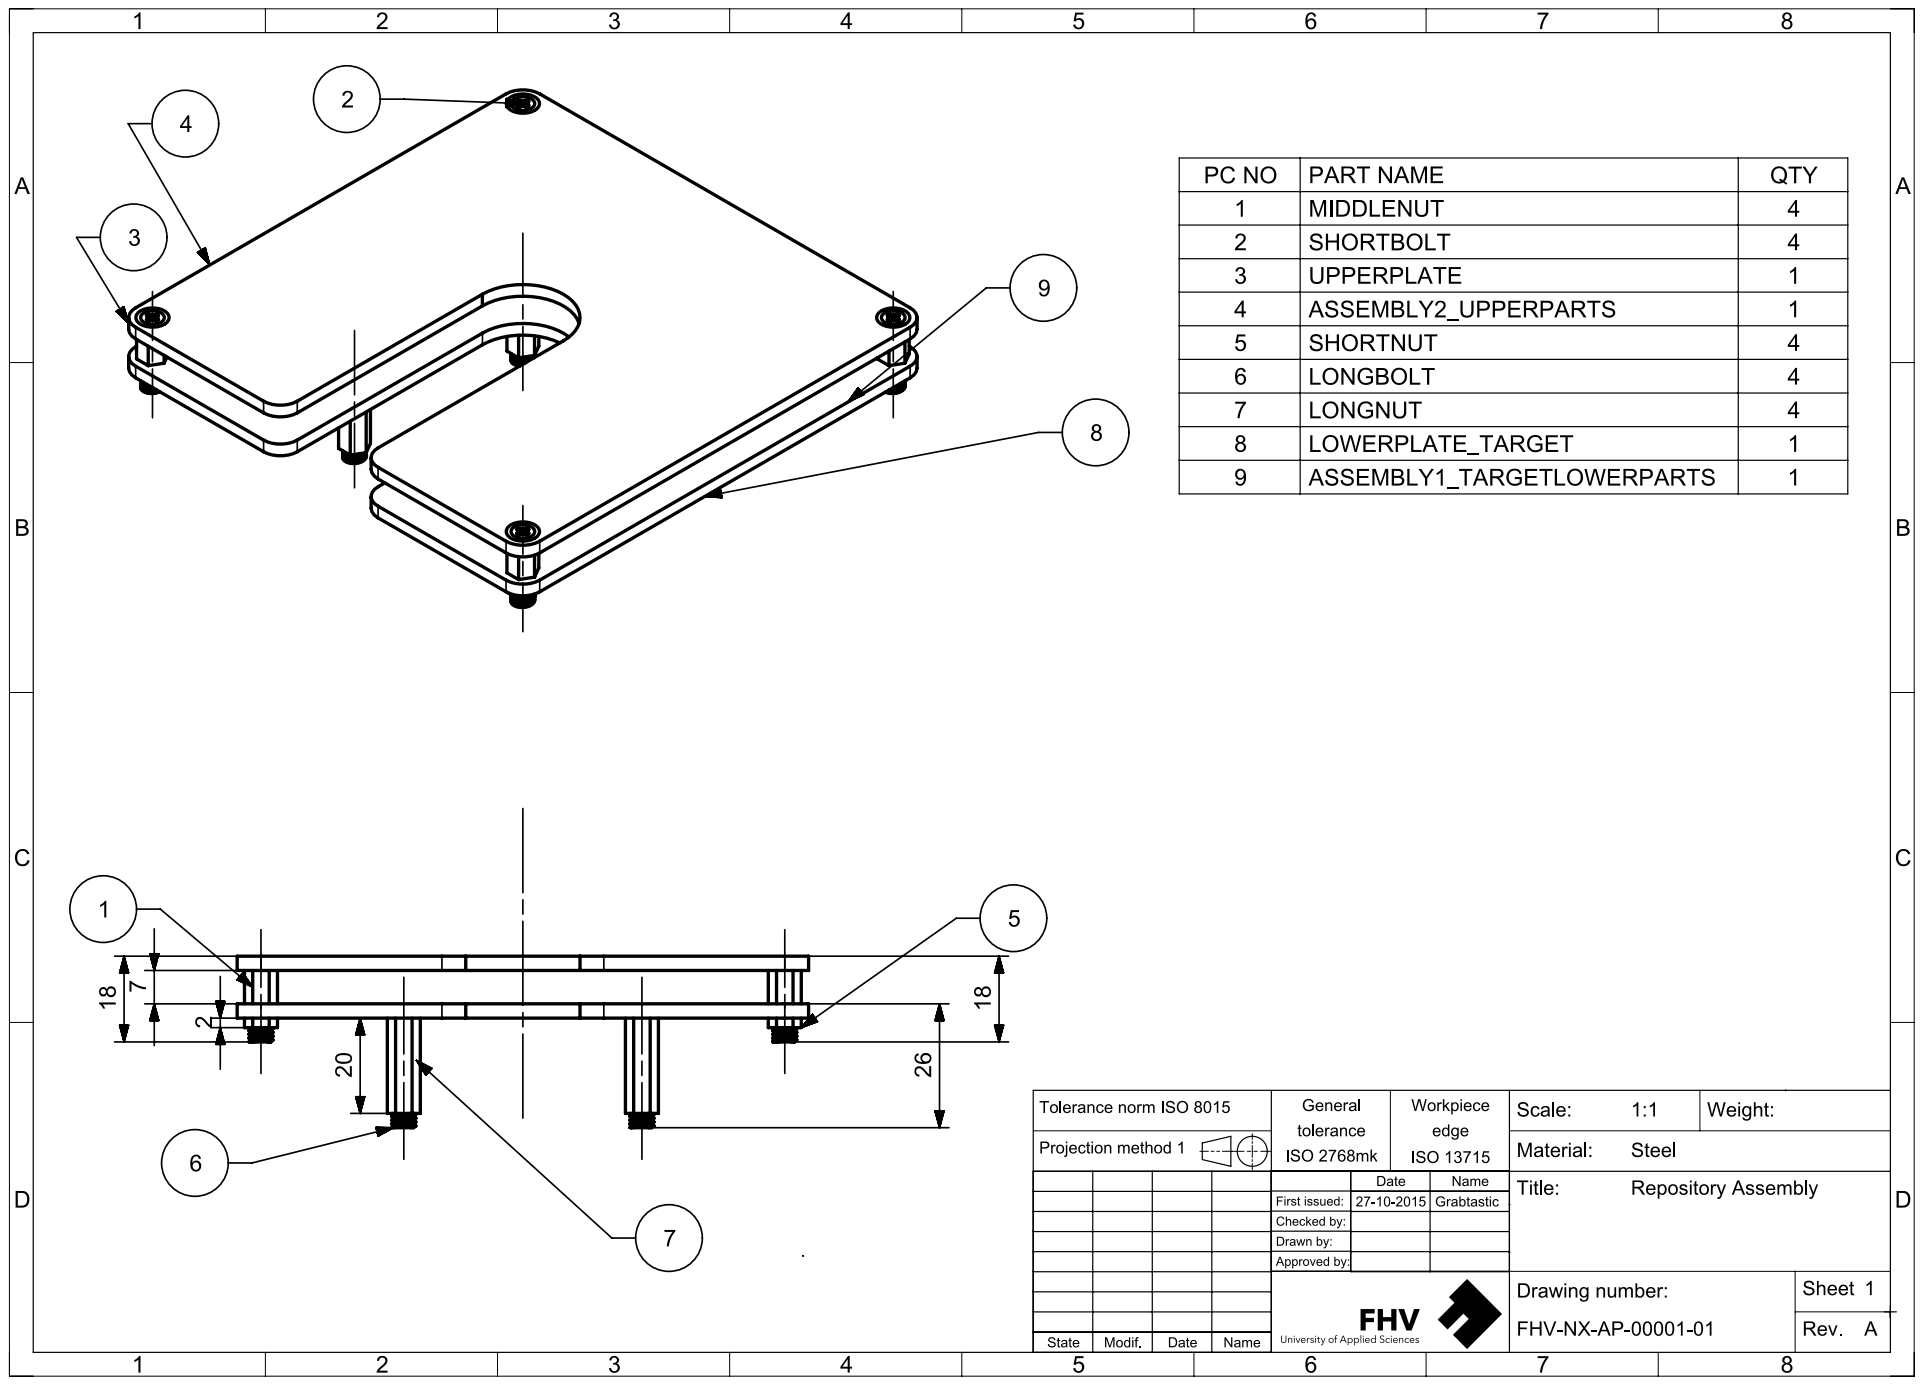
[picture p77: page 1]
