pasrom/grabtastic/Mechanical_Stuff/repositoryDesign/Drafting_Modified/kki8361_lowerplate_target.pdf

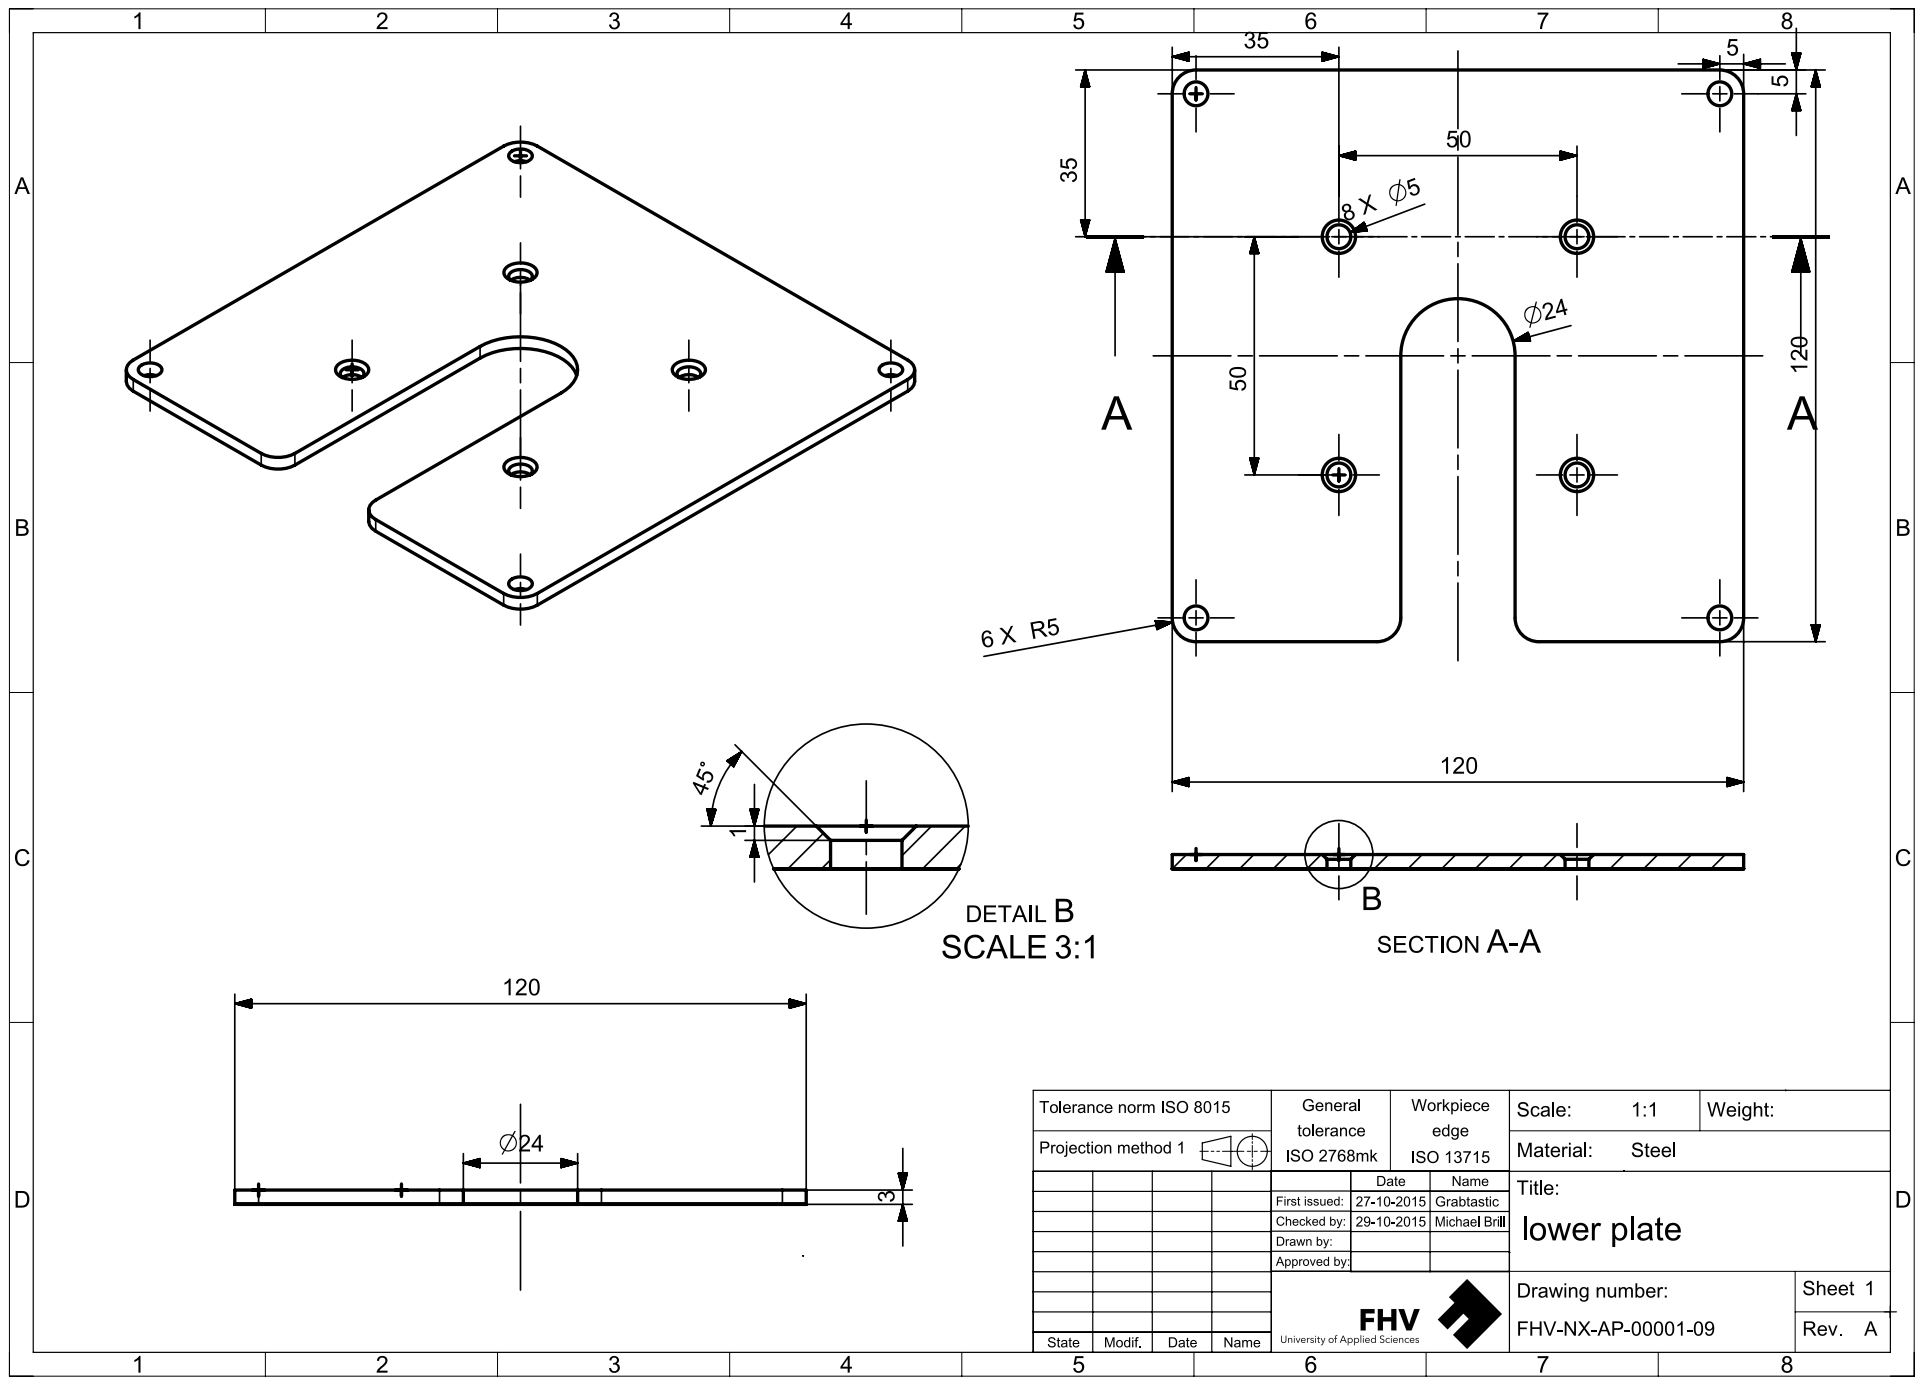
[picture p78: page 1]
