pasrom/grabtastic/Mechanical_Stuff/repositoryDesign/Drafting_Modified/kki8361_upperplate.pdf

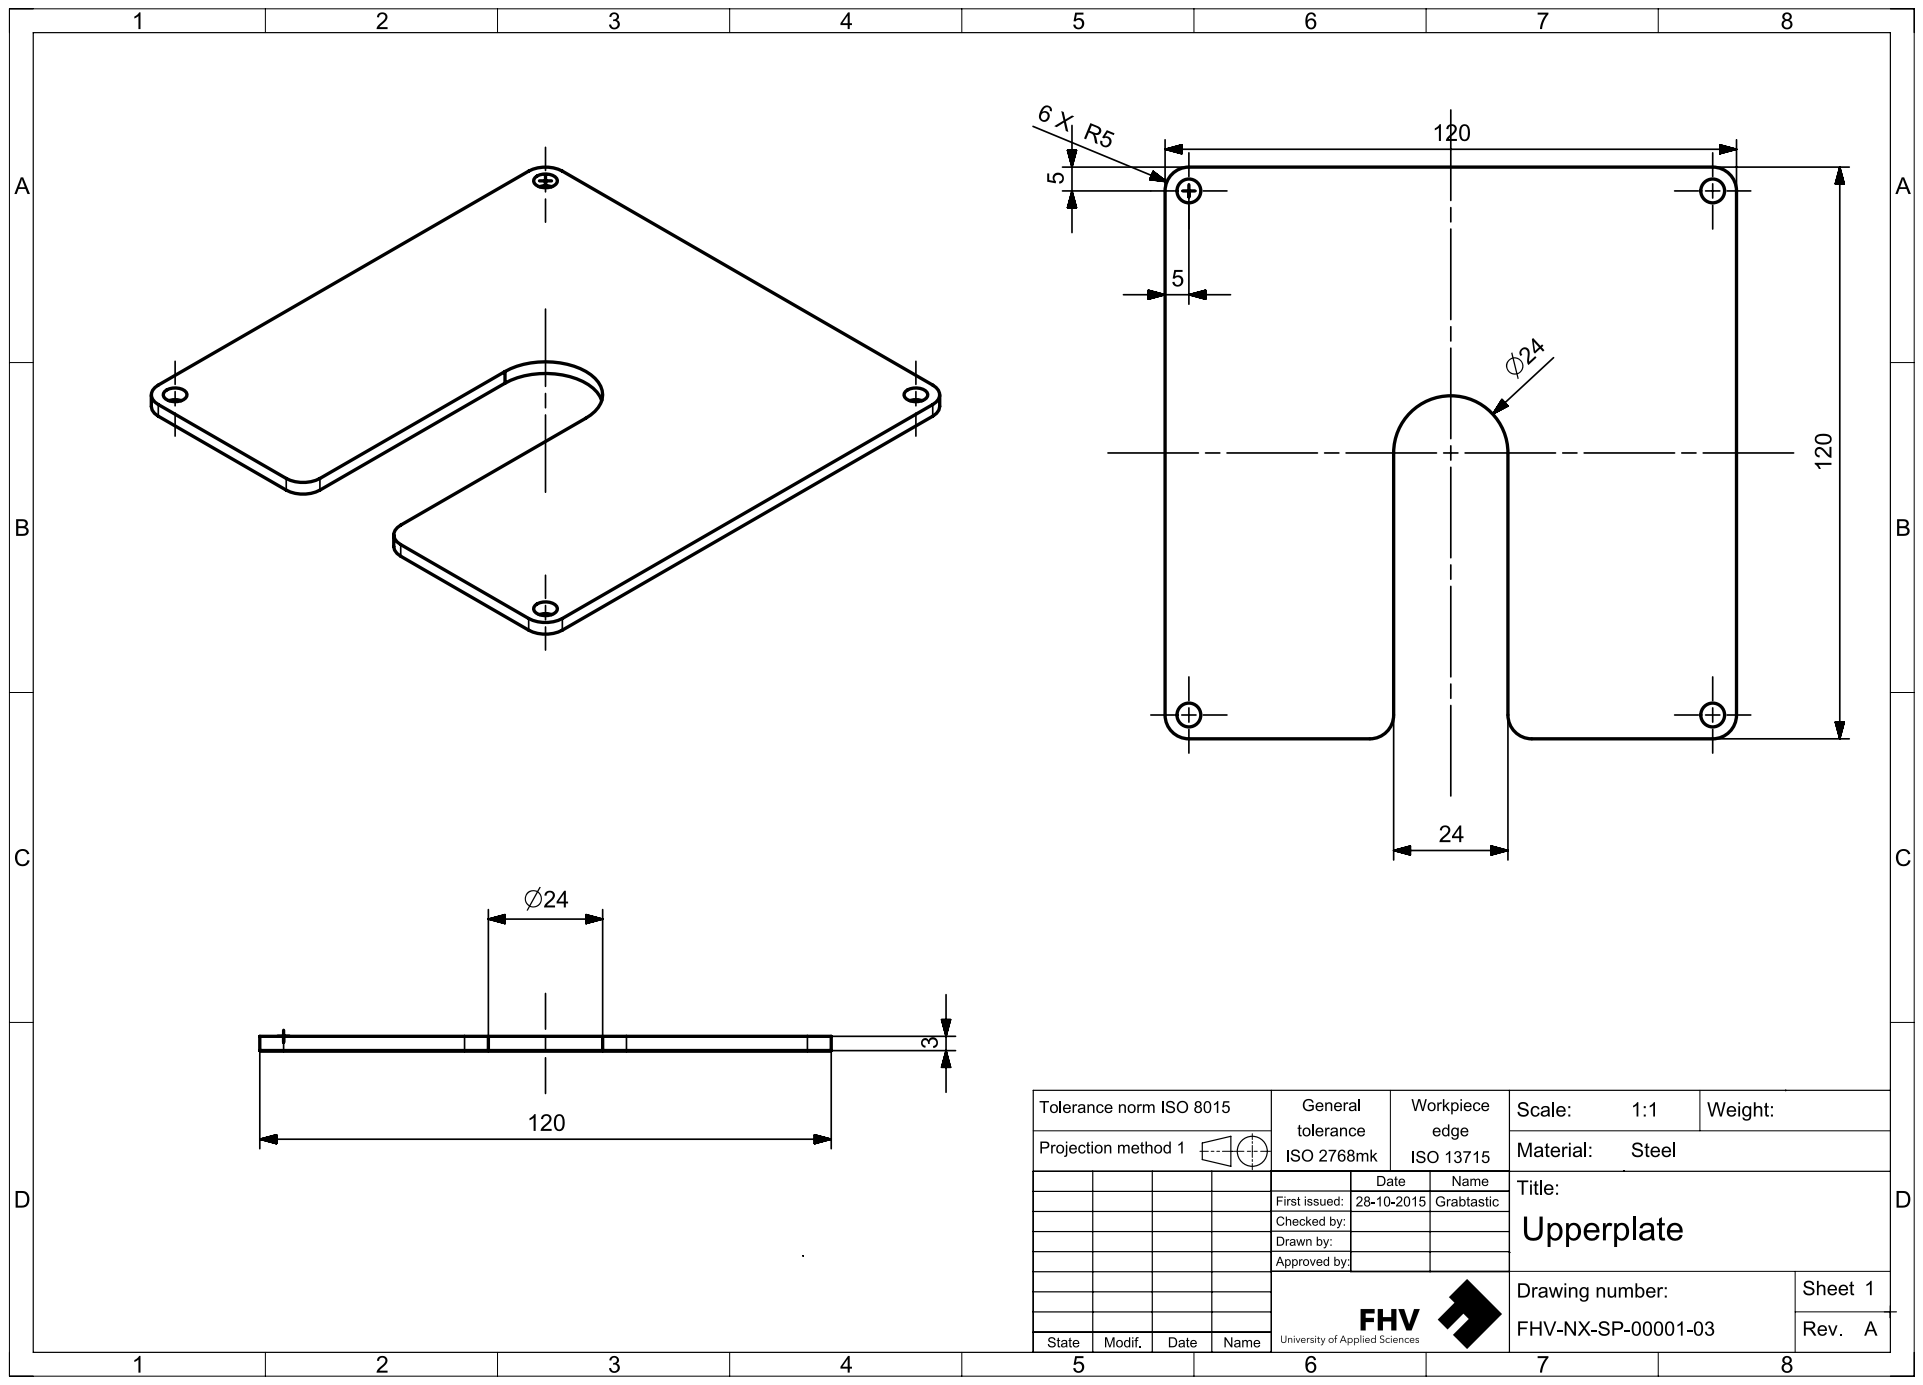
[picture p79: page 1]
