pasrom/grabtastic/Documenation/group_4_grabtastic/pictures/atmel_bottom.pdf

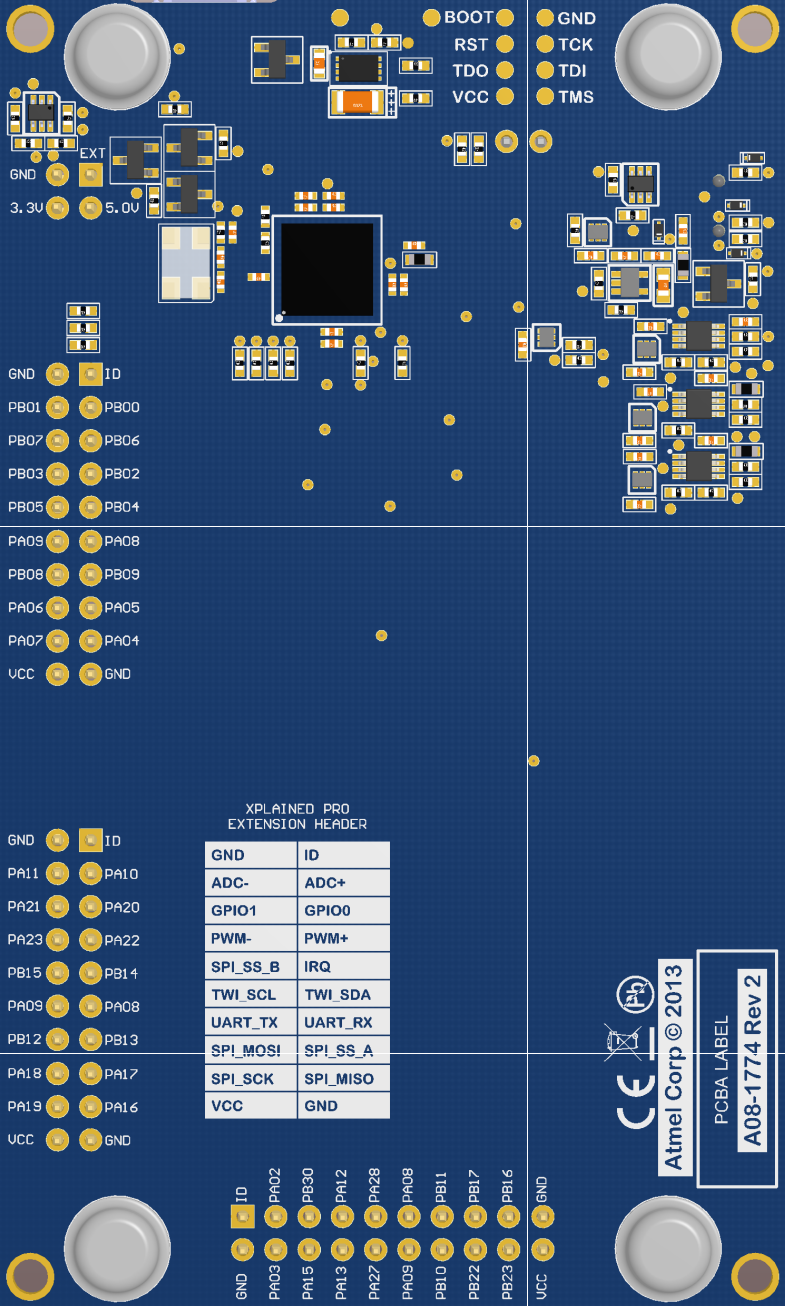
[picture p80: page 1]
