pasrom/grabtastic/Documenation/group_4_grabtastic/pictures/atmel_top.pdf

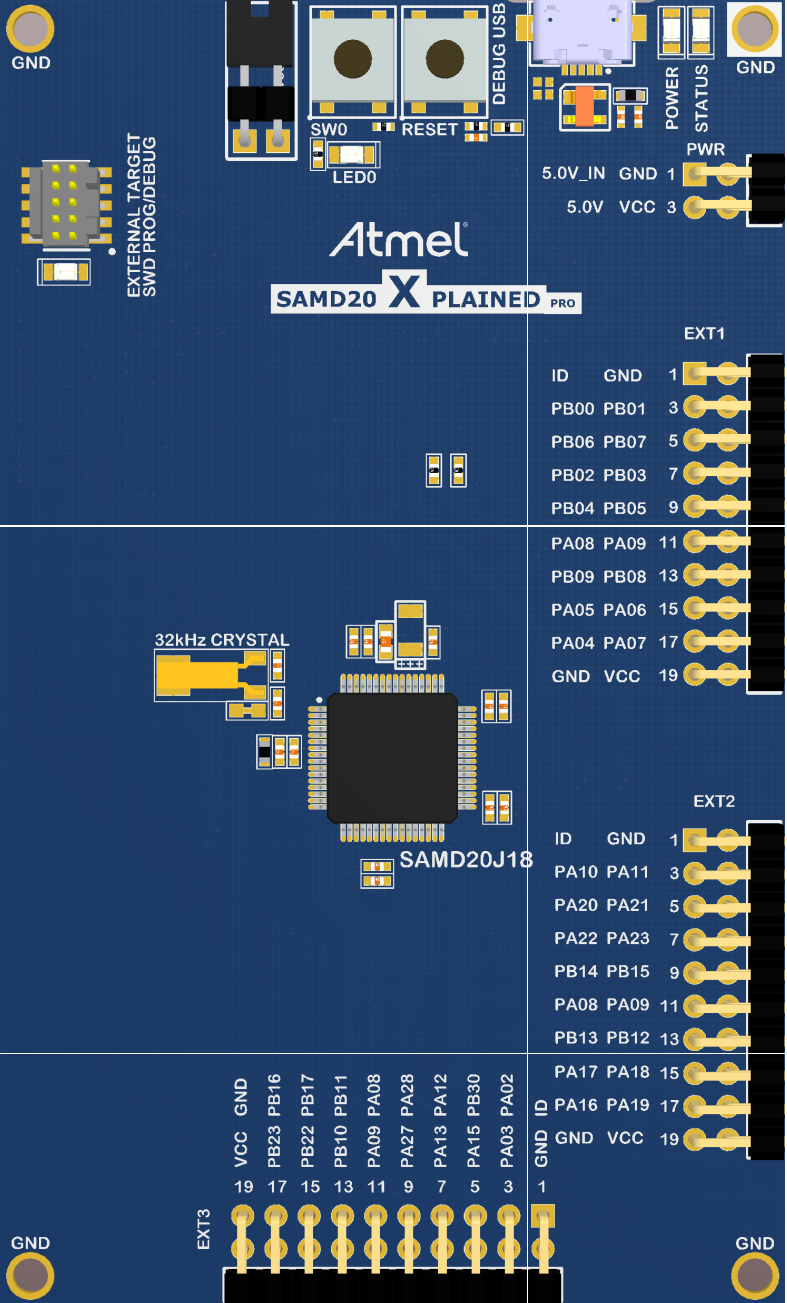
[picture p81: page 1]
