pasrom/grabtastic/Documenation/group_4_grabtastic/pictures/PCB_BOTTOM_v_2_0.pdf

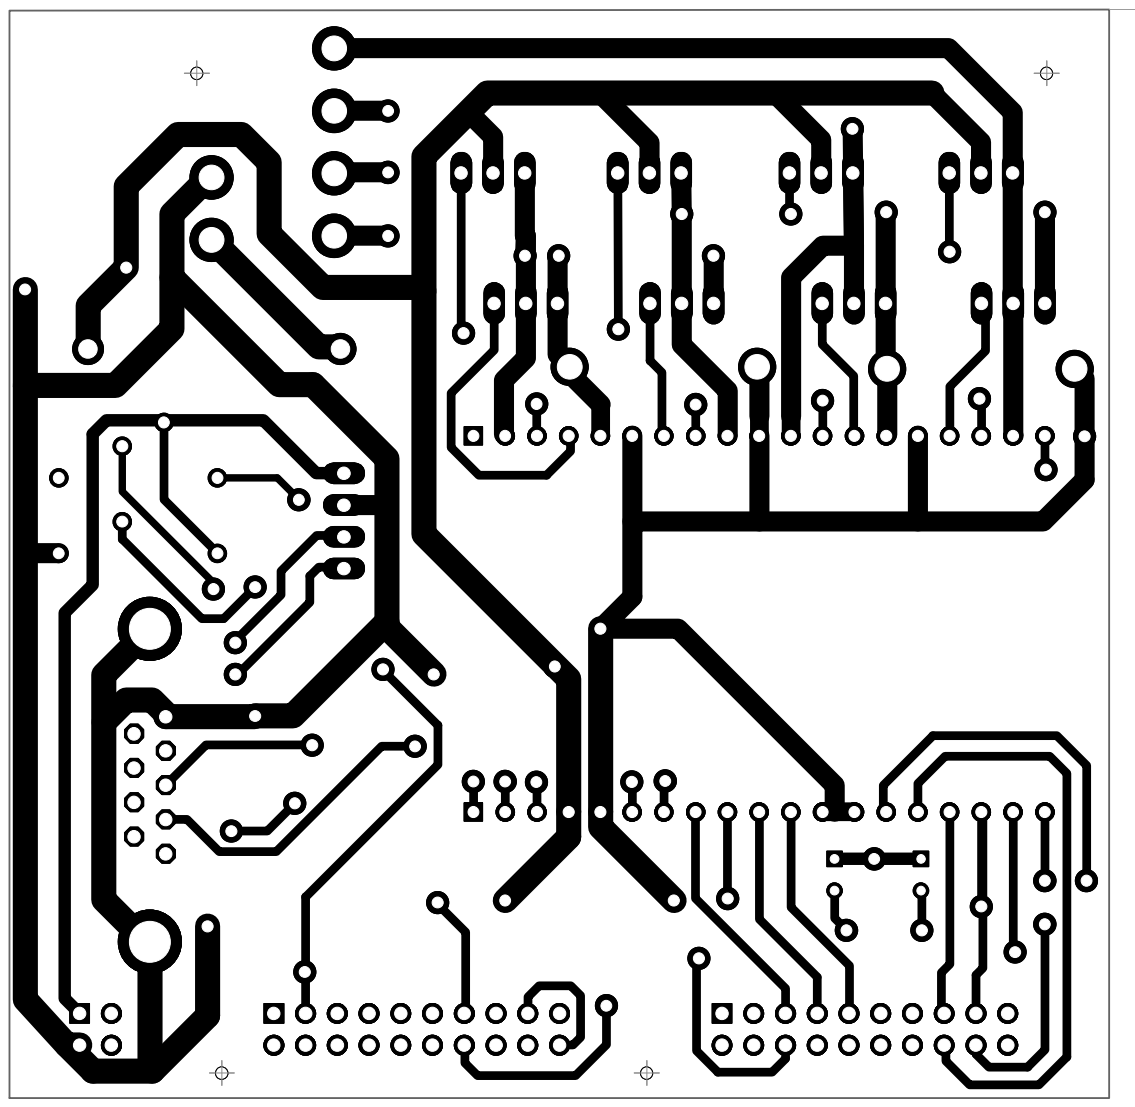
[picture p82: page 1]
