pasrom/grabtastic/Documenation/group_4_grabtastic/pictures/PCB_TOP_v_2_0.pdf

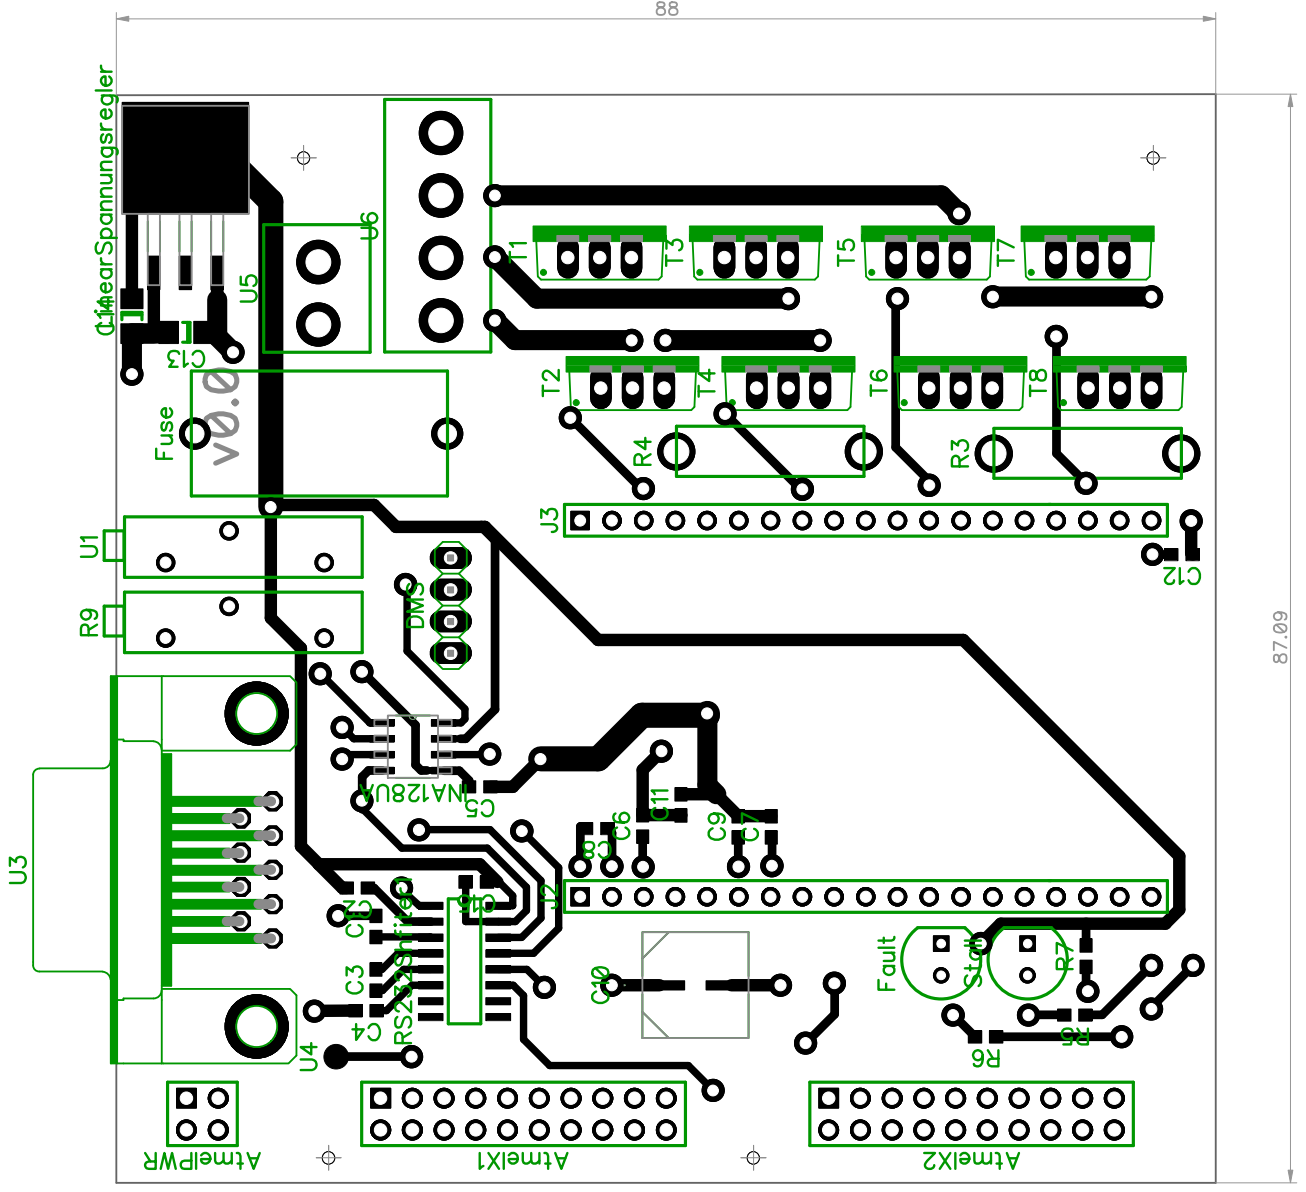
[picture p83: page 1]
