pasrom/grabtastic/Documenation/group_4_grabtastic/pictures/psi5321_asseblyAxisGes.pdf

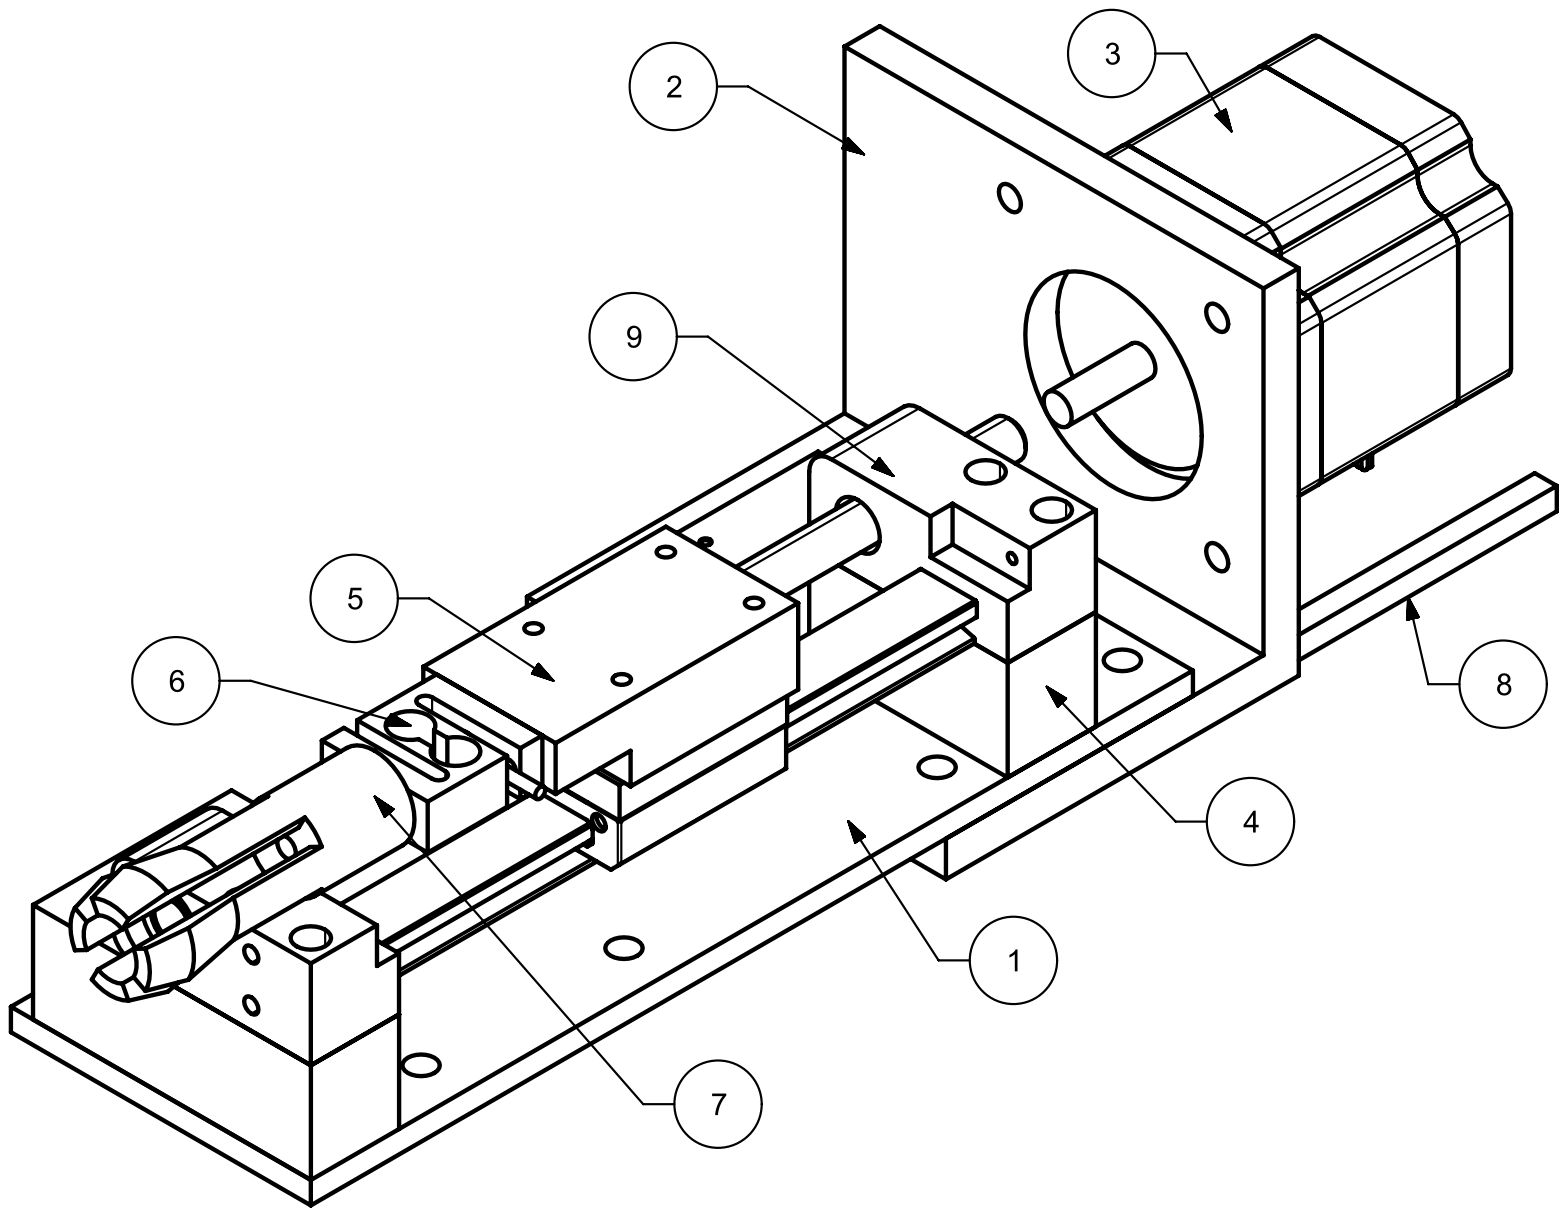
[picture p84: page 1]
