pasrom/grabtastic/(list of files, drawings)

Other design files:
Electronic_Stuff/PCB_Layout/focus_v_0_5.dch
Electronic_Stuff/PCB_Layout/focus_v_0_5.dip
